chaseyarnall173/Self-Landing-Rocket/cad/out/mass_report.md

# SLR-1 mass report (from the CAD)

Generated by `python cad/build.py`. Masses are CAD volume x material density for made parts and
catalogue / estimated masses for bought parts (see `cad/slr1/catalog.py` and each part's
`mass_g`). **Weigh every part as you build and replace these numbers.**

| Configuration | Mass | CG station | Pitch inertia |
|---|---:|---:|---:|
| Liftoff (flight, legs stowed) | 1472 g | 970 mm | 0.247 kg m^2 |
| Same, landing configuration (legs and airbrakes out) | 1471 g | 997 mm | 0.283 kg m^2 |
| Dry (no motors) | 1294 g | 907 mm | 0.204 kg m^2 |

Model-rocket limit 1500 g: margin **28 g**.

## By mass-budget line

| Line | CAD (g) | CG station (mm) | Rev B paper budget (g) |
|---|---:|---:|---:|
| Nose cone + shoulder | 99.1 | 244 | 95 |
| Top airbrake petals, hinges, springs, latch servo | 21.3 | 471 | 35 |
| Backup chute + shock cord + spring/servo door | 96.9 | 630 | 85 |
| Avionics bay: boards, sensors, radio, battery | 111.7 | 768 | 105 |
| Couplers, bulkheads, motor-bay frame | 250.4 | 861 | 80 |
| Body tube | 402.0 | 923 | 374 |
| 4 landing legs + release | 100.5 | 1090 | 85 |
| Wiring, hardware, epoxy, paint | 37.8 | 1132 | 45 |
| Dual-motor TVC gimbal + 2 servos | 93.8 | 1427 | 130 |
| Ascent motor AeroTech F42T | 81.4 | 1429 | 76 |
| Landing motor AeroTech F25W | 97.2 | 1436 | 97 |
| 4 fins | 37.3 | 1472 | 45 |
| Exhaust-paddle throttle | 32.6 | 1493 | 50 |
| Lidar + bracket | 10.3 | 1504 | 12 |
| **Total** | **1472** | **970** | **1314** |

## Heaviest parts

| Part | Qty | Each (g) | Total (g) |
|---|---:|---:|---:|
| TUBE-04: Aft airframe, kraft tube (731 mm), fin and leg slots | 1 | 244.8 | 244.8 |
| NOSE-01: Nose cone, PETG tangent ogive 12.75 in + 2 in shoulder | 1 | 99.1 | 99.1 |
| MOTOR-F25W: AeroTech F25W landing motor (29 x 98 mm, 97 g) | 1 | 97.2 | 97.2 |
| MOTOR-F52C: AeroTech F52C ascent motor (29 x 111 mm, 81 g) | 1 | 81.4 | 81.4 |
| CPL-02: Avionics-bay coupler, LOC 3.9 in (160 mm) | 1 | 74.0 | 74.0 |
| TUBE-02: Recovery section, kraft tube (223 mm) with door cut-out | 1 | 67.6 | 67.6 |
| PETAL-01: Airbrake petal, 90 deg quadrant cut from the tube (149 mm) | 4 | 12.4 | 49.7 |
| CPL-01: Airbrake sleeve, LOC 3.9 in coupler (189 mm), latch slots + 4 lightening windows | 1 | 43.4 | 43.4 |
| CHUTE-30: Backup main parachute, 30 in nylon, Z-folded | 1 | 42.0 | 42.0 |
| LEG-STRUT: Leg strut, 8 x 7 mm pultruded carbon tube, 532 mm | 4 | 9.7 | 38.9 |
| FIN-01: Fin, 3/32 in aircraft birch ply, through-the-wall | 4 | 9.3 | 37.3 |
| LINER-AFT: Aft carbon liner, 2 wraps 200 gsm + epoxy (6 in), slotted | 1 | 35.0 | 35.0 |
| LIPO-2S: 2S 450 mAh LiPo | 1 | 30.0 | 30.0 |
| TUBE-01: Nose ring, LOC 3.9 in kraft tube (71 mm) | 1 | 24.0 | 24.0 |
| PERFBOARD: Perfboard 54 x 120 mm (flight computer carrier) | 1 | 19.2 | 19.2 |
| HARNESS-AFT: Servo / pyro harness to the motor bay (bundle) | 1 | 18.0 | 18.0 |
| AV-LID-F: Avionics bay forward lid, 1/8 in ply | 1 | 16.6 | 16.6 |
| RECOV-BH: Recovery bulkhead, 1/8 in ply, U-bolt + cable holes | 1 | 16.5 | 16.5 |
| AV-LID-A: Avionics bay aft lid, 1/8 in ply, grommet + cable holes | 1 | 16.4 | 16.4 |
| SLEEVE-29: 29 mm motor sleeve, kraft motor-mount tube, 113 mm (high-temp epoxy) | 2 | 8.1 | 16.2 |
| AV-SLED: Avionics sled, 1/8 in lite ply | 1 | 14.8 | 14.8 |
| LEG-CLEVIS: Leg hinge clevis with 55 deg stop, CF-nylon | 4 | 3.5 | 14.2 |
| CHUTE-NOMEX: Nomex chute protector (9 in), wrapped | 1 | 14.0 | 14.0 |
| SHOCK-CORD: Kevlar shock cord, 4.5 m, flaked and bundled | 1 | 14.0 | 14.0 |
| LEG-FOOT: Foot, TPU-95A lattice crush pad (30 mm) | 4 | 3.4 | 13.7 |

## Densities used

| Material | g/cm^3 |
|---|---:|
| aluminium | 2.7 |
| carbon | 1.55 |
| ceramic | 2.3 |
| cf_nylon | 1.17 |
| epoxy | 1.15 |
| kraft | 0.844 |
| kraft_cpl | 0.844 |
| liteply | 0.45 |
| perfboard | 1.85 |
| petg | 1.27 |
| ply | 0.68 |
| polycarb | 1.2 |
| steel | 7.9 |
| tpu | 1.21 |
