chaseyarnall173/Self-Landing-Rocket/docs/14-sections.md

# 14. Section by section

Every part of SLR-1, bay by bay: 133 parts in 8 sections. Each section has X-ray views
rendered from the CAD, with the outer skin see-through and every part numbered. The numbers match
the table under the views. A dashed leader points to a part hidden behind others.

Masses are from the CAD (catalogue masses for bought parts). *Qty* counts every copy on the rocket.
The same guide is on the project website, and the interactive viewer
([docs/13](13-cad.md)) has a *Sections* mode that draws these callouts live.

- [14.1 Nose cone](#141-nose-cone)
- [14.2 Top airbrakes](#142-top-airbrakes)
- [14.3 Backup chute bay](#143-backup-chute-bay)
- [14.4 Avionics bay](#144-avionics-bay)
- [14.5 Aft airframe and fins](#145-aft-airframe-and-fins)
- [14.6 Landing legs](#146-landing-legs)
- [14.7 Motor bay and TVC gimbal](#147-motor-bay-and-tvc-gimbal)
- [14.8 Exhaust-paddle throttle](#148-exhaust-paddle-throttle)

## 14.1 Nose cone

The printed nose is the top 323 mm of the rocket. It comes off (three screws) so you can reach the airbrake latch.

**2 parts, 4 pieces, 101 g.**

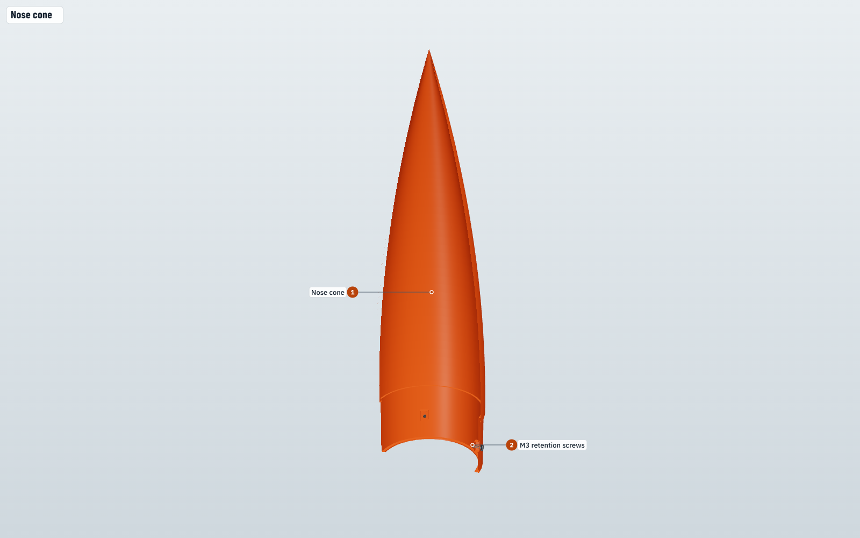
[picture p14: docs/img/sections/nose-1.png]
Nose cone


| | # | Part | What it does | Made from | Qty | Mass (g) |
|---|---:|---|---|---|---:|---:|
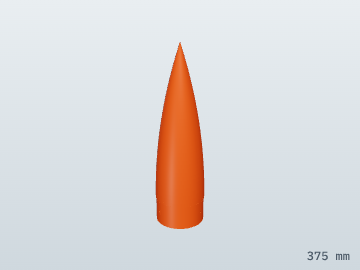
[picture p15: docs/img/parts/NOSE-01.png]
Nose cone
|  | 1 | **Nose cone**<br>`NOSE-01` | Printed PETG tangent ogive, 0.8 mm wall. Its 2 in shoulder slides into the nose ring. Three printed bosses inside take the retention screws. | Print · PETG | 1 | 99 |
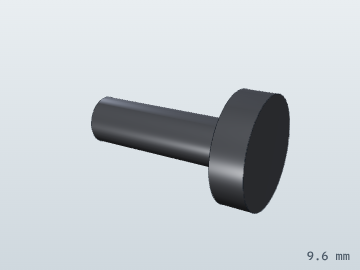
[picture p16: docs/img/parts/NOSE-SCREW.png]
M3 retention screws
|  | 2 | **M3 retention screws**<br>`NOSE-SCREW` | Hold the nose on through the nose ring. Take them out to lift the nose off and reach the airbrake latch. | Buy · steel | 3 | 0.5 |

## 14.2 Top airbrakes

Four petals cut from the body tube, just below the nose. At apogee one servo turns a latch ring and springs flip all four out to 90°. Drag at the top keeps the falling rocket tail-down, the way a shuttlecock's feathers keep it cork-first.

**13 parts, 31 pieces, 138 g.**

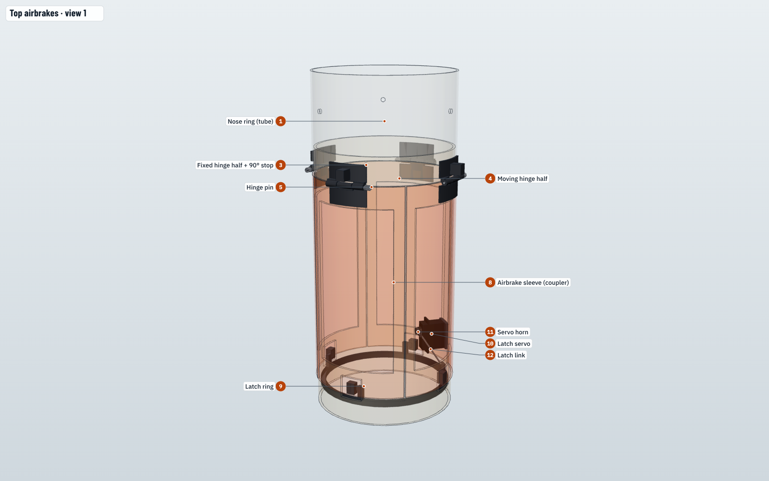
[picture p17: docs/img/sections/airbrakes-1.png]
Top airbrakes: view 1


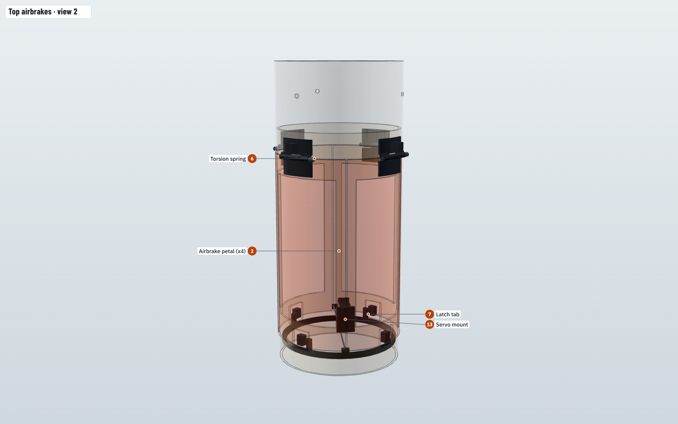
[picture p18: docs/img/sections/airbrakes-2.png]
Top airbrakes: view 2


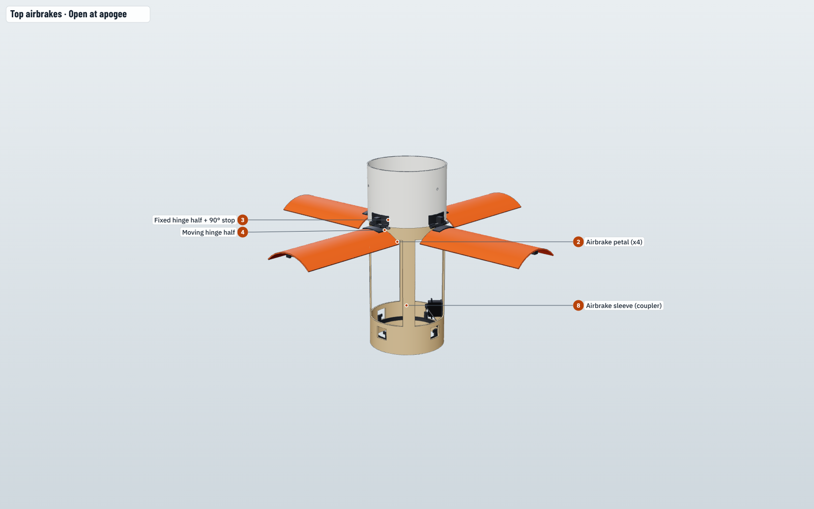
[picture p19: docs/img/sections/airbrakes-3.png]
Top airbrakes: Open at apogee


| | # | Part | What it does | Made from | Qty | Mass (g) |
|---|---:|---|---|---|---:|---:|
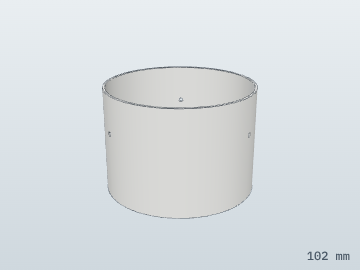
[picture p20: docs/img/parts/TUBE-01.png]
Nose ring (tube)
|  | 1 | **Nose ring (tube)**<br>`TUBE-01` | The 71 mm piece of body tube between the nose and the petals. The fixed hinge halves are bonded to it, and it is glued 19 mm onto the airbrake sleeve. | Cut from tube · kraft phenolic tube | 1 | 24 |
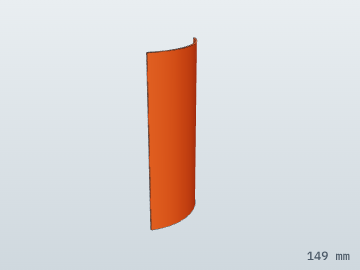
[picture p21: docs/img/parts/PETAL-01.png]
Airbrake petal (x4)
|  | 2 | **Airbrake petal (x4)**<br>`PETAL-01` | A 90° quadrant cut from the body tube, 150 mm long. Flush with the skin on the way up; springs out to 90° at apogee so the rocket falls tail-first and stable at ~18 m/s. | Cut from tube · kraft phenolic tube | 4 | 12 |
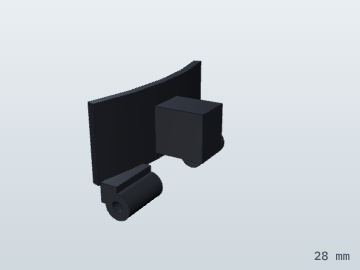
[picture p22: docs/img/parts/PETAL-HINGE-F.png]
Fixed hinge half + 90° stop
|  | 3 | **Fixed hinge half + 90° stop**<br>`PETAL-HINGE-F` | Printed CF-nylon leaf bonded to the nose ring with two knuckles. Its stop block catches the open petal at 90° against ~3 N of air load. | Print · CF-nylon | 4 | 1.1 |
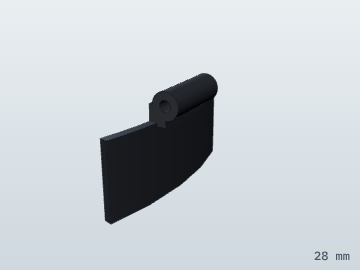
[picture p23: docs/img/parts/PETAL-HINGE-M.png]
Moving hinge half
|  | 4 | **Moving hinge half**<br>`PETAL-HINGE-M` | Printed CF-nylon leaf bonded to the petal's forward edge; its middle knuckle turns on the hinge pin. | Print · CF-nylon | 4 | 0.6 |
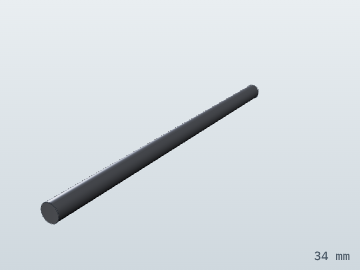
[picture p24: docs/img/parts/PETAL-PIN.png]
|  | 5 | **Hinge pin**<br>`PETAL-PIN` | 1.6 mm stainless pin through the three knuckles; it also carries the torsion spring. | Buy · steel | 4 | 0.5 |
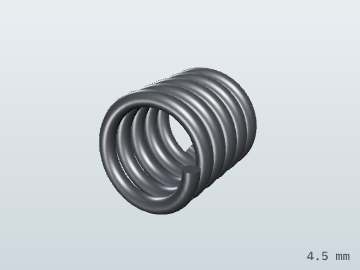
[picture p25: docs/img/parts/PETAL-SPRING.png]
Torsion spring
|  | 6 | **Torsion spring**<br>`PETAL-SPRING` | About 0.1 N·m of preload that flips the petal open in under 0.2 s when the latch lets go. | Buy · steel | 4 | 0.1 |
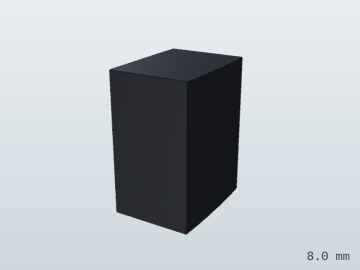
[picture p26: docs/img/parts/PETAL-TAB.png]
Latch tab
|  | 7 | **Latch tab**<br>`PETAL-TAB` | Printed tab bonded inside the petal's aft edge. It pokes through the sleeve slot, and its notch is where the latch-ring finger sits. | Print · CF-nylon | 4 | 0.2 |
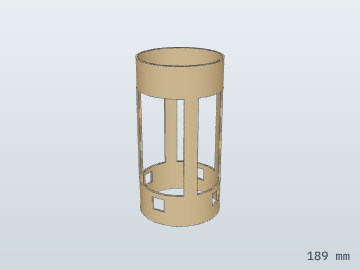
[picture p27: docs/img/parts/CPL-01.png]
Airbrake sleeve (coupler)
|  | 8 | **Airbrake sleeve (coupler)**<br>`CPL-01` | 189 mm LOC coupler that holds the nose ring and the recovery section together across the petal band. Windows under each petal save 33 g; slots let the petal tabs through. | Cut from tube · kraft coupler tube | 1 | 43 |
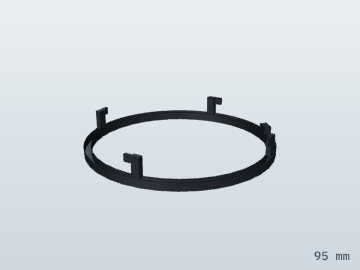
[picture p28: docs/img/parts/LATCH-RING.png]
Latch ring
|  | 9 | **Latch ring**<br>`LATCH-RING` | Printed ring inside the sleeve with one finger per petal. Turning it a few degrees slides all four fingers out of the tab notches at once. | Print · CF-nylon | 1 | 5.2 |
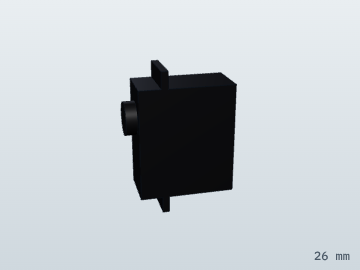
[picture p29: docs/img/parts/SERVO-LATCH.png]
Latch servo
|  | 10 | **Latch servo**<br>`SERVO-LATCH` | 4.3 g micro servo (pin 7) that turns the latch ring at apogee. | Buy · servo | 1 | 4.3 |
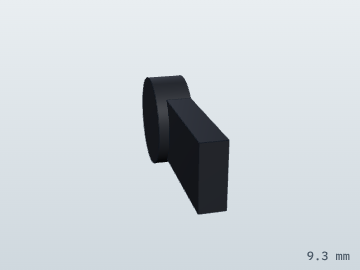
[picture p30: docs/img/parts/HORN-LATCH.png]
Servo horn
|  | 11 | **Servo horn**<br>`HORN-LATCH` | Arm on the latch servo's output shaft. | Buy · CF-nylon | 1 | 0.3 |
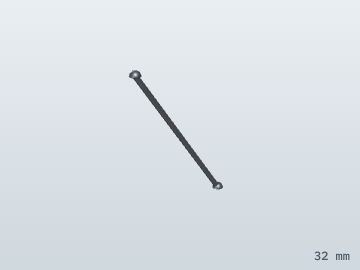
[picture p31: docs/img/parts/LATCH-LINK.png]
Latch link
|  | 12 | **Latch link**<br>`LATCH-LINK` | Wire link with ball ends from the horn to the latch ring's lug. | Buy · steel | 1 | 0.3 |
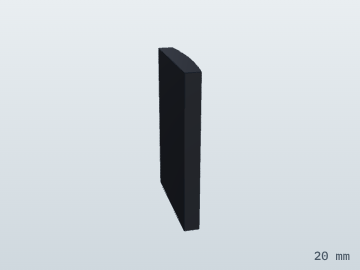
[picture p32: docs/img/parts/LATCH-SERVO-BRKT.png]
Servo mount
|  | 13 | **Servo mount**<br>`LATCH-SERVO-BRKT` | Printed block that bonds the latch servo to the solid strip of sleeve between two windows. | Print · CF-nylon | 1 | 0.7 |

## 14.3 Backup chute bay

Abort-only recovery. A servo pulls a pin, the door swings open and two springs push the 30 in chute out. In a normal flight this bay never opens.

**22 parts, 25 pieces, 193 g.**

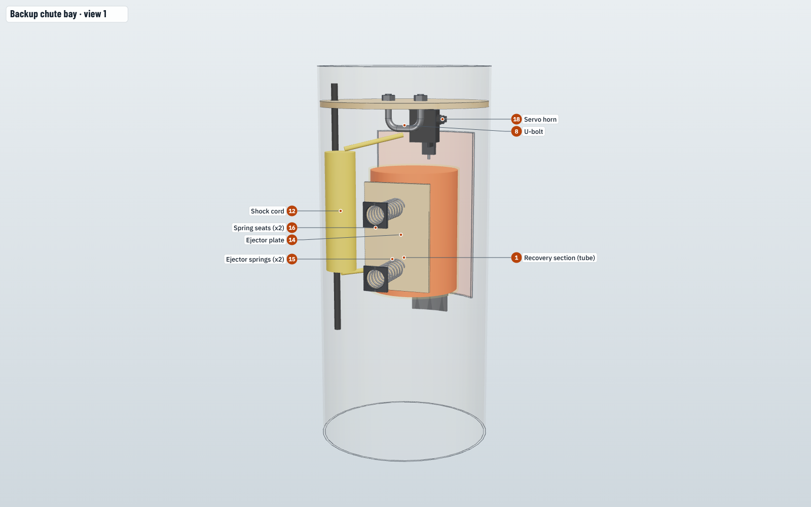
[picture p33: docs/img/sections/chute-1.png]
Backup chute bay: view 1


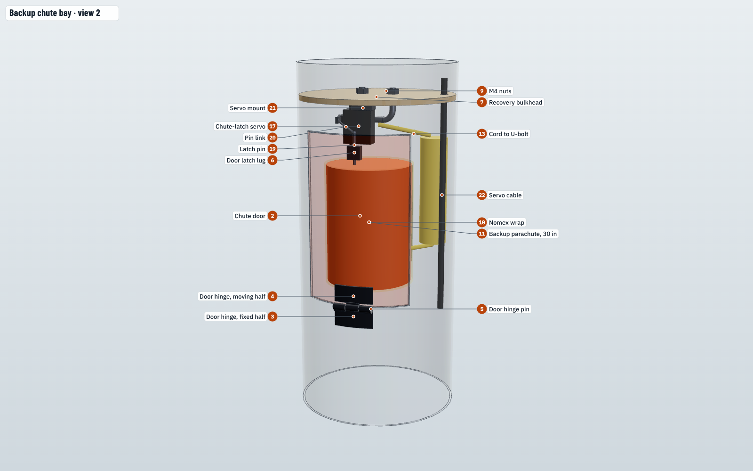
[picture p34: docs/img/sections/chute-2.png]
Backup chute bay: view 2


| | # | Part | What it does | Made from | Qty | Mass (g) |
|---|---:|---|---|---|---:|---:|
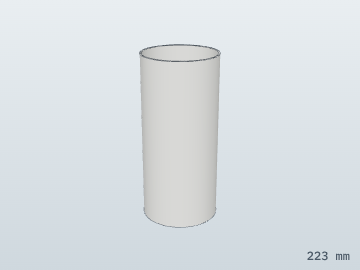
[picture p35: docs/img/parts/TUBE-02.png]
Recovery section (tube)
|  | 1 | **Recovery section (tube)**<br>`TUBE-02` | 223 mm of body tube between the petals and the avionics bay. It holds the chute bay and has the door cut out of it. | Cut from tube · kraft phenolic tube | 1 | 68 |
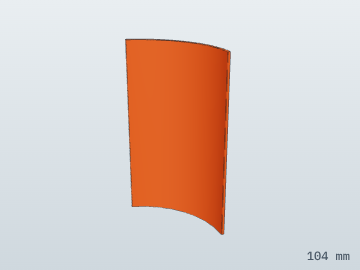
[picture p36: docs/img/parts/DOOR-01.png]
Chute door
|  | 2 | **Chute door**<br>`DOOR-01` | 105 x 70 mm panel cut from the tube. It is latched shut in a normal flight; in an abort it swings open and the chute is pushed out. | Cut from tube · kraft phenolic tube | 1 | 7.6 |
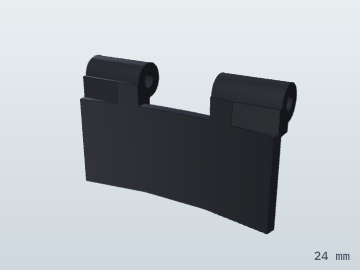
[picture p37: docs/img/parts/DOOR-HINGE-F.png]
Door hinge, fixed half
|  | 3 | **Door hinge, fixed half**<br>`DOOR-HINGE-F` | Printed hinge leaf on the tube at the door's aft edge. | Print · CF-nylon | 1 | 0.6 |
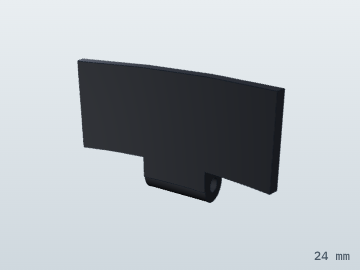
[picture p38: docs/img/parts/DOOR-HINGE-M.png]
Door hinge, moving half
|  | 4 | **Door hinge, moving half**<br>`DOOR-HINGE-M` | Printed hinge leaf on the door. | Print · CF-nylon | 1 | 0.5 |
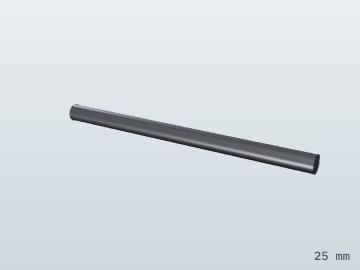
[picture p39: docs/img/parts/DOOR-PIN.png]
Door hinge pin
|  | 5 | **Door hinge pin**<br>`DOOR-PIN` | 1.6 mm stainless pin through the door hinge. | Buy · steel | 1 | 0.4 |
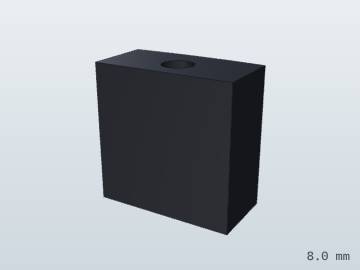
[picture p40: docs/img/parts/DOOR-LUG.png]
Door latch lug
|  | 6 | **Door latch lug**<br>`DOOR-LUG` | Printed lug inside the door's forward edge; the chute-latch pin passes through it to hold the door shut. | Print · CF-nylon | 1 | 0.3 |
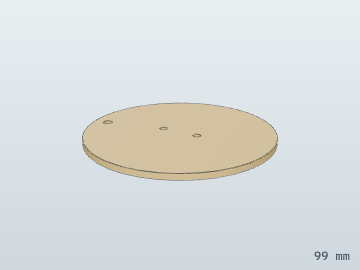
[picture p41: docs/img/parts/RECOV-BH.png]
Recovery bulkhead
|  | 7 | **Recovery bulkhead**<br>`RECOV-BH` | 1/8 in ply disc glued in the tube at the top of the chute bay. It carries the U-bolt and separates the bay from the airbrake sleeve. | Cut · birch ply | 1 | 17 |
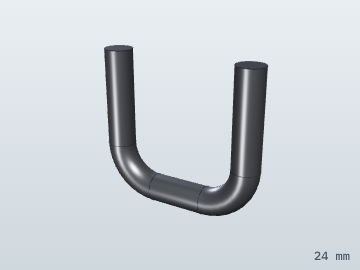
[picture p42: docs/img/parts/UBOLT.png]
U-bolt
|  | 8 | **U-bolt**<br>`UBOLT` | M4 U-bolt: the strong point the shock cord and chute hang from. | Buy · steel | 1 | 8.0 |
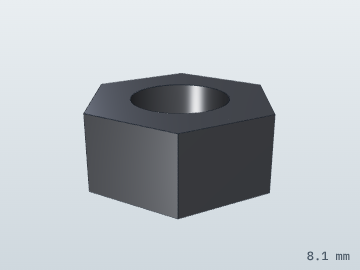
[picture p43: docs/img/parts/NUT-M4.png]
M4 nuts
|  | 9 | **M4 nuts**<br>`NUT-M4` | Clamp the U-bolt to the bulkhead. | Buy · steel | 2 | 1.2 |
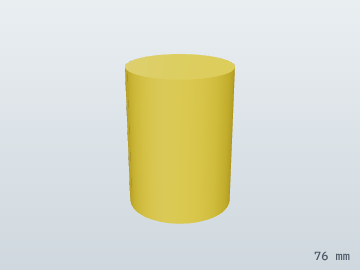
[picture p44: docs/img/parts/CHUTE-NOMEX.png]
Nomex wrap
|  | 10 | **Nomex wrap**<br>`CHUTE-NOMEX` | Fire-resistant blanket wrapped around the folded chute, in case the motors' heat reaches it. | Buy · Nomex | 1 | 14 |
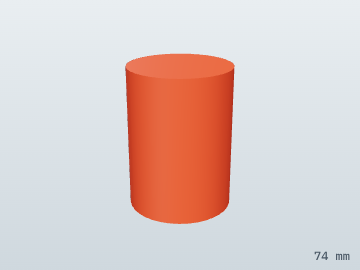
[picture p45: docs/img/parts/CHUTE-30.png]
Backup parachute, 30 in
|  | 11 | **Backup parachute, 30 in**<br>`CHUTE-30` | Nylon chute, Z-folded to about 54 x 74 mm. Used only in an abort; it brings 1.4 kg down at about 5-6 m/s. | Buy · ripstop nylon | 1 | 42 |
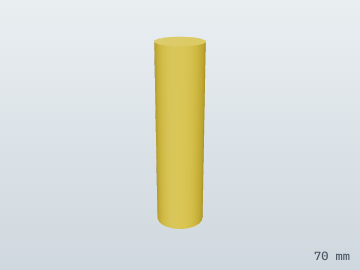
[picture p46: docs/img/parts/SHOCK-CORD.png]
Shock cord
|  | 12 | **Shock cord**<br>`SHOCK-CORD` | 4.5 m of Kevlar, flaked and bundled. It absorbs the snatch when the chute opens. | Buy · Kevlar | 1 | 14 |
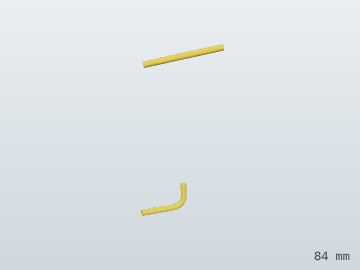
[picture p47: docs/img/parts/SHOCK-CORD-RUN.png]
Cord to U-bolt
|  | 13 | **Cord to U-bolt**<br>`SHOCK-CORD-RUN` | The ends of the shock cord: one tied to the U-bolt, one to the chute's riser. | Buy · Kevlar | 1 | 2.0 |
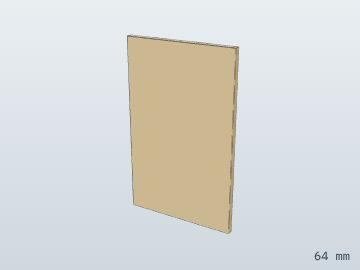
[picture p48: docs/img/parts/EJECT-PLATE.png]
Ejector plate
|  | 14 | **Ejector plate**<br>`EJECT-PLATE` | Thin ply plate on two springs that pushes the chute pack toward the door. | Cut · birch ply | 1 | 3.5 |
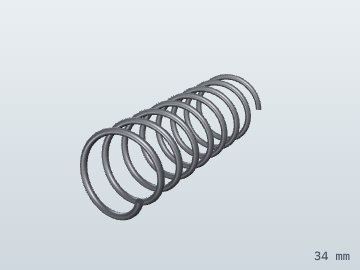
[picture p49: docs/img/parts/EJECT-SPRING.png]
Ejector springs (x2)
|  | 15 | **Ejector springs (x2)**<br>`EJECT-SPRING` | Compression springs, ~20 N each, that throw the chute out when the door opens. | Buy · steel | 2 | 1.5 |
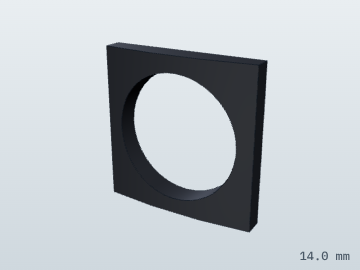
[picture p50: docs/img/parts/EJECT-CUP.png]
Spring seats (x2)
|  | 16 | **Spring seats (x2)**<br>`EJECT-CUP` | Printed cups bonded to the far wall that locate the ejector springs. | Print · CF-nylon | 2 | 0.2 |
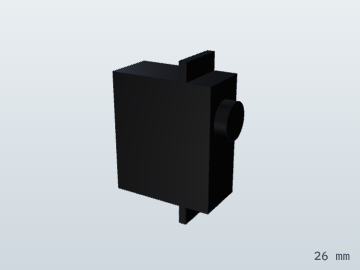
[picture p51: docs/img/parts/SERVO-CHUTE.png]
Chute-latch servo
|  | 17 | **Chute-latch servo**<br>`SERVO-CHUTE` | 4.3 g micro servo (pin 29) under the bulkhead. It pulls the latch pin to open the door. | Buy · servo | 1 | 4.3 |
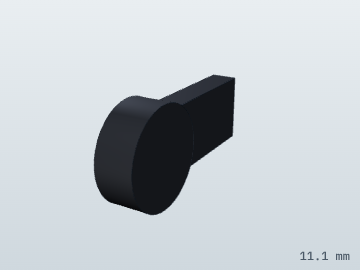
[picture p52: docs/img/parts/HORN-CHUTE.png]
Servo horn
|  | 18 | **Servo horn**<br>`HORN-CHUTE` | Arm on the chute-latch servo. | Buy · CF-nylon | 1 | 0.3 |
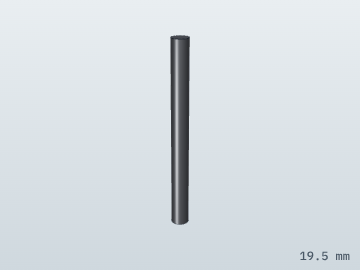
[picture p53: docs/img/parts/CHUTE-PIN.png]
Latch pin
|  | 19 | **Latch pin**<br>`CHUTE-PIN` | 1.8 mm steel pin through the door lug. Pulling it releases the door. | Buy · steel | 1 | 0.4 |
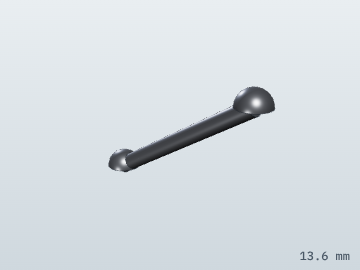
[picture p54: docs/img/parts/CHUTE-LINK.png]
Pin link
|  | 20 | **Pin link**<br>`CHUTE-LINK` | Wire link from the servo horn to the latch pin. | Buy · steel | 1 | 0.4 |
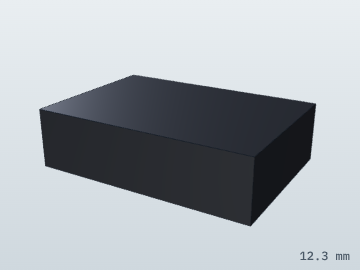
[picture p55: docs/img/parts/CHUTE-SERVO-BRKT.png]
Servo mount
|  | 21 | **Servo mount**<br>`CHUTE-SERVO-BRKT` | Printed block that bonds the servo to the bulkhead. | Print · CF-nylon | 1 | 0.4 |
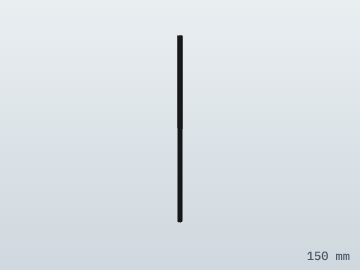
[picture p56: docs/img/parts/CABLE-FWD.png]
Servo cable
|  | 22 | **Servo cable**<br>`CABLE-FWD` | Runs the airbrake-latch and chute-latch servo leads up from the avionics bay through the bulkhead. | Buy · electronics | 1 | 4.0 |

## 14.4 Avionics bay

The flight computer, sensors, radio and battery on a sled that slides out. The switch band around the middle carries the arm key, the power switch, the static ports and the leg-release pin.

**37 parts, 59 pieces, 261 g.**

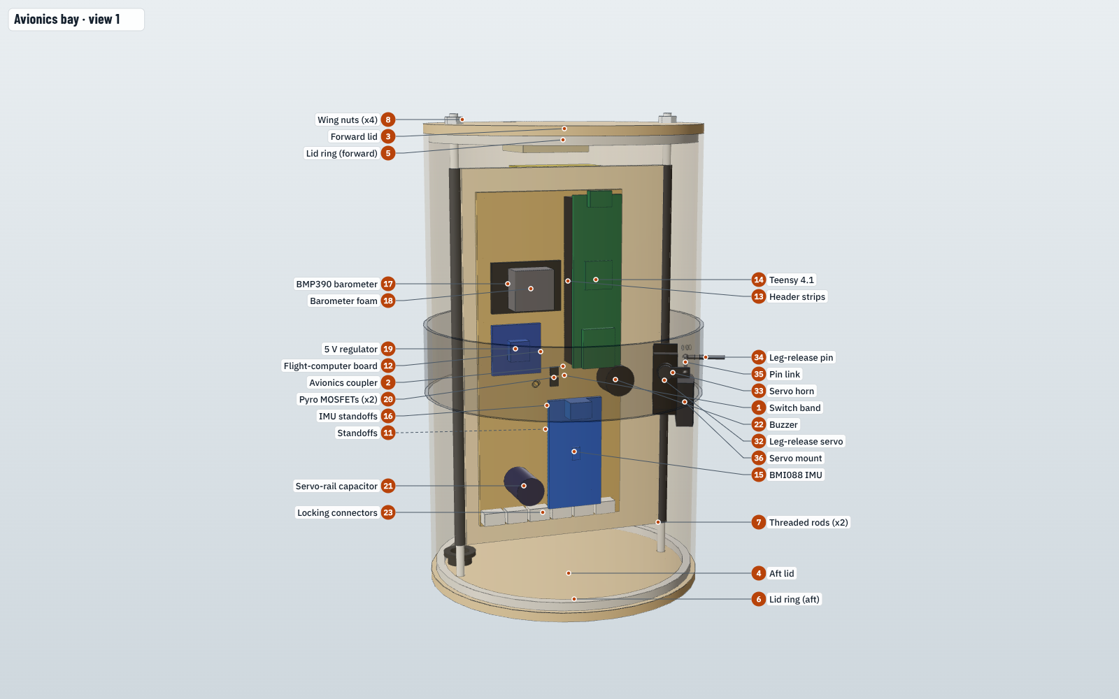
[picture p57: docs/img/sections/avionics-1.png]
Avionics bay: view 1


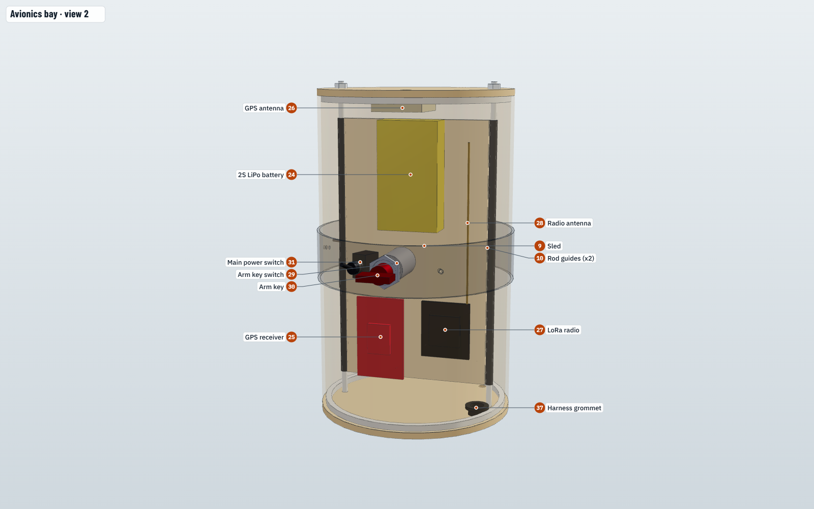
[picture p58: docs/img/sections/avionics-2.png]
Avionics bay: view 2


| | # | Part | What it does | Made from | Qty | Mass (g) |
|---|---:|---|---|---|---:|---:|
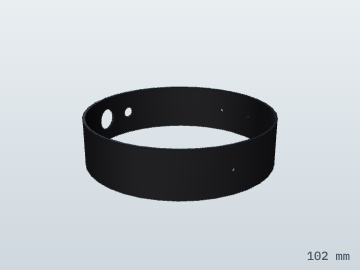
[picture p59: docs/img/parts/TUBE-03.png]
Switch band
|  | 1 | **Switch band**<br>`TUBE-03` | 25 mm ring of body tube glued around the middle of the avionics coupler. It carries the arm key, main switch, leg-release pin and three static ports. | Cut from tube · kraft phenolic tube | 1 | 8.3 |
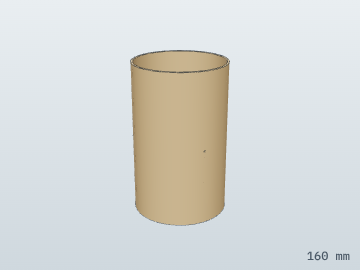
[picture p60: docs/img/parts/CPL-02.png]
Avionics coupler
|  | 2 | **Avionics coupler**<br>`CPL-02` | 160 mm LOC coupler that is the avionics bay. It joins the recovery section to the aft tube. | Cut from tube · kraft coupler tube | 1 | 74 |
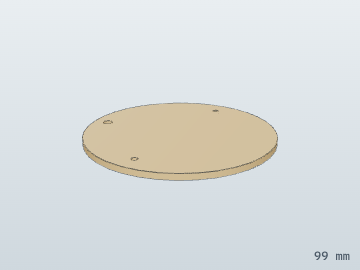
[picture p61: docs/img/parts/AV-LID-F.png]
Forward lid
|  | 3 | **Forward lid**<br>`AV-LID-F` | 1/8 in ply disc that closes the top of the bay; the GPS patch hangs under it. | Cut · birch ply | 1 | 17 |
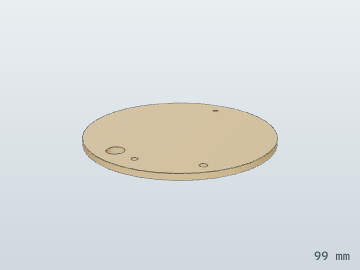
[picture p62: docs/img/parts/AV-LID-A.png]
Aft lid
|  | 4 | **Aft lid**<br>`AV-LID-A` | 1/8 in ply disc that closes the bottom of the bay, with the harness grommet and lidar-cable hole. | Cut · birch ply | 1 | 16 |
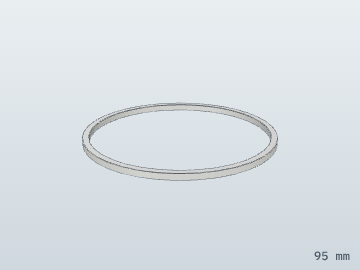
[picture p63: docs/img/parts/AV-LID-RING-F.png]
Lid ring (forward)
|  | 5 | **Lid ring (forward)**<br>`AV-LID-RING-F` | Printed ring that keys the forward lid into the coupler. | Print · PETG | 1 | 3.2 |
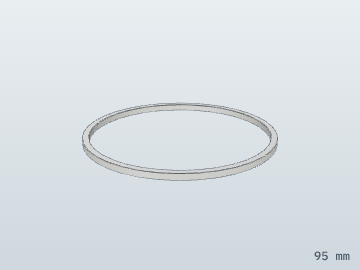
[picture p64: docs/img/parts/AV-LID-RING-A.png]
Lid ring (aft)
|  | 6 | **Lid ring (aft)**<br>`AV-LID-RING-A` | Printed ring that keys the aft lid into the coupler. | Print · PETG | 1 | 3.2 |
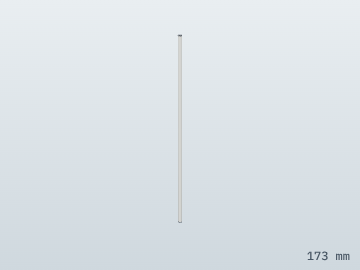
[picture p65: docs/img/parts/AV-ROD.png]
Threaded rods (x2)
|  | 7 | **Threaded rods (x2)**<br>`AV-ROD` | M3 nylon rods that clamp the two lids to the coupler and guide the sled. | Buy · CF-nylon | 2 | 1.4 |
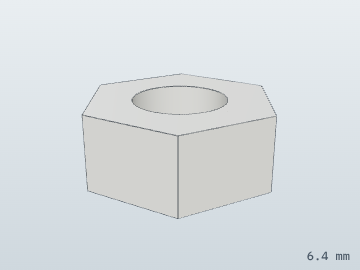
[picture p66: docs/img/parts/NUT-M3.png]
Wing nuts (x4)
|  | 8 | **Wing nuts (x4)**<br>`NUT-M3` | Nylon wing nuts on the rod ends; finger-tight so the bay opens on the field. | Buy · CF-nylon | 4 | 0.2 |
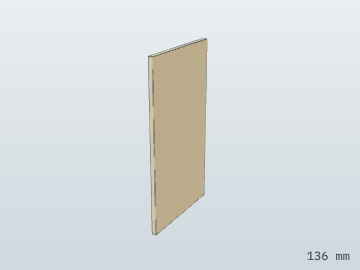
[picture p67: docs/img/parts/AV-SLED.png]
Sled
|  | 9 | **Sled**<br>`AV-SLED` | 1/8 in lite-ply board everything electronic mounts to. It slides out on the rods. | Cut · lite ply | 1 | 15 |
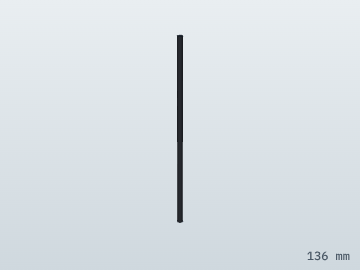
[picture p68: docs/img/parts/AV-SLED-TUBE.png]
Rod guides (x2)
|  | 10 | **Rod guides (x2)**<br>`AV-SLED-TUBE` | Printed tubes along the sled edges that ride on the threaded rods. | Print · CF-nylon | 2 | 0.7 |
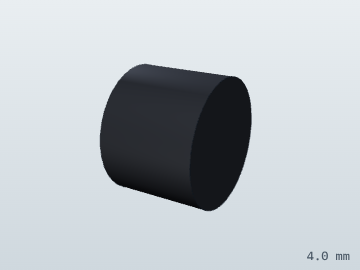
[picture p69: docs/img/parts/STANDOFF-3.png]
Standoffs
|  | 11 | **Standoffs**<br>`STANDOFF-3` | 3 mm nylon spacers under the boards. | Buy · CF-nylon | 12 | 0.1 |
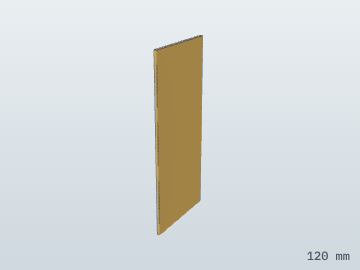
[picture p70: docs/img/parts/PERFBOARD.png]
Flight-computer board
|  | 12 | **Flight-computer board**<br>`PERFBOARD` | 54 x 120 mm perfboard carrying the Teensy, sensors, regulator and pyro channels. Becomes a PCB once the design is frozen. | Buy · perfboard | 1 | 19 |
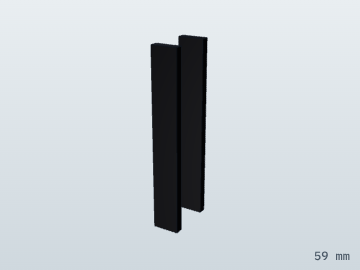
[picture p71: docs/img/parts/HEADERS.png]
Header strips
|  | 13 | **Header strips**<br>`HEADERS` | Sockets the Teensy plugs into, so it can be swapped. | Buy · electronics | 1 | 2.0 |
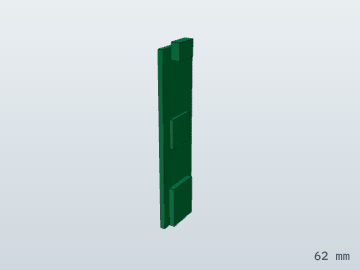
[picture p72: docs/img/parts/TEENSY-41.png]
Teensy 4.1
|  | 14 | **Teensy 4.1**<br>`TEENSY-41` | The flight computer: a 600 MHz microcontroller that runs the 1 kHz state estimator and re-plans the landing burn 50 times a second, logging everything to its microSD card. | Buy · circuit board | 1 | 6.0 |
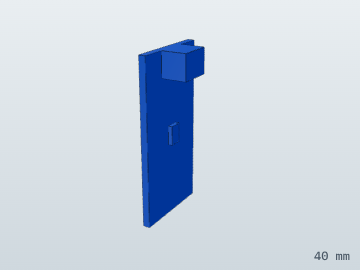
[picture p73: docs/img/parts/IMU-BMI088.png]
BMI088 IMU
|  | 15 | **BMI088 IMU**<br>`IMU-BMI088` | Accelerometer (±24 g) and gyro. Mounted near the rocket's axis so it reads attitude and acceleration cleanly. | Buy · circuit board | 1 | 3.0 |
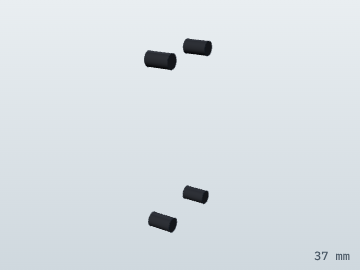
[picture p74: docs/img/parts/STANDOFF-5.png]
IMU standoffs
|  | 16 | **IMU standoffs**<br>`STANDOFF-5` | Four 5 mm standoffs that mount the IMU rigidly. | Buy · CF-nylon | 1 | 0.3 |
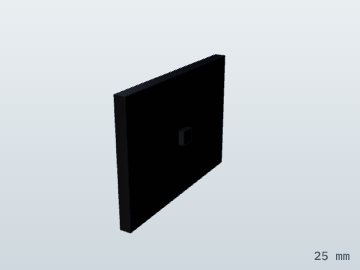
[picture p75: docs/img/parts/BARO-BMP390.png]
BMP390 barometer
|  | 17 | **BMP390 barometer**<br>`BARO-BMP390` | Measures air pressure for altitude through the whole flight, through the static ports. | Buy · circuit board | 1 | 1.5 |
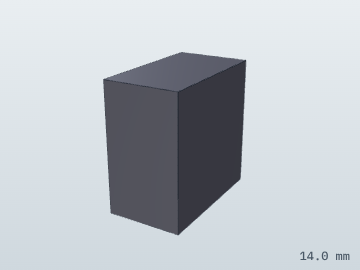
[picture p76: docs/img/parts/BARO-FOAM.png]
Barometer foam
|  | 18 | **Barometer foam**<br>`BARO-FOAM` | Open-cell foam that shields the barometer from gusts and light. | Buy · foam | 1 | 0.1 |
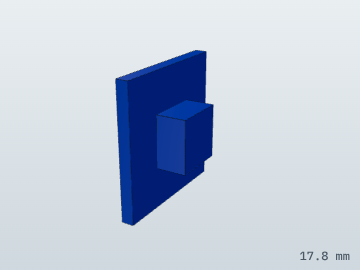
[picture p77: docs/img/parts/BUCK-5V.png]
5 V regulator
|  | 19 | **5 V regulator**<br>`BUCK-5V` | Steps the 2S battery down to 5 V for the Teensy, lidar and micro servos. | Buy · circuit board | 1 | 3.0 |
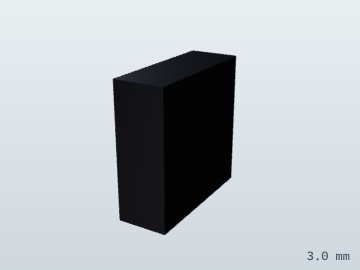
[picture p78: docs/img/parts/FET-AO3400.png]
Pyro MOSFETs (x2)
|  | 20 | **Pyro MOSFETs (x2)**<br>`FET-AO3400` | Switch the two landing-motor igniters, fired together. | Buy · electronics | 2 | 0.1 |
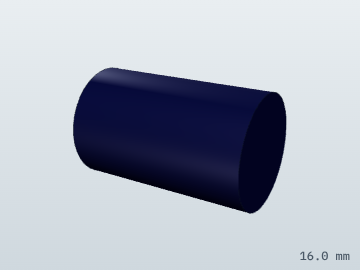
[picture p79: docs/img/parts/CAP-1000U.png]
Servo-rail capacitor
|  | 21 | **Servo-rail capacitor**<br>`CAP-1000U` | 1000 µF reservoir that keeps servo current spikes from browning out the computer. | Buy · electronics | 1 | 3.0 |
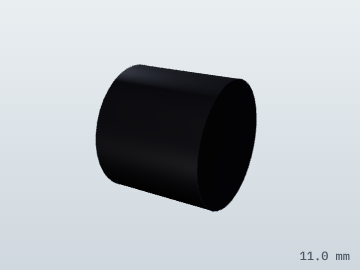
[picture p80: docs/img/parts/BUZZER.png]
Buzzer
|  | 22 | **Buzzer**<br>`BUZZER` | Beeps the arm state and status on the pad and helps you find the rocket. | Buy · electronics | 1 | 2.0 |
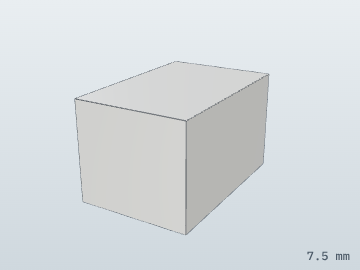
[picture p81: docs/img/parts/JST-GH.png]
Locking connectors
|  | 23 | **Locking connectors**<br>`JST-GH` | JST-GH headers for servos, sensors and the pyro leads; they can't shake loose. | Buy · electronics | 6 | 0.3 |
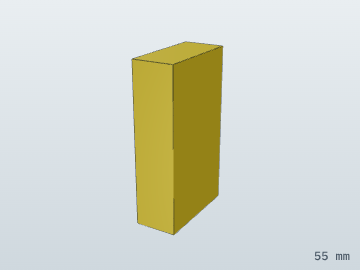
[picture p82: docs/img/parts/LIPO-2S.png]
2S LiPo battery
|  | 24 | **2S LiPo battery**<br>`LIPO-2S` | 450 mAh, 7.4 V pack that powers everything for about 15 minutes of pad time. | Buy · LiPo | 1 | 30 |
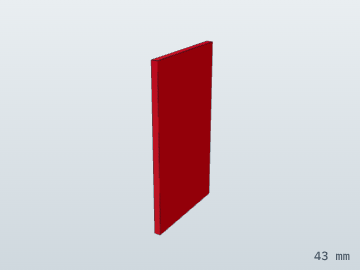
[picture p83: docs/img/parts/GPS-M9N.png]
GPS receiver
|  | 25 | **GPS receiver**<br>`GPS-M9N` | u-blox NEO-M9N; gives the sideways velocity the landing burn cancels. | Buy · circuit board | 1 | 6.0 |
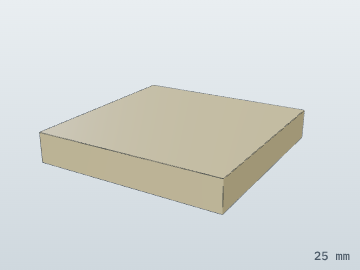
[picture p84: docs/img/parts/GPS-PATCH.png]
GPS antenna
|  | 26 | **GPS antenna**<br>`GPS-PATCH` | 25 mm ceramic patch under the forward lid, facing the sky. | Buy · ceramic | 1 | 9.0 |
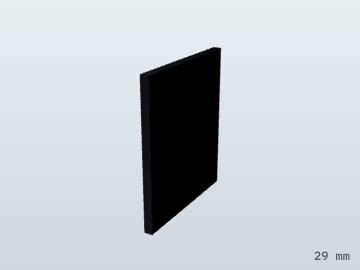
[picture p85: docs/img/parts/LORA-RFM95W.png]
LoRa radio
|  | 27 | **LoRa radio**<br>`LORA-RFM95W` | 915 MHz telemetry link to the ground station. | Buy · circuit board | 1 | 3.0 |
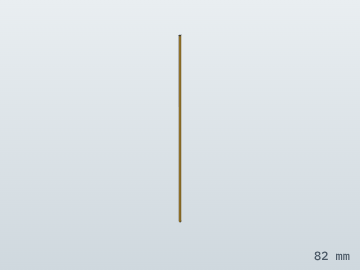
[picture p86: docs/img/parts/LORA-ANT.png]
Radio antenna
|  | 28 | **Radio antenna**<br>`LORA-ANT` | 82 mm quarter-wave wire antenna. | Buy · brass | 1 | 0.5 |
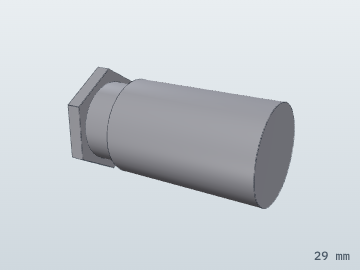
[picture p87: docs/img/parts/ARM-KEY-SW.png]
Arm key switch
|  | 29 | **Arm key switch**<br>`ARM-KEY-SW` | Physical switch in the igniter power line. Key out means the landing motor cannot fire, whatever the software does. | Buy · electronics | 1 | 12 |
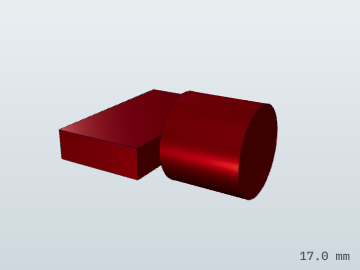
[picture p88: docs/img/parts/ARM-KEY.png]
Arm key
|  | 30 | **Arm key**<br>`ARM-KEY` | Removable key; it goes in only at the pad. | Buy · steel | 1 | 4.0 |
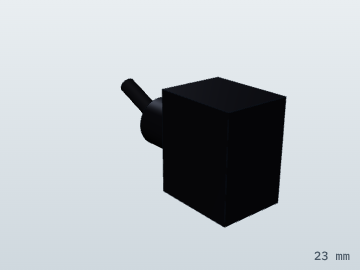
[picture p89: docs/img/parts/MAIN-SW.png]
Main power switch
|  | 31 | **Main power switch**<br>`MAIN-SW` | Turns the flight computer on. | Buy · electronics | 1 | 4.0 |
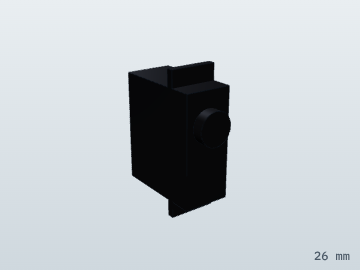
[picture p90: docs/img/parts/SERVO-LEGPIN.png]
Leg-release servo
|  | 32 | **Leg-release servo**<br>`SERVO-LEGPIN` | 4.3 g micro servo (pin 28) that pulls the leg-release pin at 12 m. | Buy · servo | 1 | 4.3 |
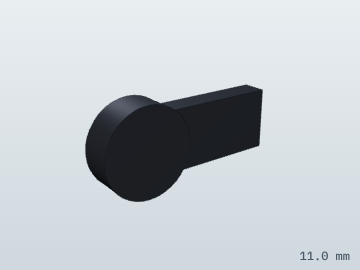
[picture p91: docs/img/parts/HORN-LEGPIN.png]
Servo horn
|  | 33 | **Servo horn**<br>`HORN-LEGPIN` | Arm on the leg-release servo. | Buy · CF-nylon | 1 | 0.3 |
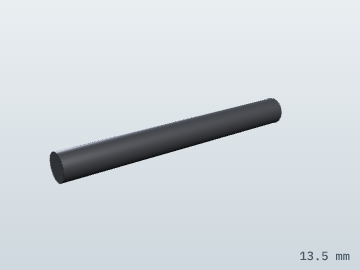
[picture p92: docs/img/parts/LEG-RELEASE-PIN.png]
Leg-release pin
|  | 34 | **Leg-release pin**<br>`LEG-RELEASE-PIN` | 1.5 mm steel pin poking out of the switch band. The Kevlar loop that holds the folded legs hooks over it. | Buy · steel | 1 | 0.2 |
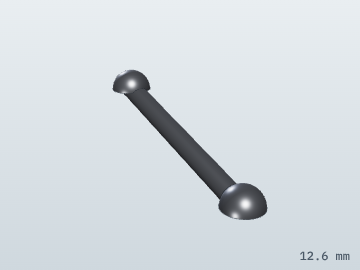
[picture p93: docs/img/parts/LEGPIN-LINK.png]
Pin link
|  | 35 | **Pin link**<br>`LEGPIN-LINK` | Wire link from the servo horn to the release pin. | Buy · steel | 1 | 0.3 |
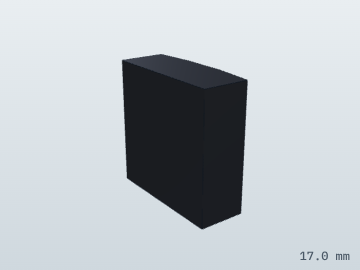
[picture p94: docs/img/parts/LEGPIN-BRKT.png]
|  | 36 | **Servo mount**<br>`LEGPIN-BRKT` | Printed block that bonds the leg-release servo to the coupler wall. | Print · CF-nylon | 1 | 1.9 |
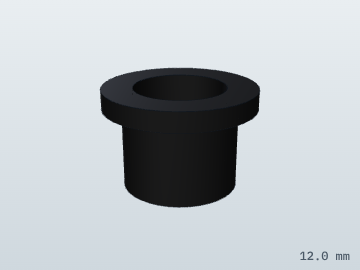
[picture p95: docs/img/parts/GROMMET.png]
Harness grommet
|  | 37 | **Harness grommet**<br>`GROMMET` | Printed TPU grommet where the servo and pyro wiring leaves the bay. | Print · TPU-95A | 1 | 0.3 |

## 14.5 Aft airframe and fins

The long aft tube carries the fins and the legs, and the wiring from the avionics bay runs down its wall to the motor bay. A carbon liner stiffens the last 6 in.

**6 parts, 16 pieces, 349 g.**

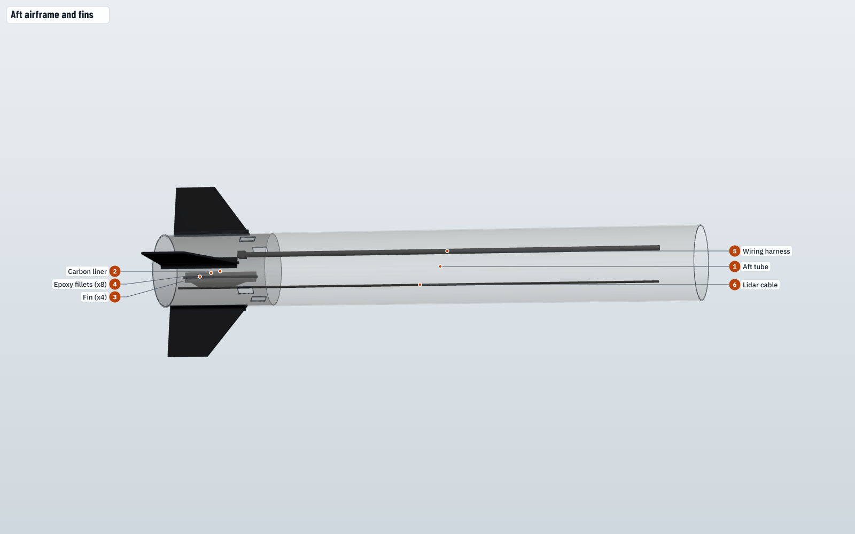
[picture p96: docs/img/sections/aft-1.png]
Aft airframe and fins


| | # | Part | What it does | Made from | Qty | Mass (g) |
|---|---:|---|---|---|---:|---:|
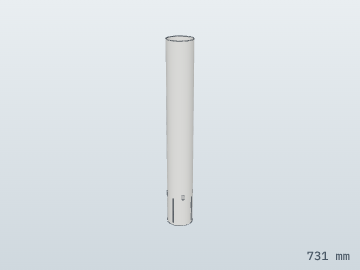
[picture p97: docs/img/parts/TUBE-04.png]
Aft tube
|  | 1 | **Aft tube**<br>`TUBE-04` | 731 mm of body tube from the avionics bay to the tail. Slotted for the fins and leg clevises. | Cut from tube · kraft phenolic tube | 1 | 245 |
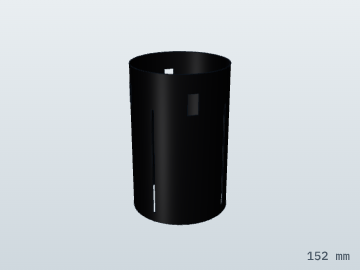
[picture p98: docs/img/parts/LINER-AFT.png]
Carbon liner
|  | 2 | **Carbon liner**<br>`LINER-AFT` | Two wraps of carbon cloth inside the last 6 in. They stiffen the tube where the fins, legs and thrust plate load it. | Lay up · carbon fibre | 1 | 35 |
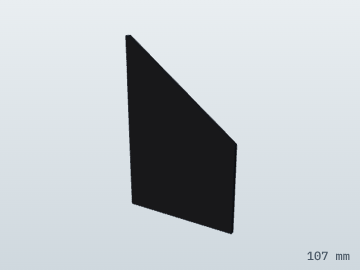
[picture p99: docs/img/parts/FIN-01.png]
Fin (x4)
|  | 3 | **Fin (x4)**<br>`FIN-01` | 3/32 in birch ply, through the wall. Keeps the rocket pointed while it coasts up with the motor out. | Cut · birch ply | 4 | 9.3 |
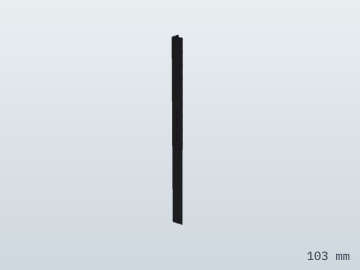
[picture p100: docs/img/parts/FIN-FILLET.png]
Epoxy fillets (x8)
|  | 4 | **Epoxy fillets (x8)**<br>`FIN-FILLET` | 6 mm epoxy fillets on both sides of each fin root; they make the joint strong. | Lay up · epoxy | 8 | 1.1 |
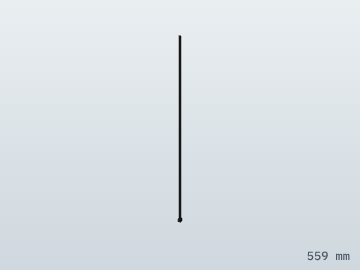
[picture p101: docs/img/parts/HARNESS-AFT.png]
Wiring harness
|  | 5 | **Wiring harness**<br>`HARNESS-AFT` | Servo and pyro wiring from the avionics bay down the tube wall to the motor bay. | Buy · electronics | 1 | 18 |
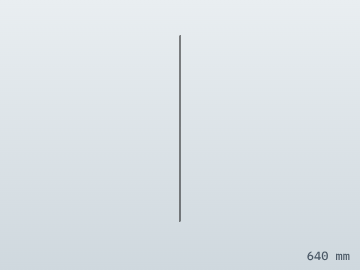
[picture p102: docs/img/parts/CABLE-LIDAR.png]
Lidar cable
|  | 6 | **Lidar cable**<br>`CABLE-LIDAR` | Runs from the avionics bay to the lidar along the 315° leg line. | Buy · electronics | 1 | 5.0 |

## 14.6 Landing legs

Four carbon legs fold flat along the body for flight. At 12 m a servo pulls one pin, the Kevlar loop lets go, and springs swing all four out to 55°, where a stop and a detent lock them.

**10 parts, 37 pieces, 102 g.**

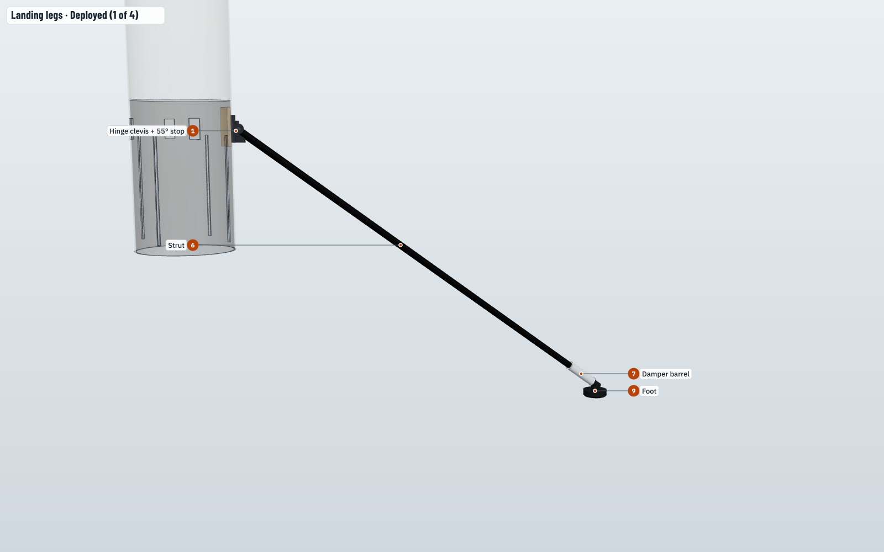
[picture p103: docs/img/sections/legs-1.png]
Landing legs: Deployed (1 of 4)


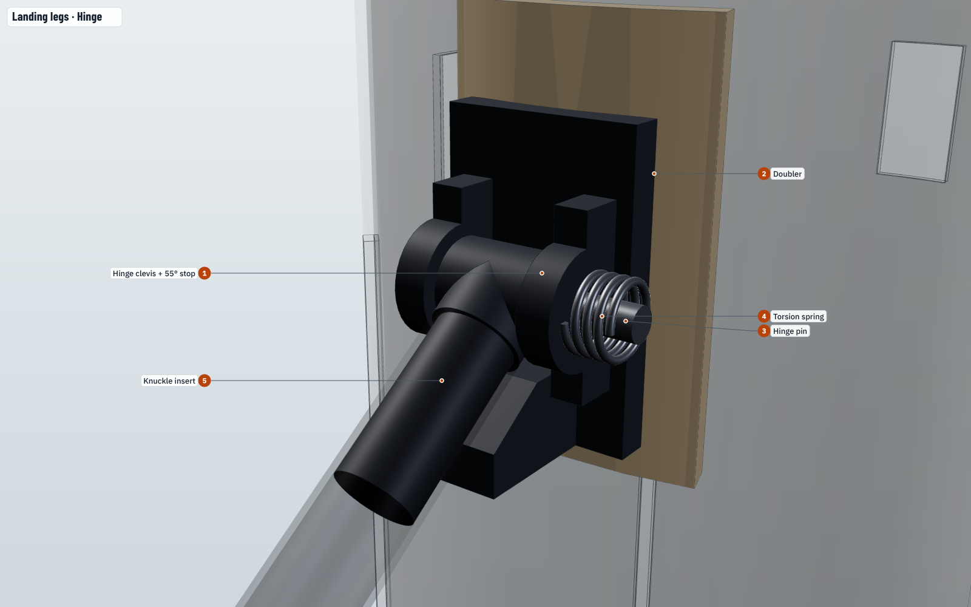
[picture p104: docs/img/sections/legs-2.png]
Landing legs: Hinge


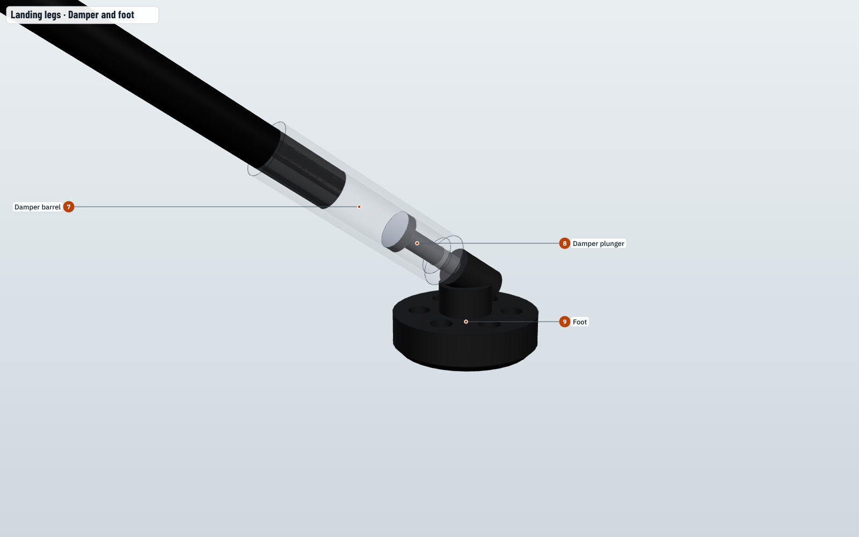
[picture p105: docs/img/sections/legs-3.png]
Landing legs: Damper and foot


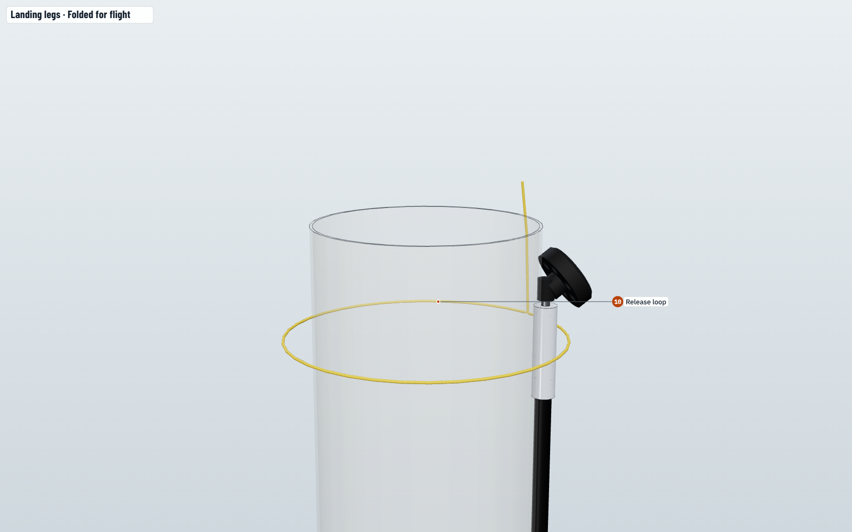
[picture p106: docs/img/sections/legs-4.png]
Landing legs: Folded for flight


| | # | Part | What it does | Made from | Qty | Mass (g) |
|---|---:|---|---|---|---:|---:|
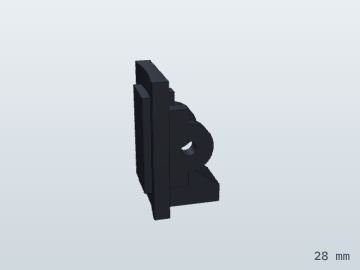
[picture p107: docs/img/parts/LEG-CLEVIS.png]
Hinge clevis + 55° stop
|  | 1 | **Hinge clevis + 55° stop**<br>`LEG-CLEVIS` | Printed CF-nylon bracket bonded through a slot in the tube. Its cheeks hold the hinge pin, and its stop block catches the leg at 55°. | Print · CF-nylon | 4 | 3.5 |
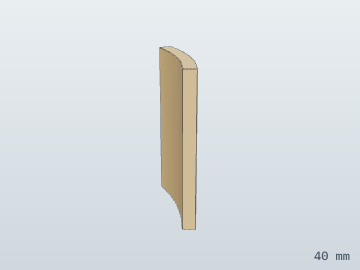
[picture p108: docs/img/parts/LEG-DOUBLER.png]
Doubler
|  | 2 | **Doubler**<br>`LEG-DOUBLER` | 1/8 in ply pad inside the tube that the clevis tongue bonds to, spreading the landing load. | Cut · birch ply | 4 | 2.2 |
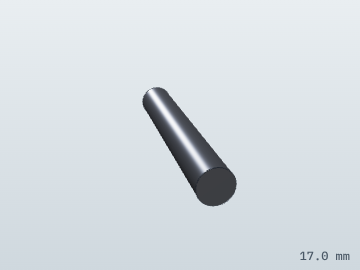
[picture p109: docs/img/parts/LEG-PIN.png]
|  | 3 | **Hinge pin**<br>`LEG-PIN` | 3 mm steel pin the leg pivots on. | Buy · steel | 4 | 1.2 |
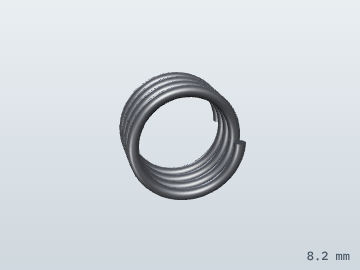
[picture p110: docs/img/parts/LEG-SPRING.png]
Torsion spring
|  | 4 | **Torsion spring**<br>`LEG-SPRING` | About 0.15 N·m that swings the leg out in under 0.3 s once released. | Buy · steel | 4 | 0.5 |
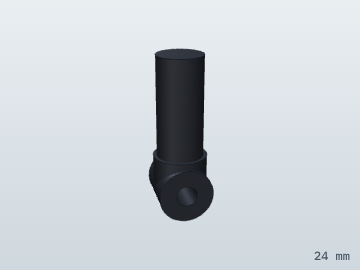
[picture p111: docs/img/parts/LEG-INSERT.png]
Knuckle insert
|  | 5 | **Knuckle insert**<br>`LEG-INSERT` | Printed knuckle around the pin, with a plug bonded into the strut. | Print · CF-nylon | 4 | 1.2 |
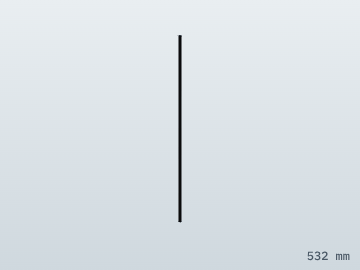
[picture p112: docs/img/parts/LEG-STRUT.png]
Strut
|  | 6 | **Strut**<br>`LEG-STRUT` | 532 mm of 8 x 7 mm pultruded carbon tube. | Cut · carbon fibre | 4 | 9.7 |
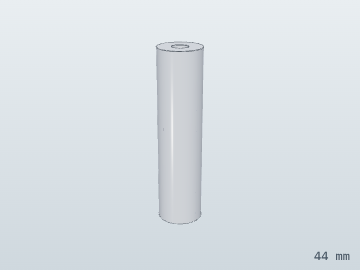
[picture p113: docs/img/parts/LEG-DAMPER.png]
Damper barrel
|  | 7 | **Damper barrel**<br>`LEG-DAMPER` | Syringe-style air damper bonded to the strut tip. It soaks up the touchdown so the rocket doesn't bounce. | Buy · polycarbonate | 4 | 2.5 |
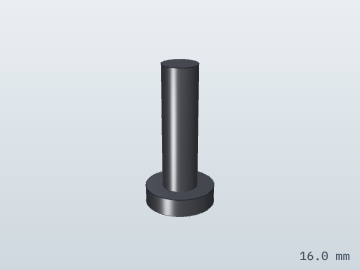
[picture p114: docs/img/parts/LEG-PLUNGER.png]
Damper plunger
|  | 8 | **Damper plunger**<br>`LEG-PLUNGER` | Piston and rod that slide in the damper and carry the foot. | Buy · steel | 4 | 1.2 |
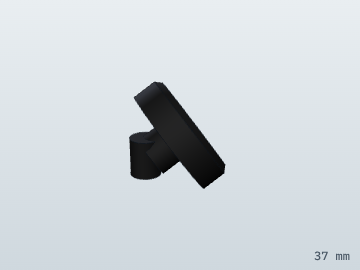
[picture p115: docs/img/parts/LEG-FOOT.png]
Foot
|  | 9 | **Foot**<br>`LEG-FOOT` | 30 mm TPU lattice pad, angled to sit flat at 55°; it also crushes to absorb energy. | Print · TPU-95A | 4 | 3.4 |
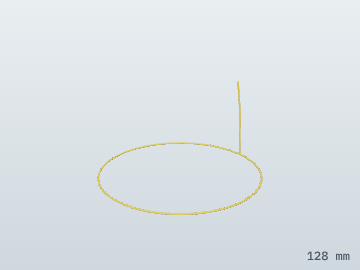
[picture p116: docs/img/parts/LEG-LOOP.png]
Release loop
|  | 10 | **Release loop**<br>`LEG-LOOP` | Kevlar loop around all four folded legs, hooked over the release pin. Pulling the pin lets all four legs swing out together. | Buy · Kevlar | 1 | 0.8 |

## 14.7 Motor bay and TVC gimbal

Both motors sit side by side in one 2-axis gimbal centred on its pivot. Two servos tilt it up to 7° each way to steer the thrust. All thrust flows from the sleeve caps through the rings and pins into the thrust plate.

**27 parts, 31 pieces, 297 g.**

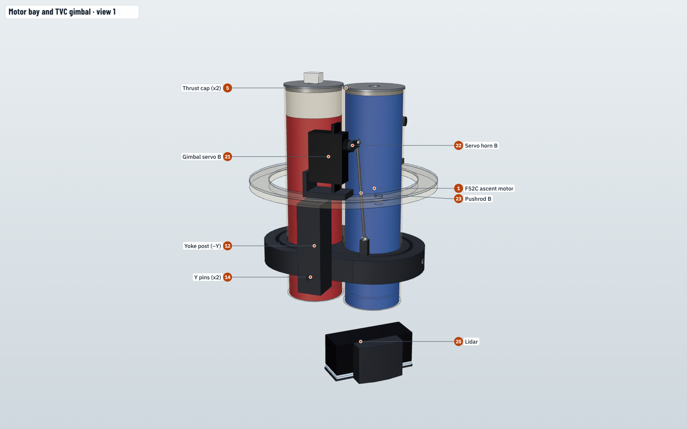
[picture p117: docs/img/sections/motorbay-1.png]
Motor bay and TVC gimbal: view 1


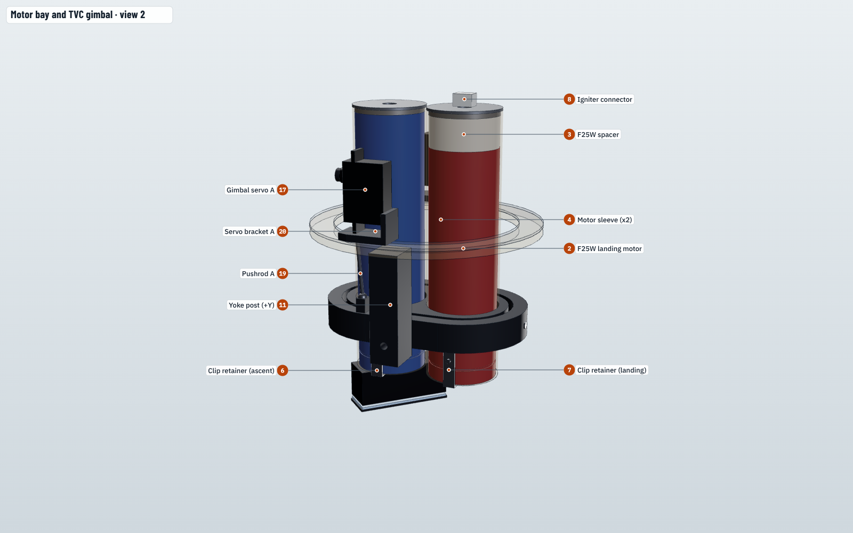
[picture p118: docs/img/sections/motorbay-2.png]
Motor bay and TVC gimbal: view 2


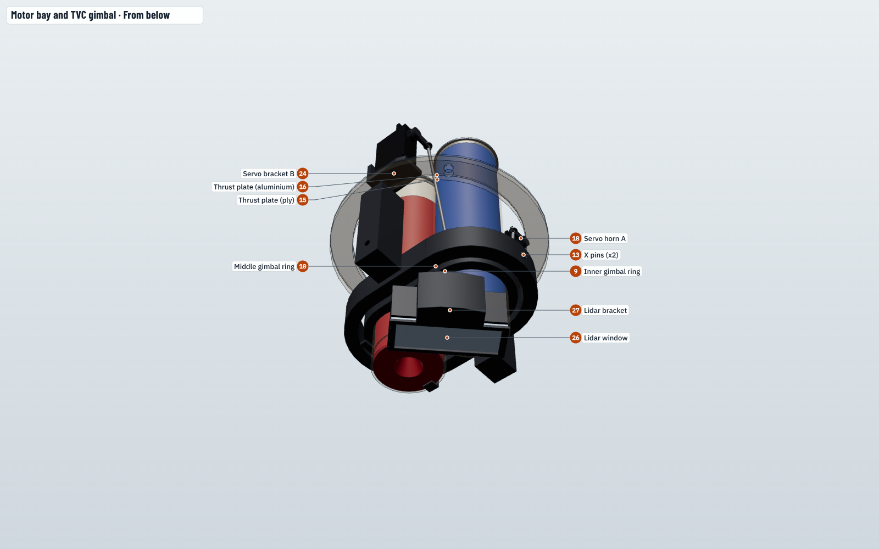
[picture p119: docs/img/sections/motorbay-3.png]
Motor bay and TVC gimbal: From below


| | # | Part | What it does | Made from | Qty | Mass (g) |
|---|---:|---|---|---|---:|---:|
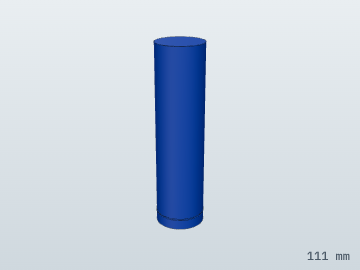
[picture p120: docs/img/parts/MOTOR-F52C.png]
F52C ascent motor
|  | 1 | **F52C ascent motor**<br>`MOTOR-F52C` | AeroTech F52C, 66 N·s. Lit by the launch controller; flies the rocket to ~226 ft. | Buy · AeroTech motor | 1 | 81 |
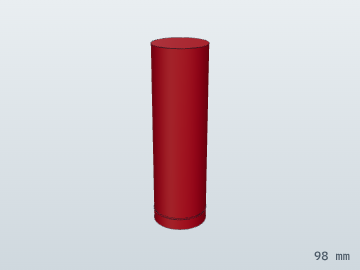
[picture p121: docs/img/parts/MOTOR-F25W.png]
F25W landing motor
|  | 2 | **F25W landing motor**<br>`MOTOR-F25W` | AeroTech F25W, 71 N·s. Lit by the flight computer at ~15 m on the way down; its thrust fades naturally ('strong, then simmer'). | Buy · AeroTech motor | 1 | 97 |
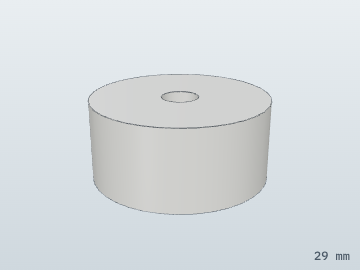
[picture p122: docs/img/parts/F25W-SPACER.png]
F25W spacer
|  | 3 | **F25W spacer**<br>`F25W-SPACER` | 13 mm printed spacer so both nozzles end at the same height (the F25W is shorter). | Print · PETG | 1 | 4.1 |
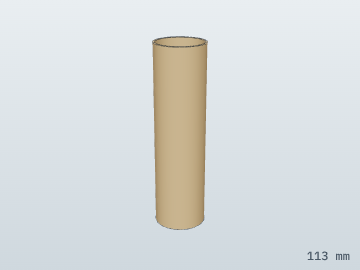
[picture p123: docs/img/parts/SLEEVE-29.png]
Motor sleeve (x2)
|  | 4 | **Motor sleeve (x2)**<br>`SLEEVE-29` | 113 mm kraft motor tube bonded into the inner gimbal ring; the motors slide in from the bottom. | Cut from tube · kraft coupler tube | 2 | 8.1 |
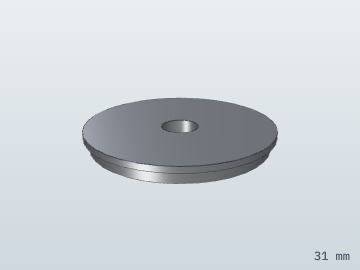
[picture p124: docs/img/parts/SLEEVE-CAP.png]
Thrust cap (x2)
|  | 5 | **Thrust cap (x2)**<br>`SLEEVE-CAP` | Aluminium cap on the top of each sleeve. The motor pushes on it, and the igniter leads pass through its hole. | Machine · aluminium | 2 | 5.4 |
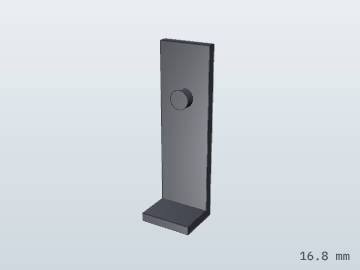
[picture p125: docs/img/parts/CLIP-RET.png]
Clip retainer (ascent)
|  | 6 | **Clip retainer (ascent)**<br>`CLIP-RET` | Spring-steel clip that hooks under the motor's aft end so it can't slide out. | Bend · steel | 1 | 1.5 |
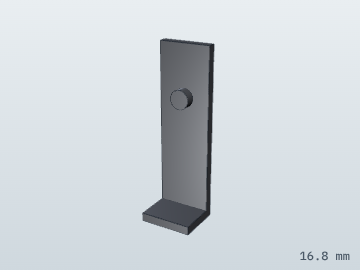
[picture p126: docs/img/parts/CLIP-RET-L.png]
Clip retainer (landing)
|  | 7 | **Clip retainer (landing)**<br>`CLIP-RET-L` | Same clip on the landing-motor sleeve. | Bend · steel | 1 | 1.5 |
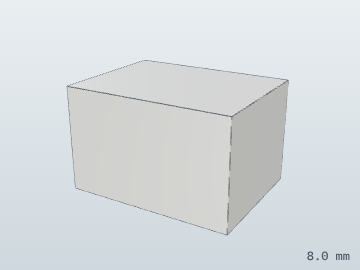
[picture p127: docs/img/parts/IGN-CONN.png]
Igniter connector
|  | 8 | **Igniter connector**<br>`IGN-CONN` | Locking 2-pin connector for the landing igniters; it stays unplugged until the pad. | Buy · electronics | 1 | 0.5 |
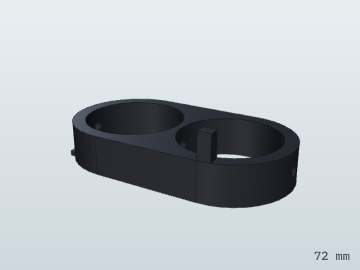
[picture p128: docs/img/parts/GIMBAL-INNER.png]
Inner gimbal ring
|  | 9 | **Inner gimbal ring**<br>`GIMBAL-INNER` | Holds both sleeves. Tilts about the X axis on the X pins; servo B drives it. | Print · CF-nylon | 1 | 9.7 |
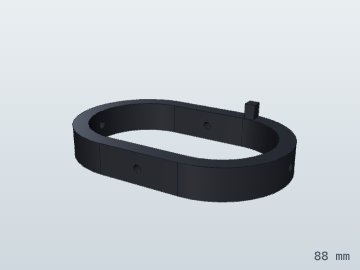
[picture p129: docs/img/parts/GIMBAL-MIDDLE.png]
Middle gimbal ring
|  | 10 | **Middle gimbal ring**<br>`GIMBAL-MIDDLE` | Carries the inner ring. Tilts about the Y axis on the Y pins; servo A drives it. | Print · CF-nylon | 1 | 13 |
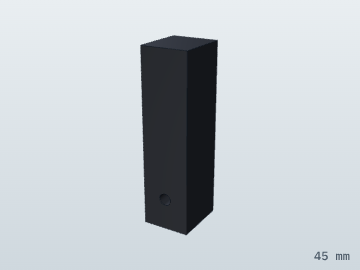
[picture p130: docs/img/parts/GIMBAL-POST.png]
Yoke post (+Y)
|  | 11 | **Yoke post (+Y)**<br>`GIMBAL-POST` | Fixed post from the thrust plate that holds one Y pin. | Print · CF-nylon | 1 | 6.1 |
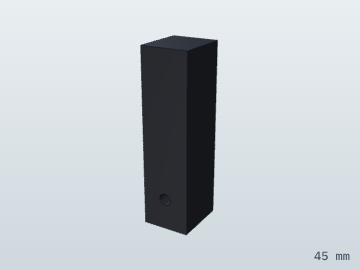
[picture p131: docs/img/parts/GIMBAL-POST-B.png]
Yoke post (−Y)
|  | 12 | **Yoke post (−Y)**<br>`GIMBAL-POST-B` | The matching post on the other side. | Print · CF-nylon | 1 | 6.1 |
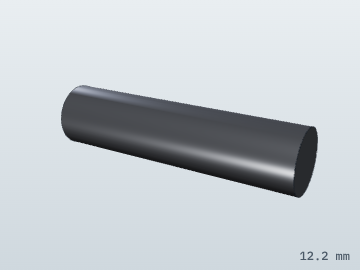
[picture p132: docs/img/parts/PIN-X.png]
X pins (x2)
|  | 13 | **X pins (x2)**<br>`PIN-X` | 3 mm steel pivots between the inner and middle rings. | Buy · steel | 2 | 0.7 |
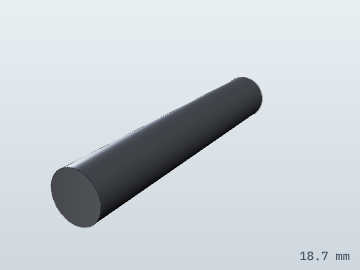
[picture p133: docs/img/parts/PIN-Y.png]
Y pins (x2)
|  | 14 | **Y pins (x2)**<br>`PIN-Y` | 3 mm steel pivots between the middle ring and the yoke posts. | Buy · steel | 2 | 1.0 |
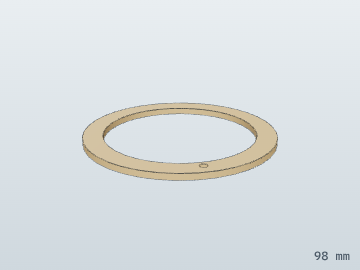
[picture p134: docs/img/parts/THRUST-PLATE.png]
Thrust plate (ply)
|  | 15 | **Thrust plate (ply)**<br>`THRUST-PLATE` | 1/8 in ply ring bonded in the tube. All motor thrust ends up here and goes into the airframe. | Cut · birch ply | 1 | 6.0 |
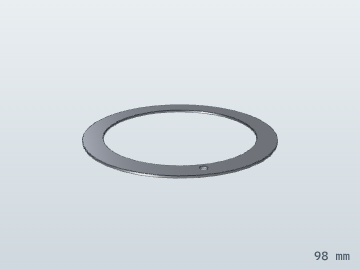
[picture p135: docs/img/parts/THRUST-PLATE-AL.png]
Thrust plate (aluminium)
|  | 16 | **Thrust plate (aluminium)**<br>`THRUST-PLATE-AL` | 1 mm aluminium ring on the ply that spreads the post and servo loads. | Cut · aluminium | 1 | 7.5 |
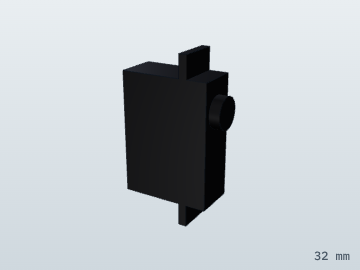
[picture p136: docs/img/parts/SERVO-GIMBAL-A.png]
Gimbal servo A
|  | 17 | **Gimbal servo A**<br>`SERVO-GIMBAL-A` | KST X08H (pin 2) that tilts the middle ring: pitch. | Buy · servo | 1 | 8.0 |
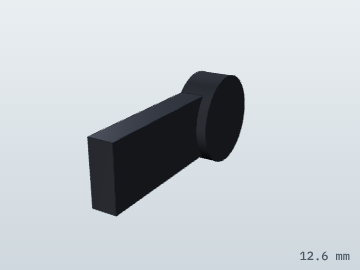
[picture p137: docs/img/parts/HORN-GIMBAL-A.png]
Servo horn A
|  | 18 | **Servo horn A**<br>`HORN-GIMBAL-A` | 10 mm horn, about a 2:1 servo-to-gimbal ratio. | Buy · CF-nylon | 1 | 0.4 |
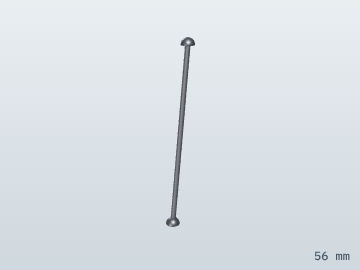
[picture p138: docs/img/parts/PUSHROD-A.png]
Pushrod A
|  | 19 | **Pushrod A**<br>`PUSHROD-A` | 1.5 mm steel rod with ball links from servo A to the middle-ring lug. | Buy · steel | 1 | 1.2 |
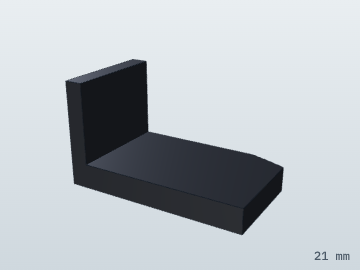
[picture p139: docs/img/parts/SERVO-BRKT-A.png]
Servo bracket A
|  | 20 | **Servo bracket A**<br>`SERVO-BRKT-A` | Printed bracket on the thrust plate. | Print · CF-nylon | 1 | 1.1 |
| Gimbal servo B | 21 | **Gimbal servo B**<br>`SERVO-GIMBAL-B` | KST X08H (pin 3) that tilts the inner ring: yaw. | Buy · servo | 1 | 8.0 |
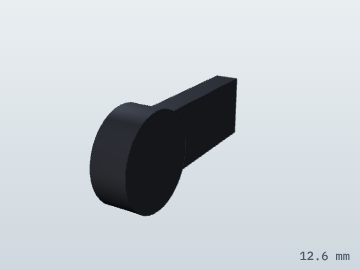
[picture p140: docs/img/parts/HORN-GIMBAL-B.png]
Servo horn B
|  | 22 | **Servo horn B**<br>`HORN-GIMBAL-B` | 10 mm horn. | Buy · CF-nylon | 1 | 0.4 |
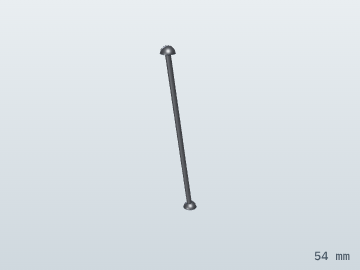
[picture p141: docs/img/parts/PUSHROD-B.png]
Pushrod B
|  | 23 | **Pushrod B**<br>`PUSHROD-B` | Ball-link rod from servo B to the inner-ring lug. | Buy · steel | 1 | 1.2 |
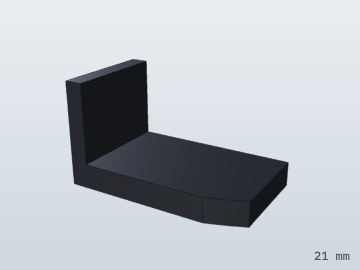
[picture p142: docs/img/parts/SERVO-BRKT-B.png]
Servo bracket B
|  | 24 | **Servo bracket B**<br>`SERVO-BRKT-B` | Printed bracket on the thrust plate. | Print · CF-nylon | 1 | 1.1 |
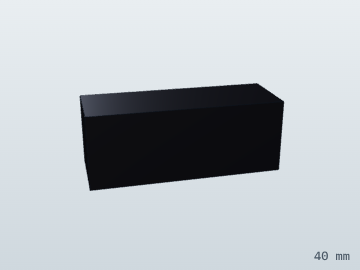
[picture p143: docs/img/parts/LIDAR-TFMINI.png]
Lidar
|  | 25 | **Lidar**<br>`LIDAR-TFMINI` | Benewake TFmini-S looking straight down; measures the last ~7 m to the ground and detects touchdown. | Buy · electronics | 1 | 5.0 |
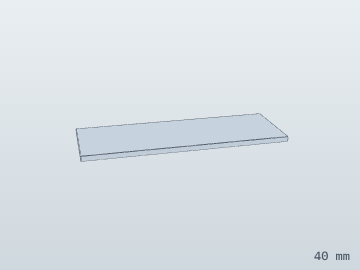
[picture p144: docs/img/parts/LIDAR-WINDOW.png]
Lidar window
|  | 26 | **Lidar window**<br>`LIDAR-WINDOW` | Replaceable 1 mm polycarbonate shield that keeps exhaust soot off the lidar's lenses. Wipe it after every flight. | Cut · polycarbonate | 1 | 0.8 |
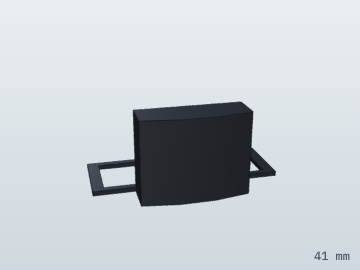
[picture p145: docs/img/parts/LIDAR-BRKT.png]
Lidar bracket
|  | 27 | **Lidar bracket**<br>`LIDAR-BRKT` | Printed bracket on the liner at 315°, clear of both plumes and the paddles; its lip holds the window. | Print · CF-nylon | 1 | 4.5 |

## 14.8 Exhaust-paddle throttle

A solid motor can't be throttled, so two ceramic paddles under the landing motor swing into its exhaust and deflect part of the thrust sideways. One servo drives both through a scissor linkage, so the side forces cancel.

**16 parts, 16 pieces, 33 g.**

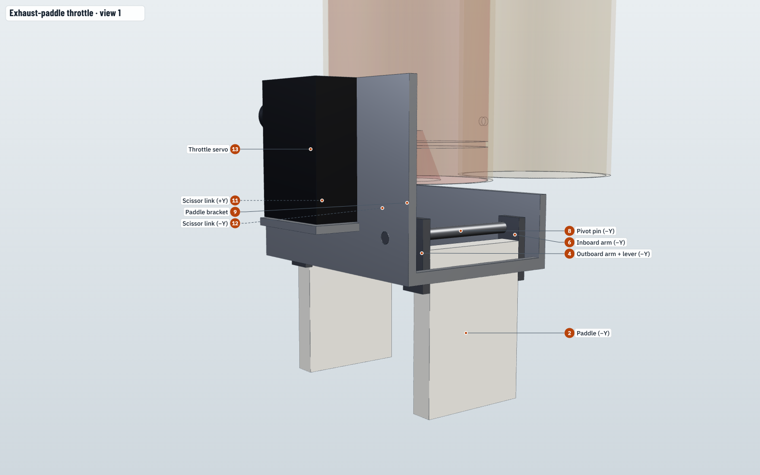
[picture p146: docs/img/sections/throttle-1.png]
Exhaust-paddle throttle: view 1


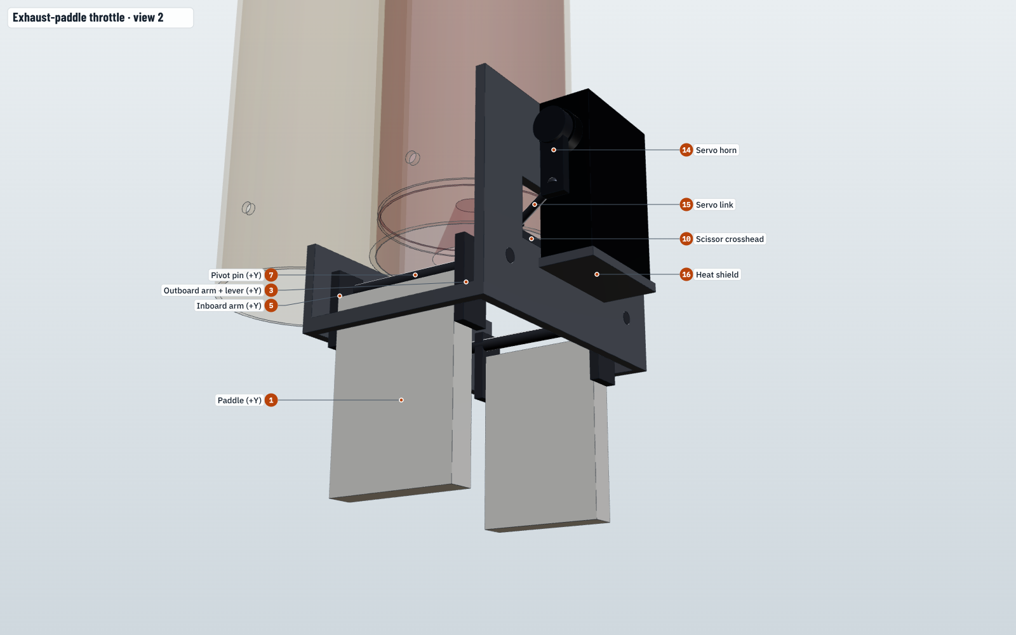
[picture p147: docs/img/sections/throttle-2.png]
Exhaust-paddle throttle: view 2


| | # | Part | What it does | Made from | Qty | Mass (g) |
|---|---:|---|---|---|---:|---:|
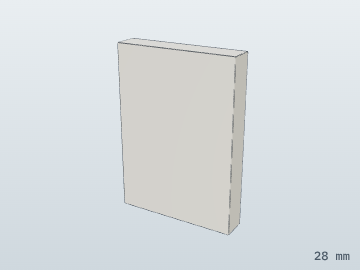
[picture p148: docs/img/parts/PADDLE-R.png]
Paddle (+Y)
|  | 1 | **Paddle (+Y)**<br>`PADDLE-R` | Machinable ceramic, 20 x 28 x 4 mm. Swings into the landing motor's exhaust to deflect up to 75 % of its thrust sideways: the throttle. | Machine · ceramic | 1 | 5.2 |
| Paddle (−Y) | 2 | **Paddle (−Y)**<br>`PADDLE-L` | Its twin on the other side, so the two side forces cancel. | Machine · ceramic | 1 | 5.2 |
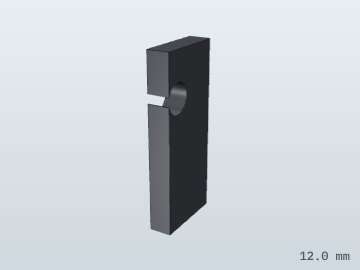
[picture p149: docs/img/parts/PADDLE-ARM-OR.png]
Outboard arm + lever (+Y)
|  | 3 | **Outboard arm + lever (+Y)**<br>`PADDLE-ARM-OR` | 1.5 mm stainless arm that holds the paddle; its lever is what the scissor link pushes. | Machine · steel | 1 | 0.7 |
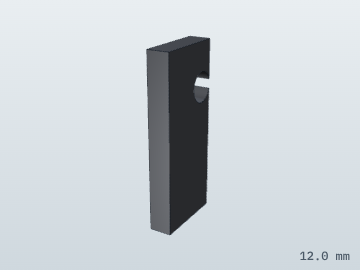
[picture p150: docs/img/parts/PADDLE-ARM-OL.png]
Outboard arm + lever (−Y)
|  | 4 | **Outboard arm + lever (−Y)**<br>`PADDLE-ARM-OL` | Same, other paddle. | Machine · steel | 1 | 0.7 |
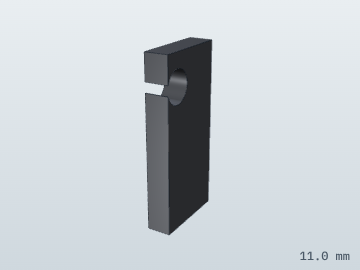
[picture p151: docs/img/parts/PADDLE-ARM-IR.png]
Inboard arm (+Y)
|  | 5 | **Inboard arm (+Y)**<br>`PADDLE-ARM-IR` | Second stainless arm on the paddle's other end. | Machine · steel | 1 | 0.6 |
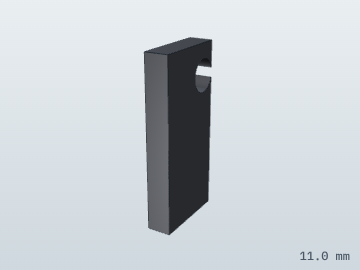
[picture p152: docs/img/parts/PADDLE-ARM-IL.png]
Inboard arm (−Y)
|  | 6 | **Inboard arm (−Y)**<br>`PADDLE-ARM-IL` | Same, other paddle. | Machine · steel | 1 | 0.6 |
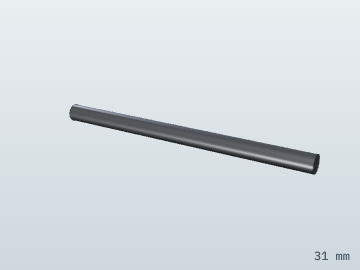
[picture p153: docs/img/parts/PADDLE-PIN-R.png]
Pivot pin (+Y)
|  | 7 | **Pivot pin (+Y)**<br>`PADDLE-PIN-R` | 2 mm steel pin the paddle swings on, 8 mm below the nozzle. | Buy · steel | 1 | 0.8 |
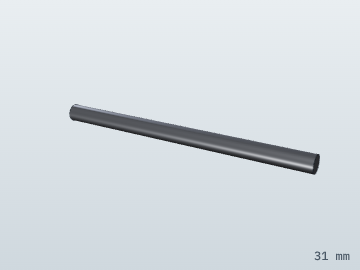
[picture p154: docs/img/parts/PADDLE-PIN-L.png]
Pivot pin (−Y)
|  | 8 | **Pivot pin (−Y)**<br>`PADDLE-PIN-L` | Same, other paddle. | Buy · steel | 1 | 0.8 |
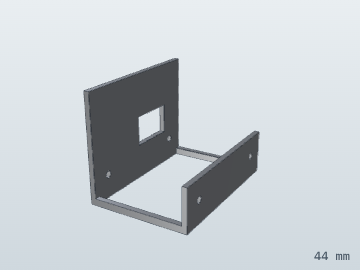
[picture p155: docs/img/parts/PADDLE-BRKT.png]
Paddle bracket
|  | 9 | **Paddle bracket**<br>`PADDLE-BRKT` | 1.5 mm aluminium U-bracket under the inner gimbal ring, so the paddles move with the motor. | Machine · aluminium | 1 | 8.0 |
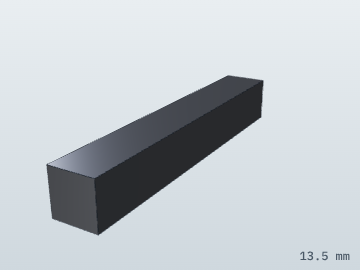
[picture p156: docs/img/parts/PADDLE-XHEAD.png]
Scissor crosshead
|  | 10 | **Scissor crosshead**<br>`PADDLE-XHEAD` | Slides up and down. Through the two links it opens or closes both paddles together. | Machine · steel | 1 | 0.4 |
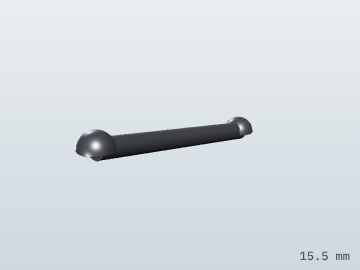
[picture p157: docs/img/parts/PADDLE-LINK-R.png]
Scissor link (+Y)
|  | 11 | **Scissor link (+Y)**<br>`PADDLE-LINK-R` | Link from the crosshead to the +Y paddle lever. | Buy · steel | 1 | 0.3 |
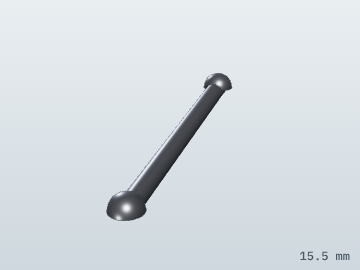
[picture p158: docs/img/parts/PADDLE-LINK-L.png]
Scissor link (−Y)
|  | 12 | **Scissor link (−Y)**<br>`PADDLE-LINK-L` | Link to the −Y paddle lever. | Buy · steel | 1 | 0.3 |
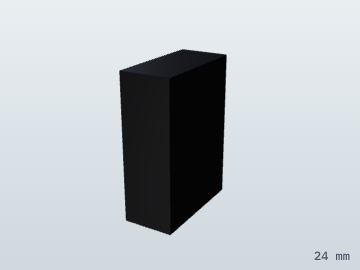
[picture p159: docs/img/parts/SERVO-PADDLE.png]
Throttle servo
|  | 13 | **Throttle servo**<br>`SERVO-PADDLE` | KST X08H (pin 4) strapped to the bracket. It moves the crosshead 50 times a second to follow the burn plan. | Buy · servo | 1 | 8.0 |
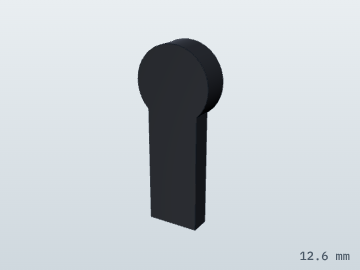
[picture p160: docs/img/parts/HORN-PADDLE.png]
Servo horn
|  | 14 | **Servo horn**<br>`HORN-PADDLE` | 10 mm horn on the throttle servo. | Buy · CF-nylon | 1 | 0.4 |
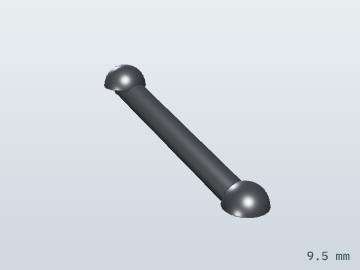
[picture p161: docs/img/parts/PADDLE-SERVO-LINK.png]
Servo link
|  | 15 | **Servo link**<br>`PADDLE-SERVO-LINK` | Link from the horn to the crosshead, through a slot in the bracket. | Buy · steel | 1 | 0.3 |
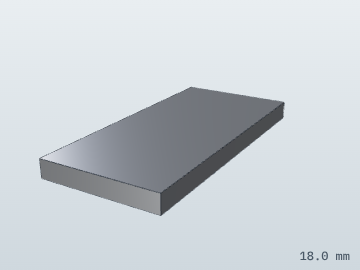
[picture p162: docs/img/parts/HEAT-SHIELD.png]
Heat shield
|  | 16 | **Heat shield**<br>`HEAT-SHIELD` | Aluminium plus ceramic paper under the servo, between it and the plume. | Cut · aluminium | 1 | 0.5 |

---

Generated by `python cad/tools/section_guide.py` from `cad/slr1/sections.py` and the CAD build.
Images: `node cad/tools/render_sections.mjs <three-package-dir> docs/img` ([docs/13](13-cad.md#137-rebuilding-and-changing-the-design)).
