chaseyarnall173/Self-Landing-Rocket/cad/out/interference.md

# Interference check

Every pair of solids whose bounding boxes touch is intersected; overlaps above 0.5 mm^3 are listed.

## flight configuration

802 close pairs checked: **0 clashes**, 15 designed joints (ball links, pushrods and cords drawn seated in the horn, lug or pin they attach to).

### Designed joints

| Overlap (mm^3) | Part A | Part B |
|---:|---|---|
| 10.8 | HORN-GIMBAL-B-1 | PUSHROD-B-1 |
| 10.7 | HORN-GIMBAL-A-1 | PUSHROD-A-1 |
| 6.8 | PADDLE-LINK-R-1 | PADDLE-XHEAD-1 |
| 5.1 | LATCH-RING-1 | LATCH-LINK-1 |
| 4.1 | HORN-LATCH-1 | LATCH-LINK-1 |
| 3.6 | HORN-PADDLE-1 | PADDLE-SERVO-LINK-1 |
| 3.6 | HORN-CHUTE-1 | CHUTE-LINK-1 |
| 3.1 | HORN-LEGPIN-1 | LEGPIN-LINK-1 |
| 3.1 | SERVO-LATCH-1 | LATCH-LINK-1 |
| 2.7 | CHUTE-PIN-1 | CHUTE-LINK-1 |
| 2.1 | PADDLE-LINK-L-1 | PADDLE-XHEAD-1 |
| 1.8 | PADDLE-ARM-OL-1 | PADDLE-LINK-L-1 |
| 1.8 | PADDLE-ARM-OR-1 | PADDLE-LINK-R-1 |
| 1.2 | LEG-RELEASE-PIN-1 | LEG-LOOP-1 |
| 1.2 | LEG-RELEASE-PIN-1 | LEGPIN-LINK-1 |

## landing configuration

690 close pairs checked: **0 clashes**, 14 designed joints (ball links, pushrods and cords drawn seated in the horn, lug or pin they attach to).

### Designed joints

| Overlap (mm^3) | Part A | Part B |
|---:|---|---|
| 10.8 | HORN-GIMBAL-B-1 | PUSHROD-B-1 |
| 10.7 | HORN-GIMBAL-A-1 | PUSHROD-A-1 |
| 6.8 | PADDLE-LINK-R-1 | PADDLE-XHEAD-1 |
| 5.1 | LATCH-RING-1 | LATCH-LINK-1 |
| 4.1 | HORN-LATCH-1 | LATCH-LINK-1 |
| 3.6 | HORN-PADDLE-1 | PADDLE-SERVO-LINK-1 |
| 3.6 | HORN-CHUTE-1 | CHUTE-LINK-1 |
| 3.1 | HORN-LEGPIN-1 | LEGPIN-LINK-1 |
| 3.1 | SERVO-LATCH-1 | LATCH-LINK-1 |
| 2.7 | CHUTE-PIN-1 | CHUTE-LINK-1 |
| 2.1 | PADDLE-LINK-L-1 | PADDLE-XHEAD-1 |
| 1.8 | PADDLE-ARM-OL-1 | PADDLE-LINK-L-1 |
| 1.8 | PADDLE-ARM-OR-1 | PADDLE-LINK-R-1 |
| 1.2 | LEG-RELEASE-PIN-1 | LEGPIN-LINK-1 |

## Gimbal sweep (+-7 deg on each axis and both together)

**0 clashes** between the parts the gimbal carries and the fixed structure.
