chaseyarnall173/Self-Landing-Rocket/docs/img/cad_flight.png

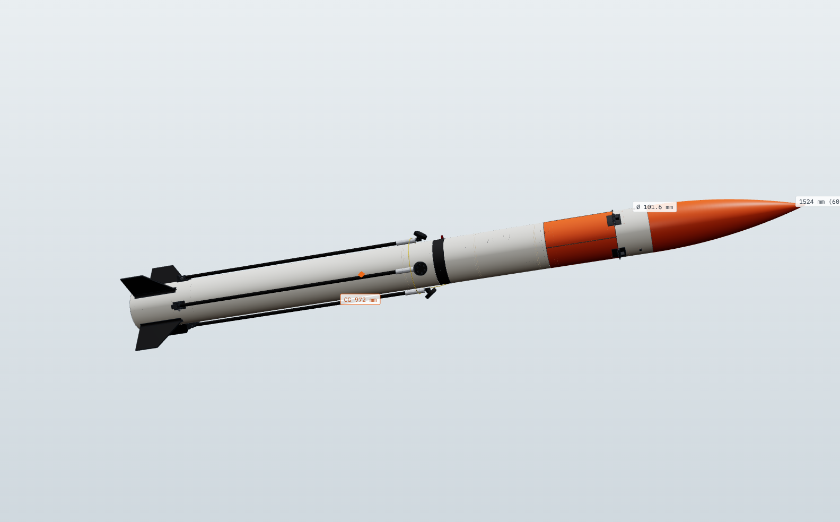
docs/img/cad_flight.png
