chaseyarnall173/Self-Landing-Rocket/cad/out/bom.csv

part | description | subassembly | qty | material | make | mass_each_g | mass_total_g | stl | dxf | note
NOSE-01 | Nose cone, PETG tangent ogive 12.75 in + 2 in shoulder | Nose | 1 | petg | 3D print | 99.08 | 99.1 | stl/NOSE-01.stl |  | 0.8 mm walls; shoulder 1.6 mm. Held by 3 x M3 so the airbrake latch stays reachable.
NOSE-SCREW | M3 x 8 button-head screw (nose retention) | Nose | 3 | steel | buy | 0.5 | 1.5
TUBE-01 | Nose ring, LOC 3.9 in kraft tube (71 mm) | Forward airframe | 1 | kraft | cut from tube stock | 24.01 | 24.0
TUBE-02 | Recovery section, kraft tube (223 mm) with door cut-out | Forward airframe | 1 | kraft | cut from tube stock | 67.56 | 67.6
CPL-01 | Airbrake sleeve, LOC 3.9 in coupler (189 mm), latch slots + 4 lightening windows | Top airbrakes | 1 | kraft_cpl | cut from tube stock | 43.43 | 43.4
HORN-LATCH | Servo horn | Top airbrakes | 1 | cf_nylon | buy | 0.3 | 0.3
LATCH-LINK | Servo-to-latch-ring link | Top airbrakes | 1 | steel | buy | 0.3 | 0.3
LATCH-RING | Airbrake latch ring with 4 fingers | Top airbrakes | 1 | cf_nylon | 3D print | 5.17 | 5.2 | stl/LATCH-RING.stl
LATCH-SERVO-BRKT | Latch servo mount, bonded to the sleeve | Top airbrakes | 1 | cf_nylon | 3D print | 0.74 | 0.7 | stl/LATCH-SERVO-BRKT.stl
PETAL-01 | Airbrake petal, 90 deg quadrant cut from the tube (149 mm) | Top airbrakes | 4 | kraft | cut from tube stock | 12.43 | 49.7 |  |  | Seal edges with thin CA; 2 oz fibreglass inside.
PETAL-HINGE-F | Petal hinge, fixed half with 90 deg stop | Top airbrakes | 4 | cf_nylon | 3D print | 1.14 | 4.5 | stl/PETAL-HINGE-F.stl
PETAL-HINGE-M | Petal hinge, moving half | Top airbrakes | 4 | cf_nylon | 3D print | 0.63 | 2.5 | stl/PETAL-HINGE-M.stl
PETAL-PIN | Petal hinge pin, 1.6 mm stainless, 34 mm | Top airbrakes | 4 | steel | buy | 0.54 | 2.2
PETAL-SPRING | Petal torsion spring, ~0.1 N m | Top airbrakes | 4 | steel | buy | 0.08 | 0.3
PETAL-TAB | Petal latch tab | Top airbrakes | 4 | cf_nylon | 3D print | 0.23 | 0.9 | stl/PETAL-TAB.stl
SERVO-LATCH | Airbrake-latch micro servo (4.3 g) | Top airbrakes | 1 | servo | buy | 4.3 | 4.3
CABLE-FWD | Airbrake / chute servo cable | Backup chute bay | 1 | electronics | buy | 4.0 | 4.0
CHUTE-30 | Backup main parachute, 30 in nylon, Z-folded | Backup chute bay | 1 | nylon_chute | buy | 42.0 | 42.0 |  |  | Packed size about 54 x 74 mm.
CHUTE-LINK | Servo-to-pin link | Backup chute bay | 1 | steel | buy | 0.4 | 0.4
CHUTE-NOMEX | Nomex chute protector (9 in), wrapped | Backup chute bay | 1 | nomex | buy | 14.0 | 14.0
CHUTE-PIN | Chute-latch pin, 1.8 mm steel | Backup chute bay | 1 | steel | buy | 0.39 | 0.4
CHUTE-SERVO-BRKT | Chute servo mount | Backup chute bay | 1 | cf_nylon | 3D print | 0.4 | 0.4 | stl/CHUTE-SERVO-BRKT.stl
DOOR-01 | Chute door, cut from the tube | Backup chute bay | 1 | kraft | cut from tube stock | 7.6 | 7.6
DOOR-HINGE-F | Door hinge, fixed half | Backup chute bay | 1 | cf_nylon | 3D print | 0.6 | 0.6 | stl/DOOR-HINGE-F.stl
DOOR-HINGE-M | Door hinge, moving half | Backup chute bay | 1 | cf_nylon | 3D print | 0.48 | 0.5 | stl/DOOR-HINGE-M.stl
DOOR-LUG | Door latch lug | Backup chute bay | 1 | cf_nylon | 3D print | 0.27 | 0.3 | stl/DOOR-LUG.stl
DOOR-PIN | Door hinge pin, 1.6 mm stainless | Backup chute bay | 1 | steel | buy | 0.4 | 0.4
EJECT-CUP | Ejector spring seat | Backup chute bay | 2 | cf_nylon | 3D print | 0.21 | 0.4 | stl/EJECT-CUP.stl
EJECT-PLATE | Ejector plate, 2 mm ply | Backup chute bay | 1 | ply | cut / laser-cut | 3.48 | 3.5
EJECT-SPRING | Ejector compression spring, ~20 N each | Backup chute bay | 2 | steel | buy | 1.5 | 3.0
HORN-CHUTE | Servo horn | Backup chute bay | 1 | cf_nylon | buy | 0.3 | 0.3
NUT-M4 | M4 nut | Backup chute bay | 2 | steel | buy | 1.2 | 2.4
RECOV-BH | Recovery bulkhead, 1/8 in ply, U-bolt + cable holes | Backup chute bay | 1 | ply | cut / laser-cut | 16.53 | 16.5 |  | dxf/RECOV-BH.dxf
SERVO-CHUTE | Chute-latch micro servo (4.3 g) | Backup chute bay | 1 | servo | buy | 4.3 | 4.3
SHOCK-CORD | Kevlar shock cord, 4.5 m, flaked and bundled | Backup chute bay | 1 | kevlar | buy | 14.0 | 14.0
SHOCK-CORD-RUN | Shock cord to U-bolt and riser | Backup chute bay | 1 | kevlar | buy | 2.0 | 2.0
UBOLT | M4 U-bolt, shock-cord anchor | Backup chute bay | 1 | steel | buy | 8.0 | 8.0
ARM-KEY | Arm key (remove before flight on the bench) | Avionics bay | 1 | steel | buy | 4.0 | 4.0
ARM-KEY-SW | Arm key switch (pyro rail), panel-mount through the band | Avionics bay | 1 | electronics | buy | 12.0 | 12.0
AV-LID-A | Avionics bay aft lid, 1/8 in ply, grommet + cable holes | Avionics bay | 1 | ply | cut / laser-cut | 16.43 | 16.4 |  | dxf/AV-LID-A.dxf
AV-LID-F | Avionics bay forward lid, 1/8 in ply | Avionics bay | 1 | ply | cut / laser-cut | 16.55 | 16.6 |  | dxf/AV-LID-F.dxf
AV-LID-RING-A | Lid locating ring, PETG | Avionics bay | 1 | petg | 3D print | 3.21 | 3.2 | stl/AV-LID-RING-A.stl
AV-LID-RING-F | Lid locating ring, PETG | Avionics bay | 1 | petg | 3D print | 3.21 | 3.2 | stl/AV-LID-RING-F.stl
AV-ROD | M3 nylon threaded rod, 175 mm | Avionics bay | 2 | cf_nylon | buy | 1.43 | 2.9
AV-SLED | Avionics sled, 1/8 in lite ply | Avionics bay | 1 | liteply | cut / laser-cut | 14.77 | 14.8 |  | dxf/AV-SLED.dxf
AV-SLED-TUBE | Sled rod guide, printed | Avionics bay | 2 | cf_nylon | 3D print | 0.72 | 1.4 | stl/AV-SLED-TUBE.stl
BARO-BMP390 | Bosch BMP390 barometer breakout (Adafruit) | Avionics bay | 1 | pcb | buy | 1.5 | 1.5
BARO-FOAM | Open-cell foam over the barometer | Avionics bay | 1 | foam | buy | 0.1 | 0.1
BUCK-5V | Pololu D24V30F5 5 V 3 A buck | Avionics bay | 1 | pcb | buy | 3.0 | 3.0
BUZZER | 11 mm piezo buzzer | Avionics bay | 1 | electronics | buy | 2.0 | 2.0
CAP-1000U | 1000 uF servo-rail capacitor | Avionics bay | 1 | electronics | buy | 3.0 | 3.0
CPL-02 | Avionics-bay coupler, LOC 3.9 in (160 mm) | Avionics bay | 1 | kraft_cpl | cut from tube stock | 74.03 | 74.0
FET-AO3400 | AO3400A pyro MOSFET (SOT-23) | Avionics bay | 2 | electronics | buy | 0.05 | 0.1
GPS-M9N | u-blox NEO-M9N GPS breakout (SparkFun) | Avionics bay | 1 | pcb | buy | 6.0 | 6.0
GPS-PATCH | 25 mm ceramic GPS patch antenna, under the forward lid | Avionics bay | 1 | ceramic | buy | 9.0 | 9.0
GROMMET | Harness grommet, aft lid | Avionics bay | 1 | tpu | 3D print | 0.31 | 0.3 | stl/GROMMET.stl
HEADERS | Female header strips 2 x 24 | Avionics bay | 1 | electronics | buy | 2.0 | 2.0
HORN-LEGPIN | Servo horn | Avionics bay | 1 | cf_nylon | buy | 0.3 | 0.3
IMU-BMI088 | Bosch BMI088 IMU breakout (Seeed Grove), on the axis | Avionics bay | 1 | pcb | buy | 3.0 | 3.0
JST-GH | JST-GH locking header | Avionics bay | 6 | electronics | buy | 0.3 | 1.8
LEG-RELEASE-PIN | Leg-release pin, 1.5 mm steel | Avionics bay | 1 | steel | buy | 0.2 | 0.2
LEGPIN-BRKT | Leg-release servo mount | Avionics bay | 1 | cf_nylon | 3D print | 1.87 | 1.9 | stl/LEGPIN-BRKT.stl
LEGPIN-LINK | Servo-to-pin link | Avionics bay | 1 | steel | buy | 0.3 | 0.3
LIPO-2S | 2S 450 mAh LiPo | Avionics bay | 1 | lipo | buy | 30.0 | 30.0
LORA-ANT | 915 MHz quarter-wave wire antenna (82 mm) | Avionics bay | 1 | brass | buy | 0.5 | 0.5
LORA-RFM95W | HopeRF RFM95W 915 MHz LoRa breakout | Avionics bay | 1 | pcb | buy | 3.0 | 3.0
MAIN-SW | Main power toggle switch | Avionics bay | 1 | electronics | buy | 4.0 | 4.0
NUT-M3 | M3 nylon wing nut | Avionics bay | 4 | cf_nylon | buy | 0.2 | 0.8
PERFBOARD | Perfboard 54 x 120 mm (flight computer carrier) | Avionics bay | 1 | perfboard | buy | 19.18 | 19.2
SERVO-LEGPIN | Leg-release micro servo (4.3 g) | Avionics bay | 1 | servo | buy | 4.3 | 4.3
STANDOFF-3 | Nylon standoff 3 mm | Avionics bay | 12 | cf_nylon | buy | 0.1 | 1.2
STANDOFF-5 | IMU standoffs (4) | Avionics bay | 1 | cf_nylon | buy | 0.3 | 0.3
TEENSY-41 | PJRC Teensy 4.1 (600 MHz, microSD log) | Avionics bay | 1 | pcb | buy | 6.0 | 6.0
TUBE-03 | Switch band, kraft tube (25 mm): key, switch, static ports, leg pin | Avionics bay | 1 | kraft | cut from tube stock | 8.27 | 8.3
CABLE-LIDAR | Lidar cable, along the 315 deg leg line | Aft airframe | 1 | electronics | buy | 5.0 | 5.0
FIN-01 | Fin, 3/32 in aircraft birch ply, through-the-wall | Aft airframe | 4 | ply | cut / laser-cut | 9.32 | 37.3 |  | dxf/FIN-01.dxf | Round the leading edge; 6 mm epoxy fillets.
FIN-FILLET | Epoxy root fillet, 6 mm | Aft airframe | 8 | epoxy | hand lay-up / pack | 1.06 | 8.5
HARNESS-AFT | Servo / pyro harness to the motor bay (bundle) | Aft airframe | 1 | electronics | buy | 18.0 | 18.0
LINER-AFT | Aft carbon liner, 2 wraps 200 gsm + epoxy (6 in), slotted | Aft airframe | 1 | carbon | hand lay-up / pack | 35.02 | 35.0
TUBE-04 | Aft airframe, kraft tube (731 mm), fin and leg slots | Aft airframe | 1 | kraft | cut from tube stock | 244.82 | 244.8
LEG-CLEVIS | Leg hinge clevis with 55 deg stop, CF-nylon | Landing legs | 4 | cf_nylon | 3D print | 3.54 | 14.2 | stl/LEG-CLEVIS.stl
LEG-DAMPER | Syringe air damper barrel | Landing legs | 4 | polycarb | buy | 2.45 | 9.8
LEG-DOUBLER | Leg hinge doubler, 1/8 in ply (on the aft liner) | Landing legs | 4 | ply | cut / laser-cut | 2.17 | 8.7
LEG-FOOT | Foot, TPU-95A lattice crush pad (30 mm) | Landing legs | 4 | tpu | 3D print | 3.43 | 13.7 | stl/LEG-FOOT.stl
LEG-INSERT | Leg hinge knuckle / strut plug, CF-nylon | Landing legs | 4 | cf_nylon | 3D print | 1.17 | 4.7 | stl/LEG-INSERT.stl
LEG-LOOP | Kevlar release loop around the 4 legs, to the release pin | Landing legs | 1 | kevlar | buy | 0.8 | 0.8
LEG-PIN | Leg hinge pin, 3 mm steel | Landing legs | 4 | steel | buy | 1.17 | 4.7
LEG-PLUNGER | Damper plunger | Landing legs | 4 | steel | buy | 1.2 | 4.8
LEG-SPRING | Leg torsion spring, ~0.15 N m | Landing legs | 4 | steel | buy | 0.5 | 2.0
LEG-STRUT | Leg strut, 8 x 7 mm pultruded carbon tube, 532 mm | Landing legs | 4 | carbon | cut / laser-cut | 9.72 | 38.9
CLIP-RET | Spring-steel clip retainer + M2 screw | Motor bay | 1 | steel | bend / form | 1.5 | 1.5
CLIP-RET-L | Spring-steel clip retainer + M2 screw | Motor bay | 1 | steel | bend / form | 1.5 | 1.5
F25W-SPACER | F25W 13 mm spacer (both nozzles exit together) | Motor bay | 1 | petg | 3D print | 4.12 | 4.1 | stl/F25W-SPACER.stl
GIMBAL-INNER | Gimbal inner ring (holds both sleeves), CF-nylon | Motor bay | 1 | cf_nylon | 3D print | 9.65 | 9.6 | stl/GIMBAL-INNER.stl
GIMBAL-MIDDLE | Gimbal middle ring, CF-nylon | Motor bay | 1 | cf_nylon | 3D print | 12.98 | 13.0 | stl/GIMBAL-MIDDLE.stl
GIMBAL-POST | Gimbal yoke post (outer frame), CF-nylon | Motor bay | 1 | cf_nylon | 3D print | 6.11 | 6.1 | stl/GIMBAL-POST.stl
GIMBAL-POST-B | Gimbal yoke post (outer frame), CF-nylon | Motor bay | 1 | cf_nylon | 3D print | 6.11 | 6.1 | stl/GIMBAL-POST-B.stl
HORN-GIMBAL-A | Servo horn (10 mm) | Motor bay | 1 | cf_nylon | buy | 0.4 | 0.4
HORN-GIMBAL-B | Servo horn (10 mm) | Motor bay | 1 | cf_nylon | buy | 0.4 | 0.4
IGN-CONN | Landing-igniter 2-pin locking connector | Motor bay | 1 | electronics | buy | 0.5 | 0.5
LIDAR-BRKT | Lidar bracket, CF-nylon | Motor bay | 1 | cf_nylon | 3D print | 4.51 | 4.5 | stl/LIDAR-BRKT.stl
LIDAR-TFMINI | Benewake TFmini-S lidar, looking down | Motor bay | 1 | electronics | buy | 5.0 | 5.0
LIDAR-WINDOW | Replaceable 1 mm polycarbonate lidar window | Motor bay | 1 | polycarb | cut / laser-cut | 0.76 | 0.8
PIN-X | Gimbal pin, 3 mm steel (X axis) | Motor bay | 2 | steel | buy | 0.68 | 1.4
PIN-Y | Gimbal pin, 3 mm steel (Y axis) | Motor bay | 2 | steel | buy | 1.04 | 2.1
PUSHROD-A | 1.5 mm steel pushrod with ball links | Motor bay | 1 | steel | buy | 1.2 | 1.2
PUSHROD-B | 1.5 mm steel pushrod with ball links | Motor bay | 1 | steel | buy | 1.2 | 1.2
SERVO-BRKT-A | Gimbal servo bracket, CF-nylon | Motor bay | 1 | cf_nylon | 3D print | 1.07 | 1.1 | stl/SERVO-BRKT-A.stl
SERVO-BRKT-B | Gimbal servo bracket, CF-nylon | Motor bay | 1 | cf_nylon | 3D print | 1.07 | 1.1 | stl/SERVO-BRKT-B.stl
SERVO-GIMBAL-A | KST X08H gimbal servo A (pitch, drives middle ring) | Motor bay | 1 | servo | buy | 8.0 | 8.0
SERVO-GIMBAL-B | KST X08H gimbal servo B (yaw, drives inner ring) | Motor bay | 1 | servo | buy | 8.0 | 8.0
SLEEVE-29 | 29 mm motor sleeve, kraft motor-mount tube, 113 mm (high-temp epoxy) | Motor bay | 2 | kraft_cpl | cut from tube stock | 8.11 | 16.2
SLEEVE-CAP | Sleeve thrust cap, aluminium (igniter-lead hole) | Motor bay | 2 | aluminium | machine | 5.4 | 10.8
THRUST-PLATE | Thrust plate, 1/8 in ply ring | Motor bay | 1 | ply | cut / laser-cut | 5.96 | 6.0 |  | dxf/THRUST-PLATE.dxf
THRUST-PLATE-AL | Thrust plate, 1 mm aluminium ring | Motor bay | 1 | aluminium | cut / laser-cut | 7.46 | 7.5 |  | dxf/THRUST-PLATE-AL.dxf
HEAT-SHIELD | Servo heat shield, aluminium + ceramic paper | Throttle | 1 | aluminium | cut / laser-cut | 0.54 | 0.5
HORN-PADDLE | Servo horn (10 mm) | Throttle | 1 | cf_nylon | buy | 0.4 | 0.4
PADDLE-ARM-IL | Paddle arm, 1.5 mm 304 stainless | Throttle | 1 | steel | machine | 0.61 | 0.6
PADDLE-ARM-IR | Paddle arm, 1.5 mm 304 stainless | Throttle | 1 | steel | machine | 0.61 | 0.6
PADDLE-ARM-OL | Paddle arm with lever, 1.5 mm 304 stainless | Throttle | 1 | steel | machine | 0.67 | 0.7
PADDLE-ARM-OR | Paddle arm with lever, 1.5 mm 304 stainless | Throttle | 1 | steel | machine | 0.67 | 0.7
PADDLE-BRKT | Paddle bracket on the inner gimbal ring, 1.5 mm 6061 aluminium | Throttle | 1 | aluminium | machine | 7.99 | 8.0 |  |  | Wrap the plume-facing rails in stainless tape / ceramic paper.
PADDLE-L | Throttle paddle, alumina-silicate ceramic 20 x 28 x 4 | Throttle | 1 | ceramic | machine | 5.15 | 5.2
PADDLE-LINK-L | Scissor link | Throttle | 1 | steel | buy | 0.3 | 0.3
PADDLE-LINK-R | Scissor link | Throttle | 1 | steel | buy | 0.3 | 0.3
PADDLE-PIN-L | Paddle pivot pin, 2 mm steel | Throttle | 1 | steel | buy | 0.76 | 0.8
PADDLE-PIN-R | Paddle pivot pin, 2 mm steel | Throttle | 1 | steel | buy | 0.76 | 0.8
PADDLE-R | Throttle paddle, alumina-silicate ceramic 20 x 28 x 4 | Throttle | 1 | ceramic | machine | 5.15 | 5.2
PADDLE-SERVO-LINK | Servo-to-crosshead link | Throttle | 1 | steel | buy | 0.3 | 0.3
PADDLE-XHEAD | Scissor crosshead | Throttle | 1 | steel | machine | 0.43 | 0.4
SERVO-PADDLE | KST X08H paddle (throttle) servo, strapped to the bracket | Throttle | 1 | servo | buy | 8.0 | 8.0
MOTOR-F25W | AeroTech F25W landing motor (29 x 98 mm, 97 g) | Motors | 1 | motor_f25w | buy | 97.2 | 97.2 |  |  | Two igniters, fired by the flight computer.
MOTOR-F52C | AeroTech F52C ascent motor (29 x 111 mm, 81 g) | Motors | 1 | motor_f42t | buy | 81.4 | 81.4 |  |  | Plugged / no-ejection configuration only.
