chaseyarnall173/Self-Landing-Rocket/cad/out/parts/MAIN-SW.step

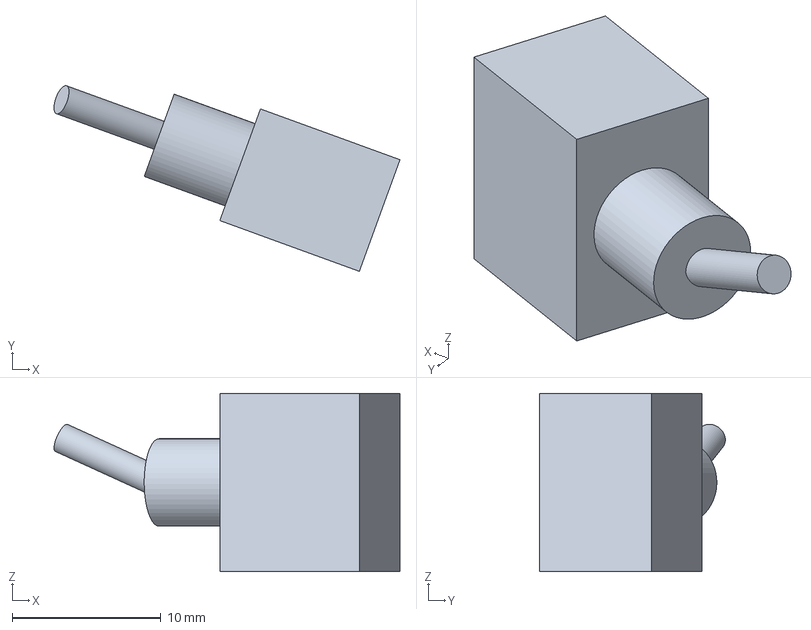
[picture p165: CAD file, 2026-10-11]
cad/out/parts/MAIN-SW.step
23.3 x 12.5 x 12.0 mm
