chaseyarnall173/Self-Landing-Rocket/cad/out/parts/TUBE-03.step

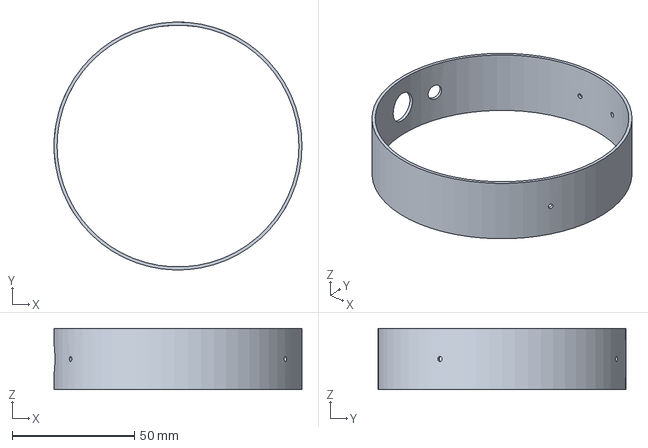
[picture p166: CAD file, 2026-10-11]
cad/out/parts/TUBE-03.step
101.6 x 101.6 x 25.0 mm
