chaseyarnall173/Self-Landing-Rocket/cad/out/SLR1_landing.step

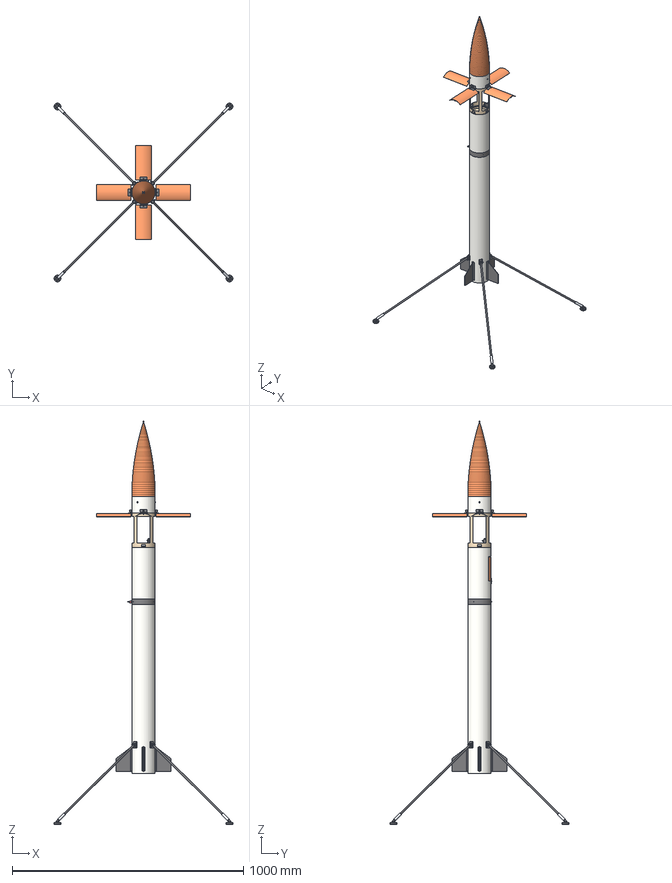
[picture p167: CAD file, 2026-10-11]
cad/out/SLR1_landing.step
774.3 x 774.3 x 1744.1 mm
NOSE-01-1
NOSE-SCREW-1 x 3
TUBE-01-1
TUBE-02-1
PETAL-HINGE-F-1 x 4
PETAL-01-1 x 4
PETAL-HINGE-M-1 x 4
PETAL-PIN-1 x 4
PETAL-SPRING-1 x 4
PETAL-TAB-1 x 4
CPL-01-1
LATCH-RING-1
SERVO-LATCH-1
HORN-LATCH-1
LATCH-LINK-1
LATCH-SERVO-BRKT-1
DOOR-01-1
DOOR-HINGE-F-1
DOOR-HINGE-M-1
DOOR-PIN-1
DOOR-LUG-1
RECOV-BH-1
UBOLT-1
NUT-M4-1 x 2
CHUTE-NOMEX-1
CHUTE-30-1
SHOCK-CORD-1
SHOCK-CORD-RUN-1
EJECT-PLATE-1
EJECT-SPRING-1 x 2
EJECT-CUP-1 x 2
SERVO-CHUTE-1
HORN-CHUTE-1
CHUTE-PIN-1
CHUTE-LINK-1
CHUTE-SERVO-BRKT-1
CABLE-FWD-1
TUBE-03-1
CPL-02-1
AV-LID-F-1
AV-LID-A-1
AV-LID-RING-F-1
AV-LID-RING-A-1
AV-ROD-1 x 2
NUT-M3-1 x 4
AV-SLED-1
AV-SLED-TUBE-1 x 2
STANDOFF-3-1 x 4
PERFBOARD-1
HEADERS-1
TEENSY-41-1
IMU-BMI088-1
STANDOFF-5-1
BARO-BMP390-1
BARO-FOAM-1
BUCK-5V-1
FET-AO3400-1 x 2
CAP-1000U-1
BUZZER-1
JST-GH-1 x 6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
