chaseyarnall173/Self-Landing-Rocket/cad/out/parts/AV-LID-RING-A.step

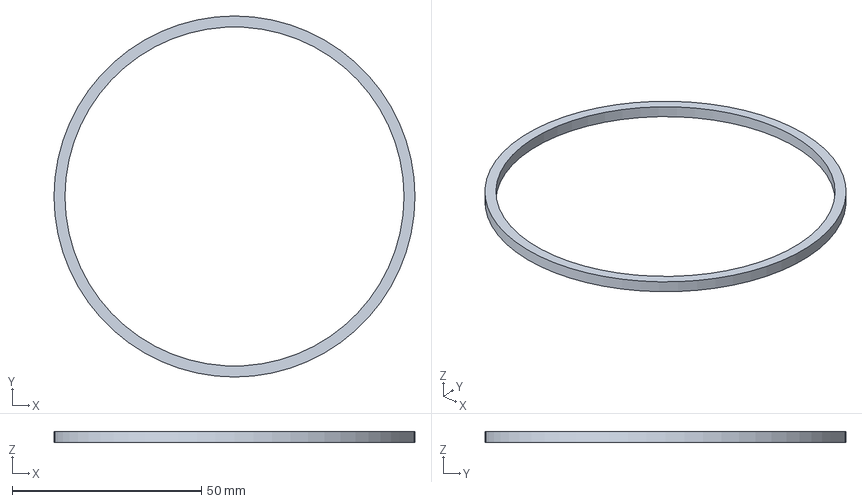
[picture p168: CAD file, 2026-10-11]
cad/out/parts/AV-LID-RING-A.step
95.3 x 95.3 x 3.00 mm
