chaseyarnall173/Self-Landing-Rocket/cad/out/parts/LEG-FOOT.step

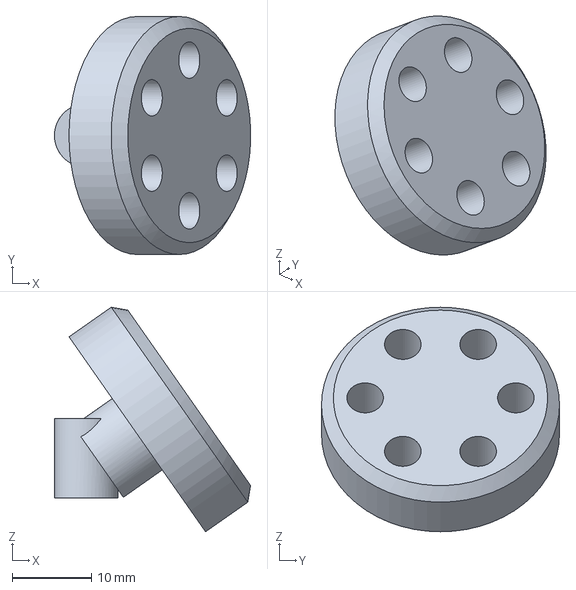
[picture p170: CAD file, 2026-10-11]
cad/out/parts/LEG-FOOT.step
24.7 x 30.0 x 28.3 mm
