chaseyarnall173/Self-Landing-Rocket/cad/out/parts/JST-GH.step

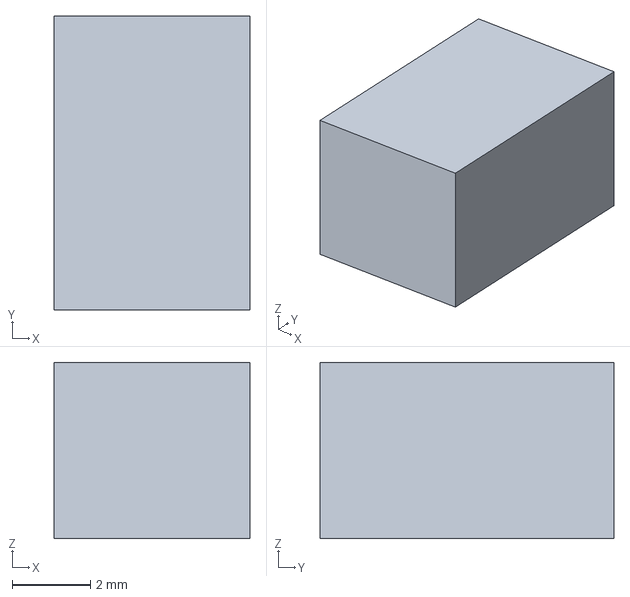
[picture p171: CAD file, 2026-10-11]
cad/out/parts/JST-GH.step
5.00 x 7.50 x 4.50 mm
