chaseyarnall173/Self-Landing-Rocket/cad/out/parts/CABLE-FWD.step

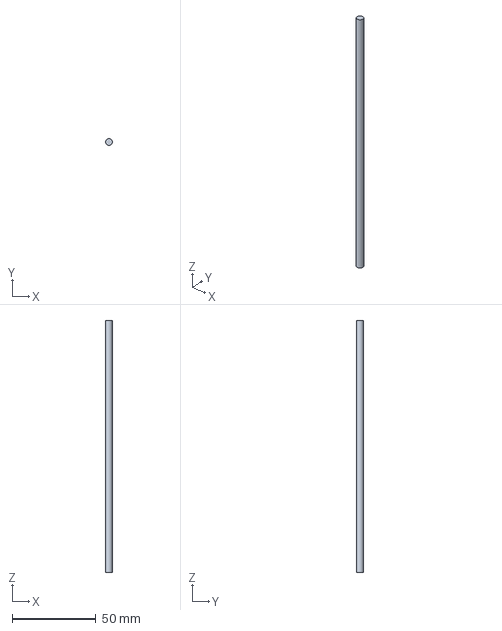
[picture p172: CAD file, 2026-10-11]
cad/out/parts/CABLE-FWD.step
4.00 x 4.00 x 150.2 mm
