chaseyarnall173/Self-Landing-Rocket/cad/out/parts/EJECT-SPRING.step

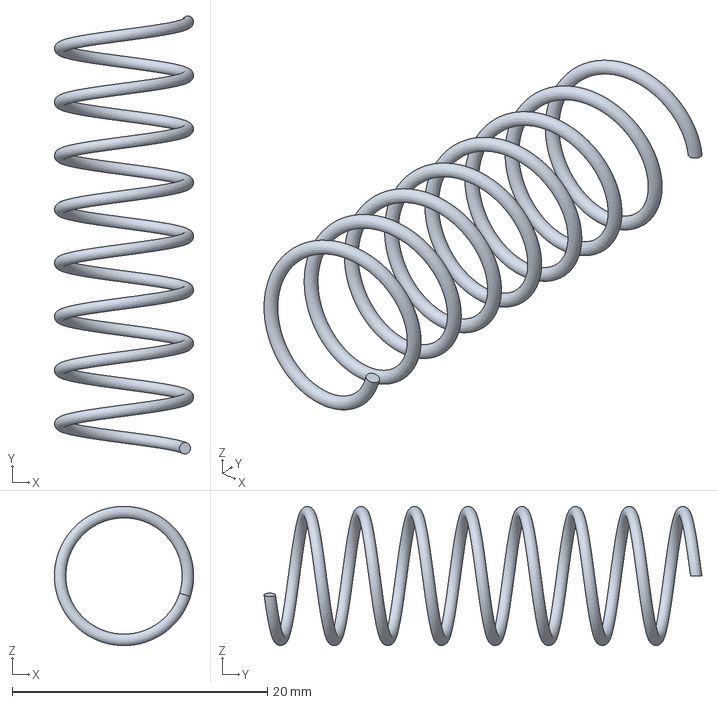
[picture p173: CAD file, 2026-10-11]
cad/out/parts/EJECT-SPRING.step
10.9 x 34.3 x 10.9 mm
