chaseyarnall173/Self-Landing-Rocket/cad/out/parts/LATCH-SERVO-BRKT.step

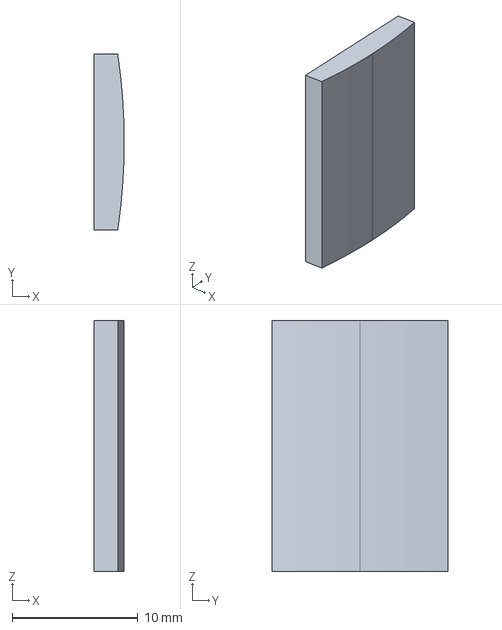
[picture p174: CAD file, 2026-10-11]
cad/out/parts/LATCH-SERVO-BRKT.step
2.43 x 14.0 x 20.0 mm
