chaseyarnall173/Self-Landing-Rocket/cad/out/parts/TUBE-01.step

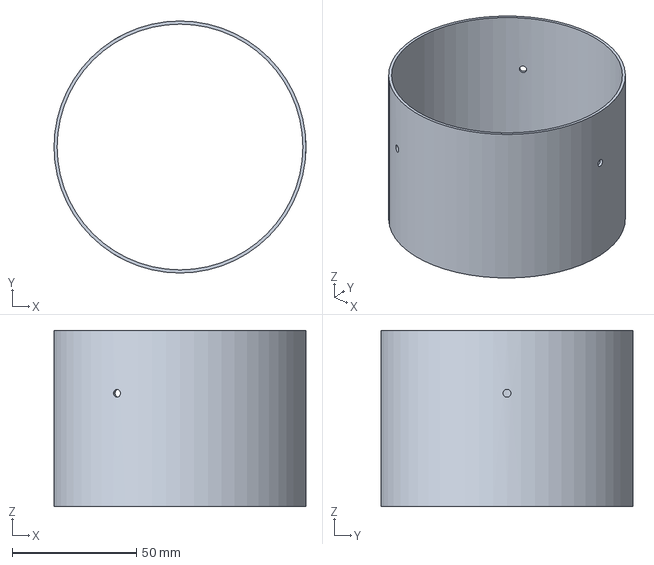
[picture p175: CAD file, 2026-10-11]
cad/out/parts/TUBE-01.step
101.6 x 101.6 x 71.2 mm
