chaseyarnall173/Self-Landing-Rocket/cad/out/parts/HARNESS-AFT.step

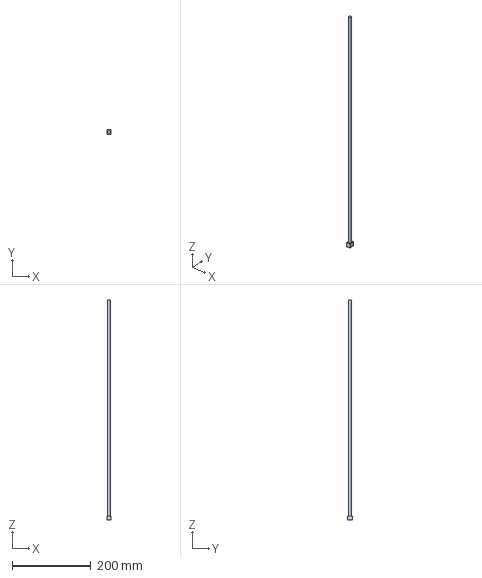
[picture p176: CAD file, 2026-10-11]
cad/out/parts/HARNESS-AFT.step
9.00 x 12.0 x 559.0 mm
