chaseyarnall173/Self-Landing-Rocket/cad/out/parts/GIMBAL-POST.step

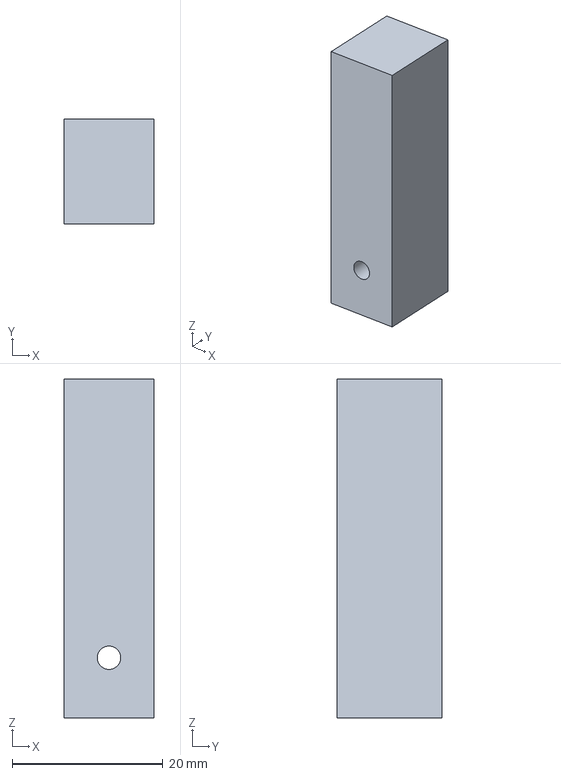
[picture p177: CAD file, 2026-10-11]
cad/out/parts/GIMBAL-POST.step
12.0 x 14.0 x 45.0 mm
