chaseyarnall173/Self-Landing-Rocket/cad/out/parts/GPS-M9N.step

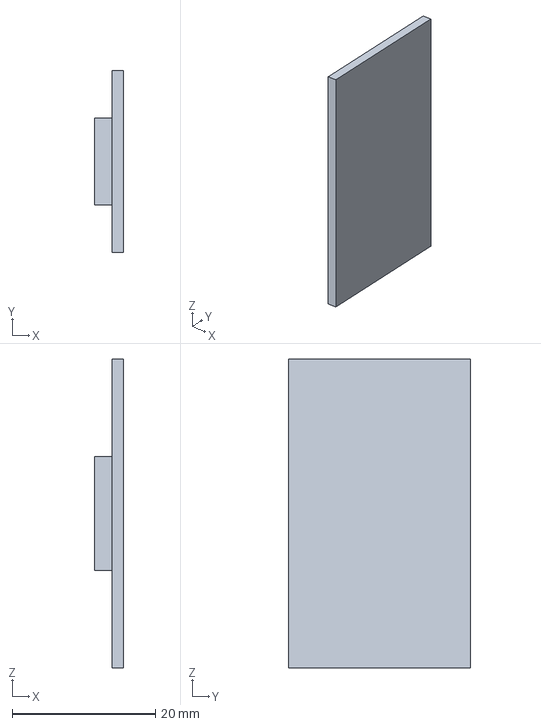
[picture p178: CAD file, 2026-10-11]
cad/out/parts/GPS-M9N.step
4.00 x 25.4 x 43.2 mm
