chaseyarnall173/Self-Landing-Rocket/cad/out/parts/LEGPIN-LINK.step

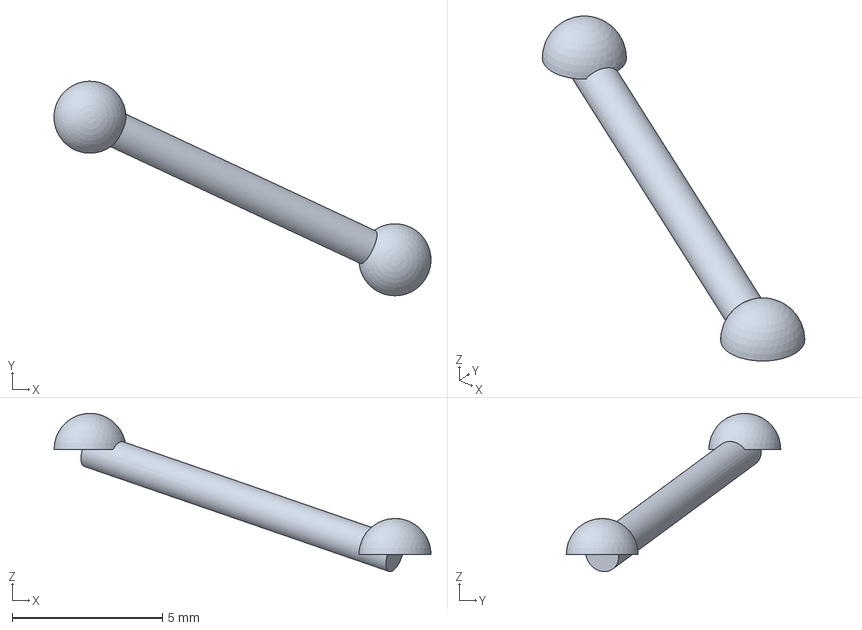
[picture p179: CAD file, 2026-10-11]
cad/out/parts/LEGPIN-LINK.step
12.6 x 7.15 x 5.27 mm
