chaseyarnall173/Self-Landing-Rocket/cad/out/parts/DOOR-PIN.step

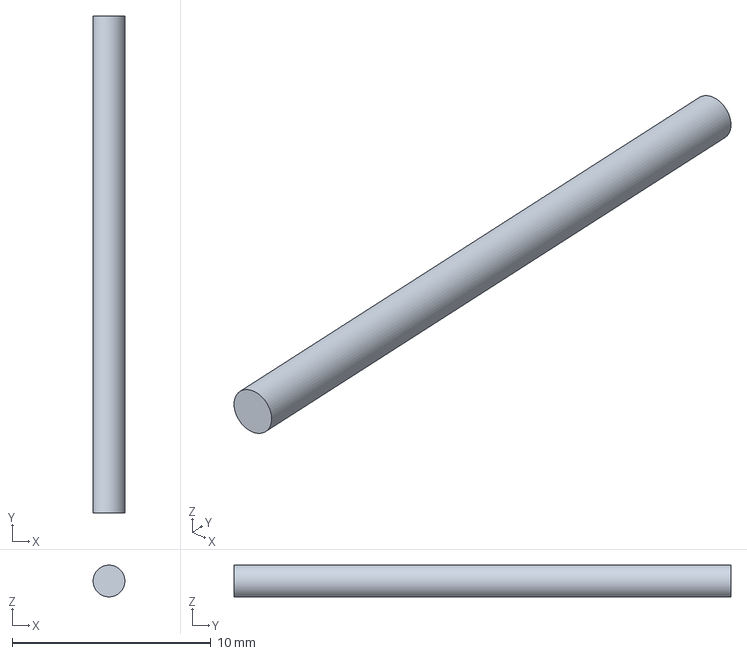
[picture p180: CAD file, 2026-10-11]
cad/out/parts/DOOR-PIN.step
1.60 x 25.0 x 1.60 mm
