chaseyarnall173/Self-Landing-Rocket/cad/out/parts/CHUTE-NOMEX.step

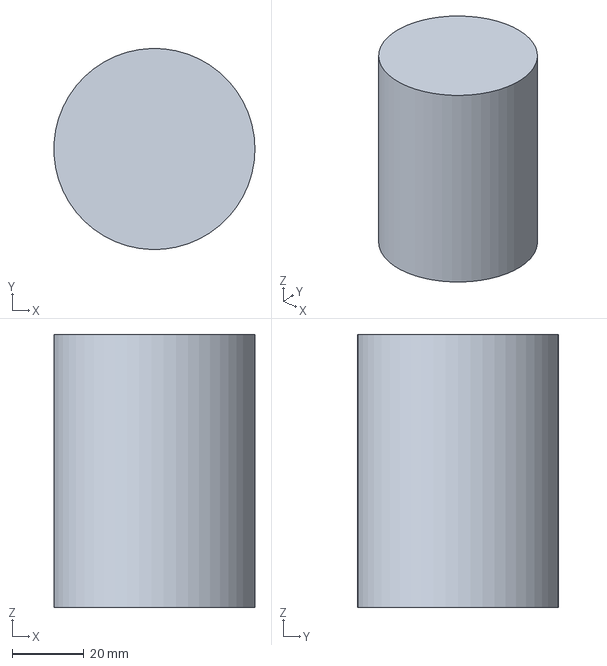
[picture p181: CAD file, 2026-10-11]
cad/out/parts/CHUTE-NOMEX.step
55.9 x 56.0 x 76.0 mm
