chaseyarnall173/Self-Landing-Rocket/cad/out/parts/HORN-LEGPIN.step

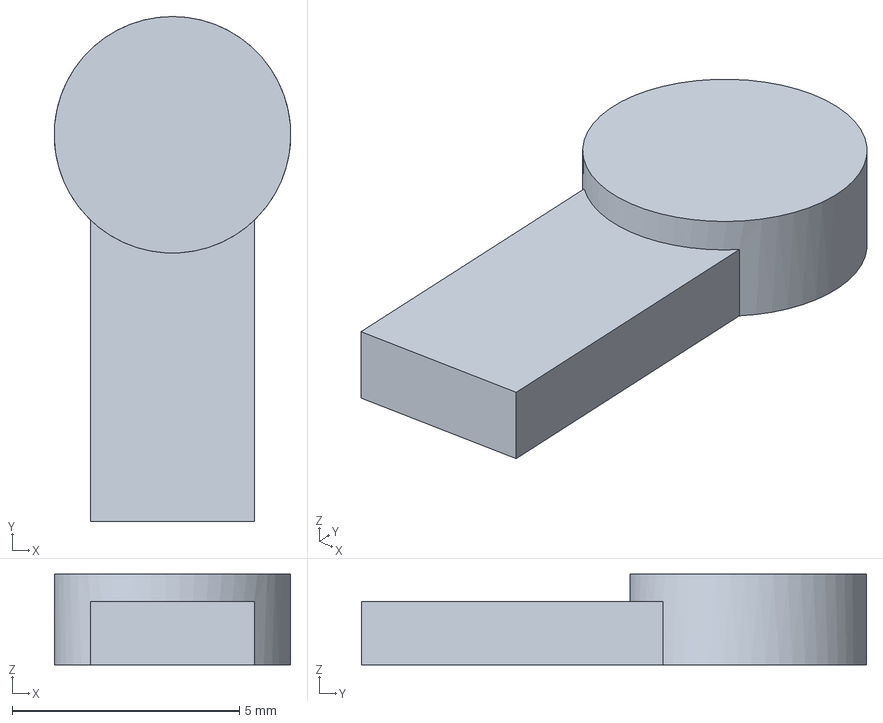
[picture p182: CAD file, 2026-10-11]
cad/out/parts/HORN-LEGPIN.step
5.20 x 11.1 x 2.00 mm
