chaseyarnall173/Self-Landing-Rocket/cad/out/parts/STANDOFF-5.step

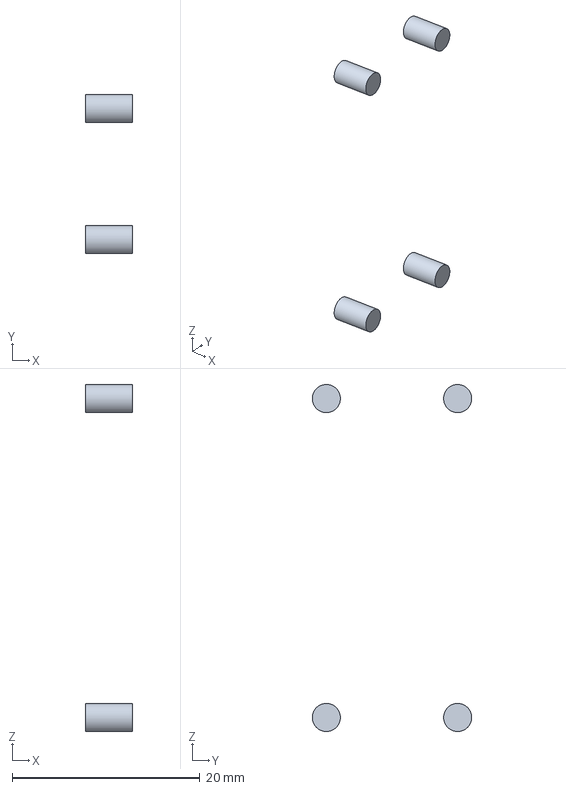
[picture p183: CAD file, 2026-10-11]
cad/out/parts/STANDOFF-5.step
5.00 x 17.0 x 37.0 mm
