chaseyarnall173/Self-Landing-Rocket/cad/out/parts/DOOR-LUG.step

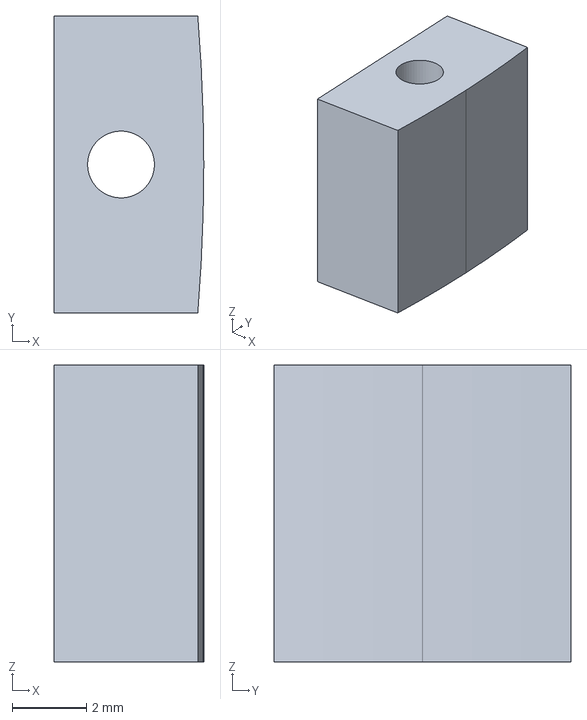
[picture p184: CAD file, 2026-10-11]
cad/out/parts/DOOR-LUG.step
4.03 x 8.00 x 8.00 mm
