chaseyarnall173/Self-Landing-Rocket/cad/out/parts/STANDOFF-3.step

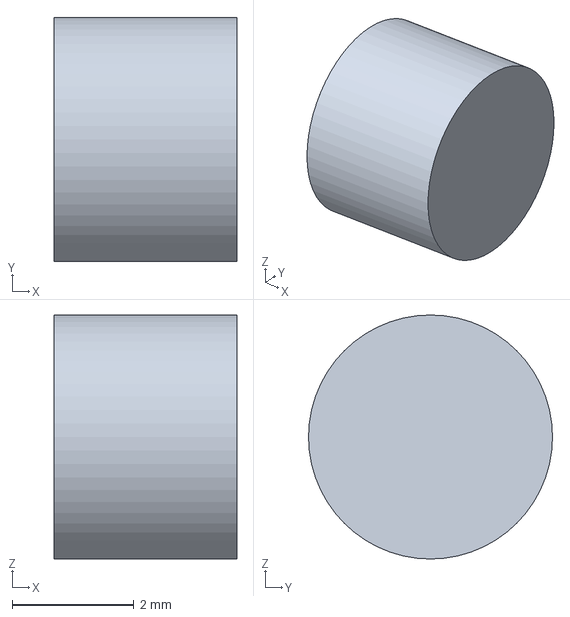
[picture p185: CAD file, 2026-10-11]
cad/out/parts/STANDOFF-3.step
3.00 x 4.00 x 4.00 mm
