chaseyarnall173/Self-Landing-Rocket/cad/out/parts/BARO-FOAM.step

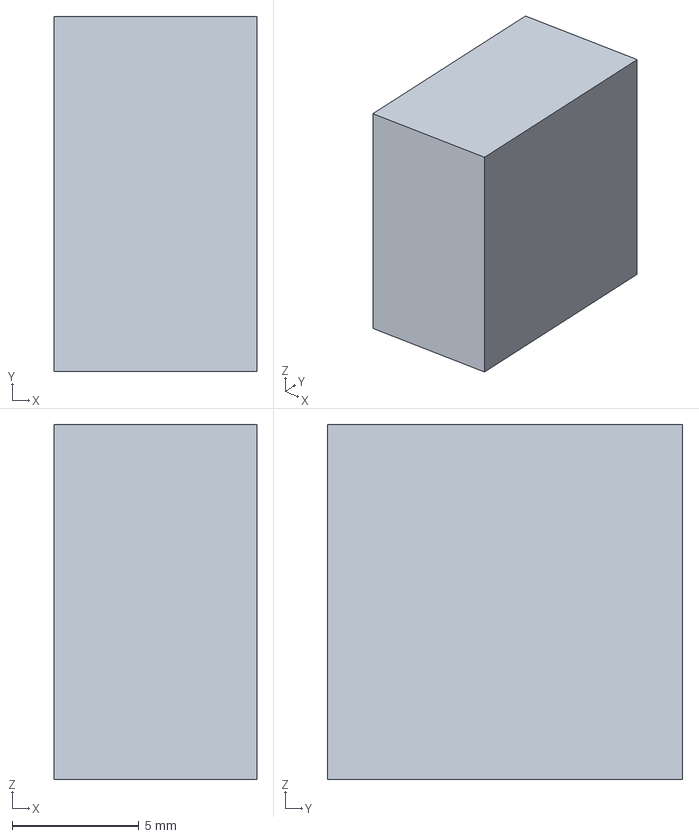
[picture p186: CAD file, 2026-10-11]
cad/out/parts/BARO-FOAM.step
8.00 x 14.0 x 14.0 mm
