chaseyarnall173/Self-Landing-Rocket/cad/out/parts/PUSHROD-B.step

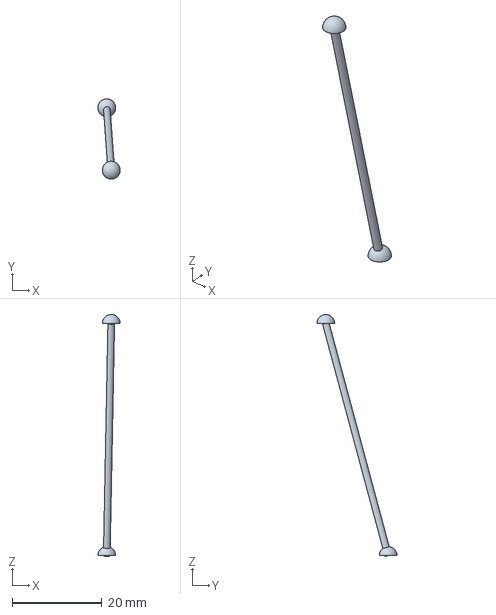
[picture p187: CAD file, 2026-10-11]
cad/out/parts/PUSHROD-B.step
5.00 x 17.9 x 53.9 mm
