chaseyarnall173/Self-Landing-Rocket/cad/out/parts/PADDLE-ARM-IR.step

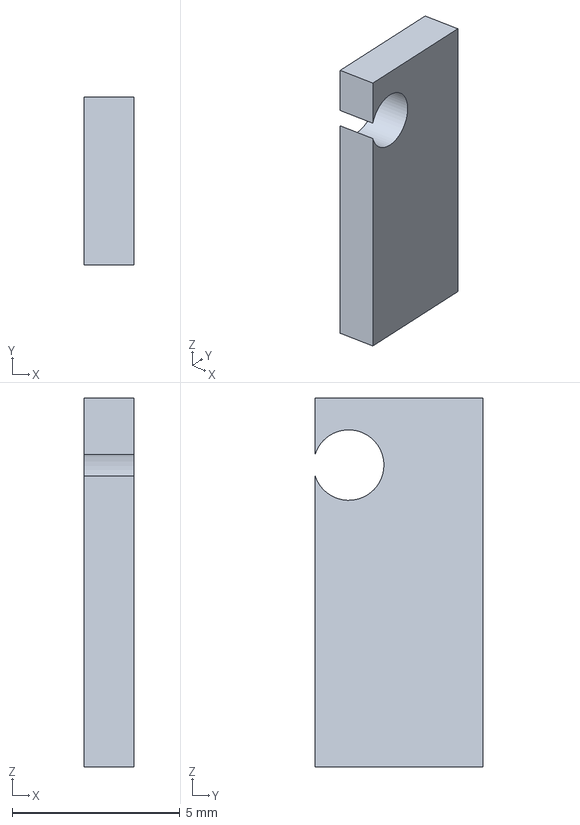
[picture p188: CAD file, 2026-10-11]
cad/out/parts/PADDLE-ARM-IR.step
1.50 x 5.00 x 11.0 mm
