chaseyarnall173/Self-Landing-Rocket/cad/out/parts/SERVO-BRKT-A.step

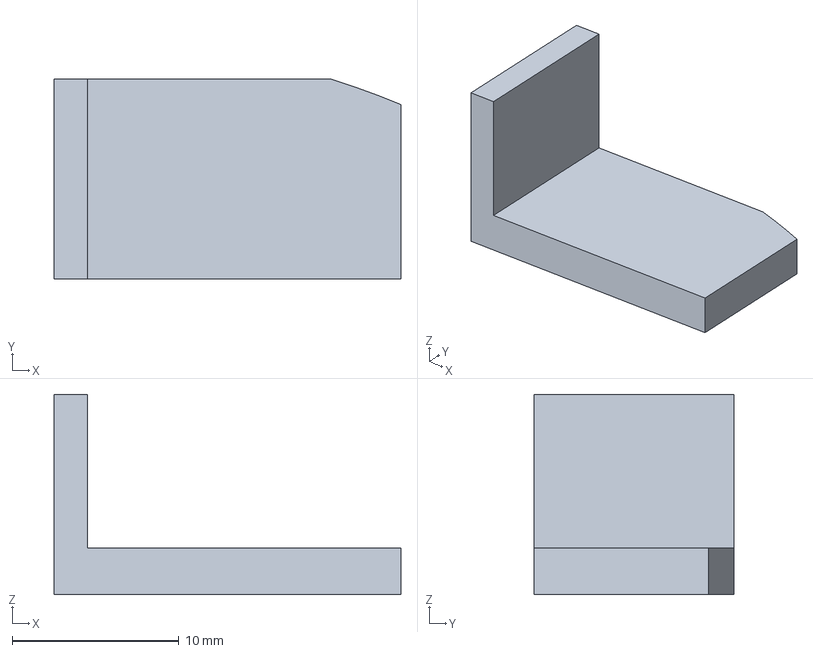
[picture p189: CAD file, 2026-10-11]
cad/out/parts/SERVO-BRKT-A.step
20.8 x 12.0 x 12.0 mm
