chaseyarnall173/Self-Landing-Rocket/cad/out/parts/PETAL-HINGE-M.step

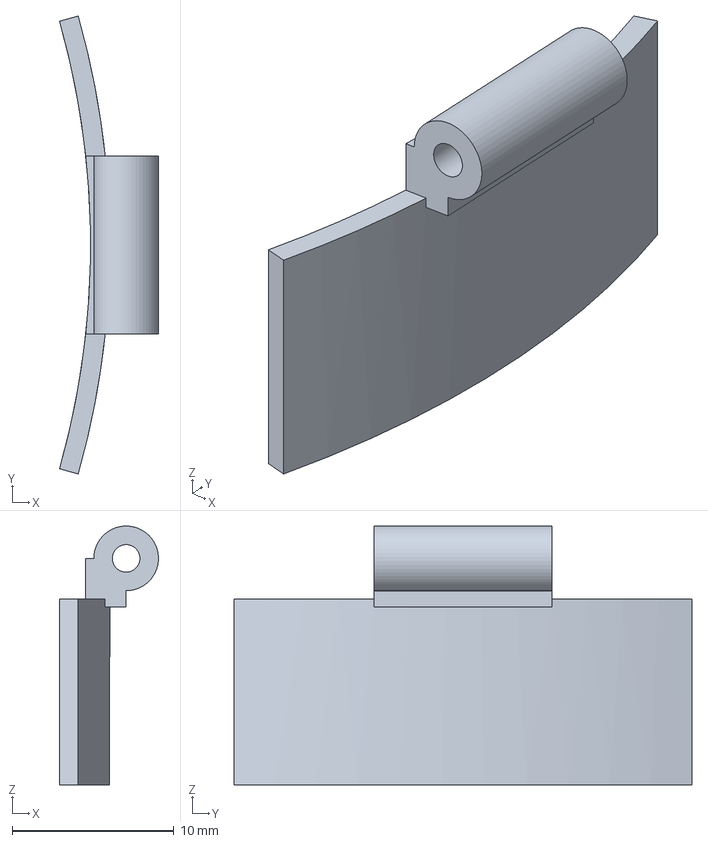
[picture p190: CAD file, 2026-10-11]
cad/out/parts/PETAL-HINGE-M.step
6.12 x 28.3 x 16.0 mm
