chaseyarnall173/Self-Landing-Rocket/cad/out/parts/PADDLE-ARM-OR.step

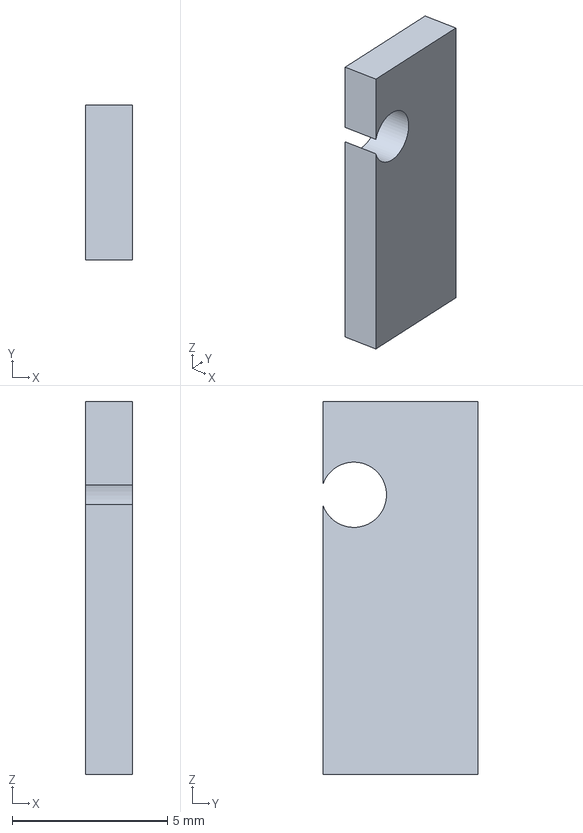
[picture p191: CAD file, 2026-10-11]
cad/out/parts/PADDLE-ARM-OR.step
1.50 x 5.00 x 12.0 mm
