chaseyarnall173/Self-Landing-Rocket/cad/out/parts/PADDLE-PIN-R.step

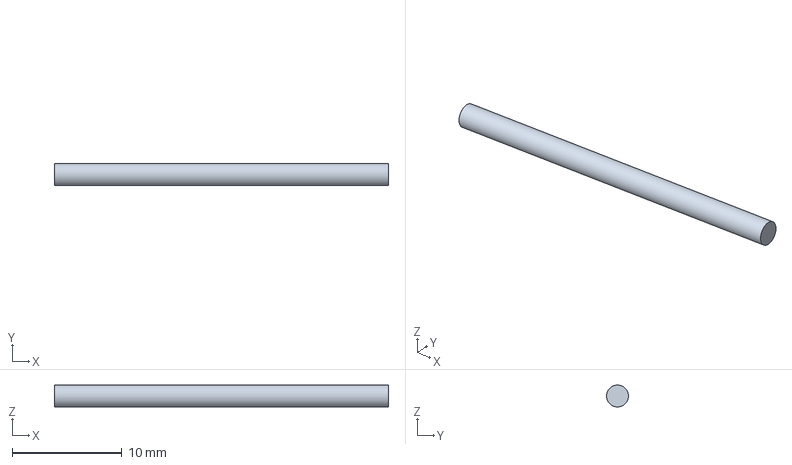
[picture p192: CAD file, 2026-10-11]
cad/out/parts/PADDLE-PIN-R.step
30.5 x 2.00 x 2.00 mm
