chaseyarnall173/Self-Landing-Rocket/cad/out/parts/SERVO-PADDLE.step

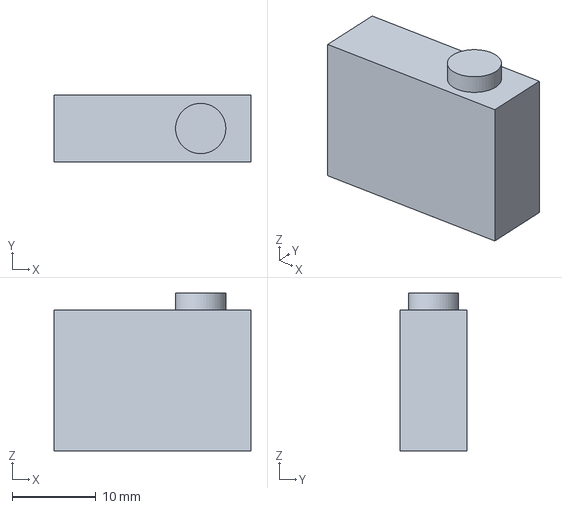
[picture p193: CAD file, 2026-10-11]
cad/out/parts/SERVO-PADDLE.step
23.5 x 8.00 x 18.8 mm
