chaseyarnall173/Self-Landing-Rocket/cad/out/parts/LEG-INSERT.step

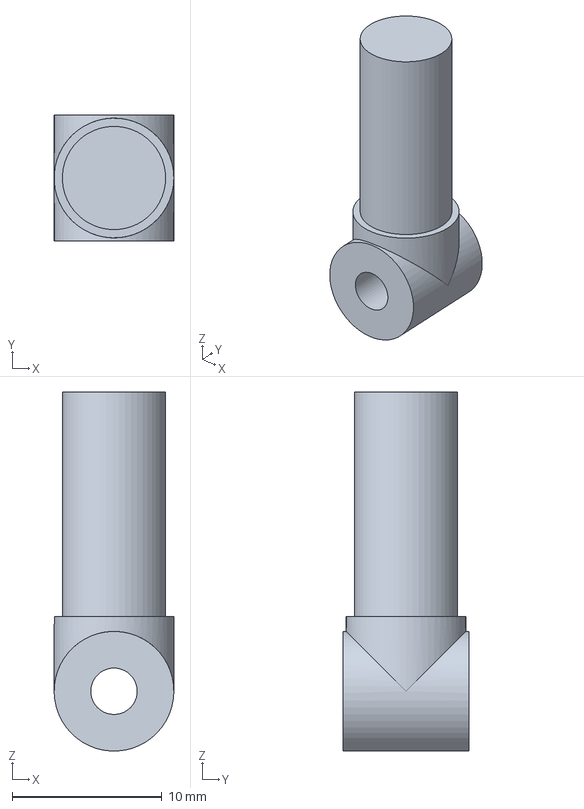
[picture p194: CAD file, 2026-10-11]
cad/out/parts/LEG-INSERT.step
8.00 x 8.40 x 24.0 mm
