chaseyarnall173/Self-Landing-Rocket/cad/out/parts/BUZZER.step

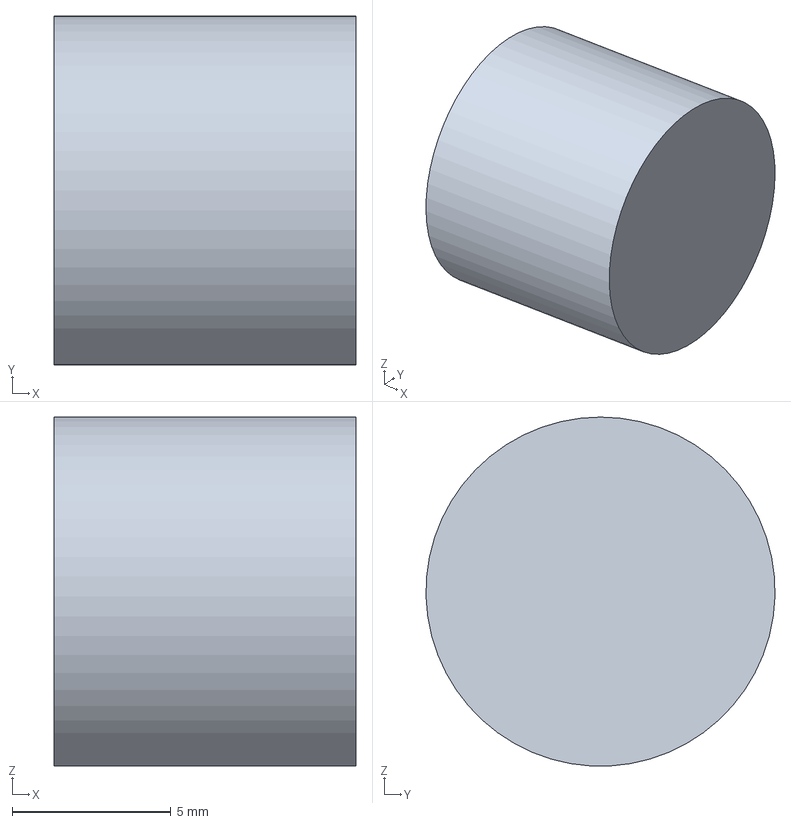
[picture p196: CAD file, 2026-10-11]
cad/out/parts/BUZZER.step
9.50 x 11.0 x 11.0 mm
