chaseyarnall173/Self-Landing-Rocket/cad/out/parts/AV-LID-F.step

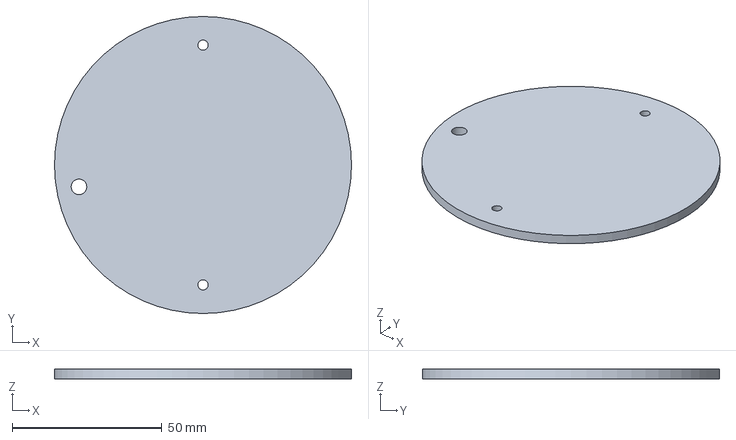
[picture p197: CAD file, 2026-10-11]
cad/out/parts/AV-LID-F.step
99.1 x 99.1 x 3.17 mm
