chaseyarnall173/Self-Landing-Rocket/cad/out/parts/LEG-SPRING.step

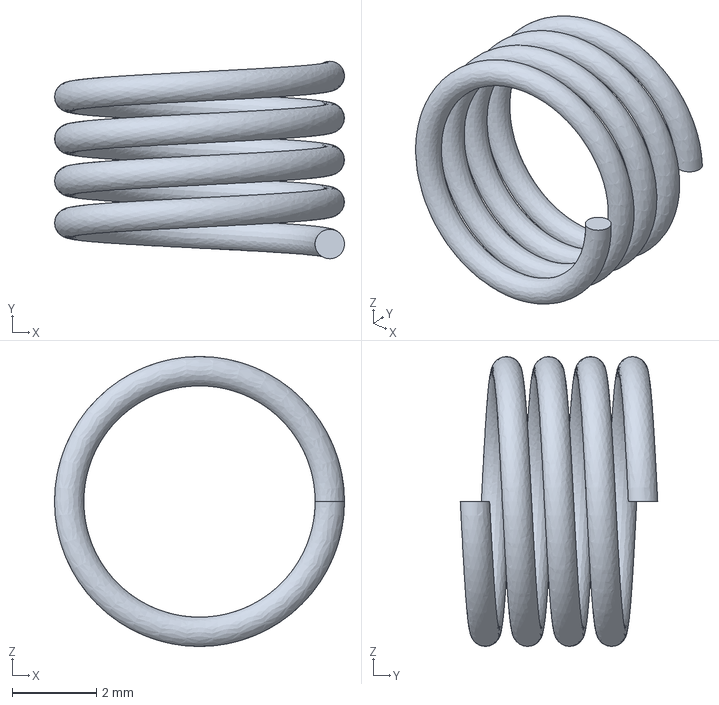
[picture p198: CAD file, 2026-10-11]
cad/out/parts/LEG-SPRING.step
6.90 x 4.70 x 6.90 mm
