chaseyarnall173/Self-Landing-Rocket/cad/out/parts/ARM-KEY.step

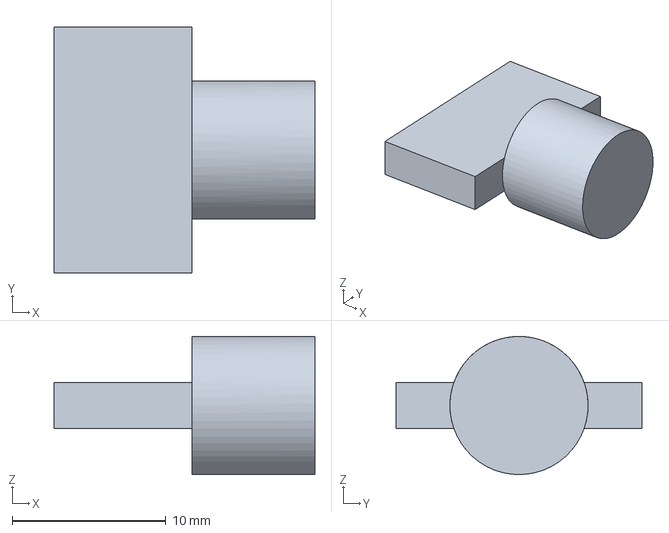
[picture p199: CAD file, 2026-10-11]
cad/out/parts/ARM-KEY.step
17.0 x 16.0 x 9.00 mm
