chaseyarnall173/Self-Landing-Rocket/cad/out/parts/SLEEVE-CAP.step

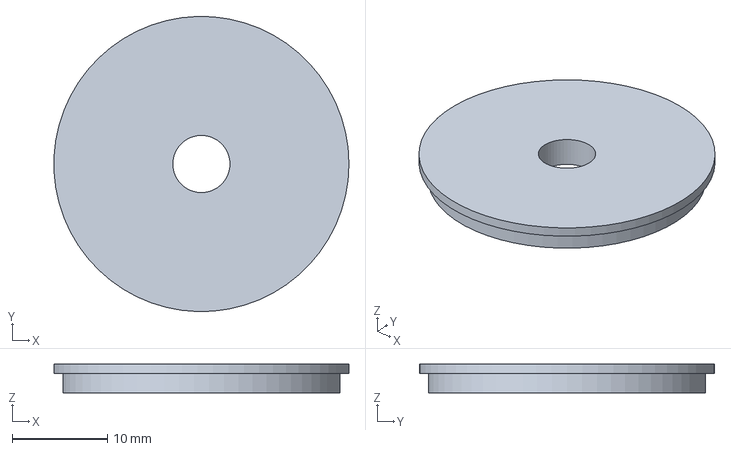
[picture p200: CAD file, 2026-10-11]
cad/out/parts/SLEEVE-CAP.step
31.0 x 31.0 x 3.00 mm
