chaseyarnall173/Self-Landing-Rocket/cad/out/parts/SHOCK-CORD.step

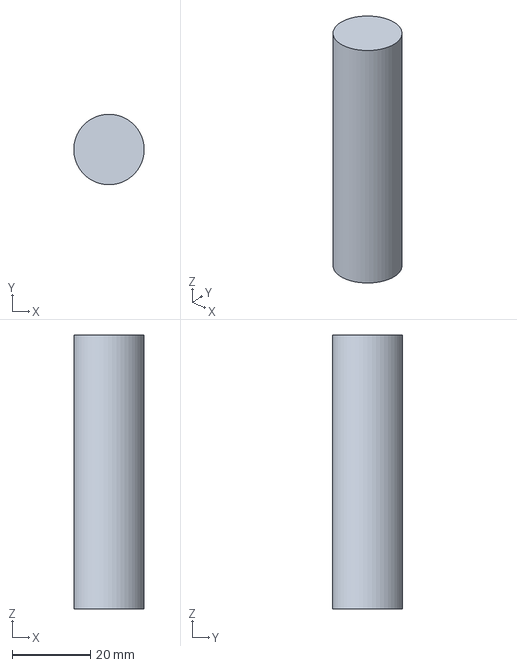
[picture p201: CAD file, 2026-10-11]
cad/out/parts/SHOCK-CORD.step
18.0 x 18.0 x 70.0 mm
