chaseyarnall173/Self-Landing-Rocket/cad/out/parts/LIPO-2S.step

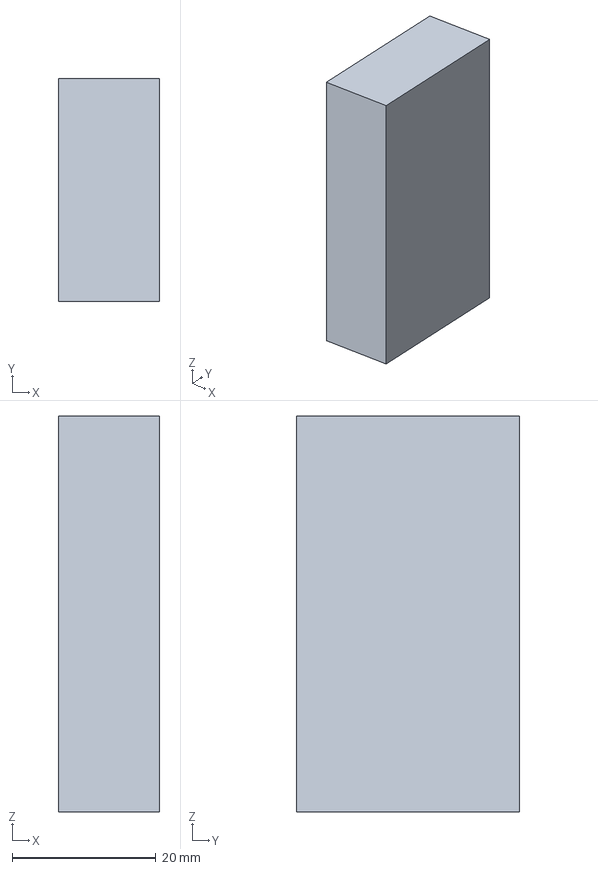
[picture p202: CAD file, 2026-10-11]
cad/out/parts/LIPO-2S.step
14.0 x 31.0 x 55.0 mm
