chaseyarnall173/Self-Landing-Rocket/cad/out/parts/FIN-01.step

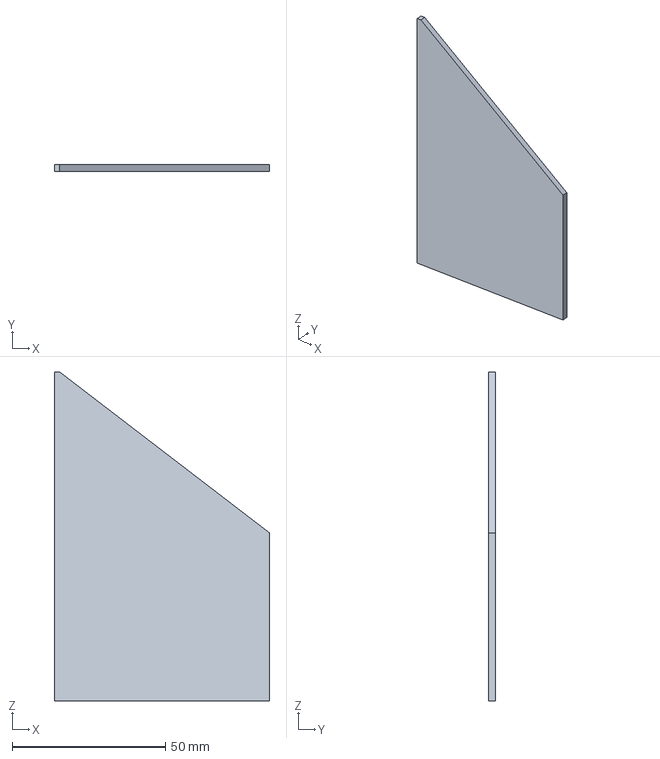
[picture p203: CAD file, 2026-10-11]
cad/out/parts/FIN-01.step
70.3 x 2.38 x 107.4 mm
