chaseyarnall173/Self-Landing-Rocket/cad/out/parts/PERFBOARD.step

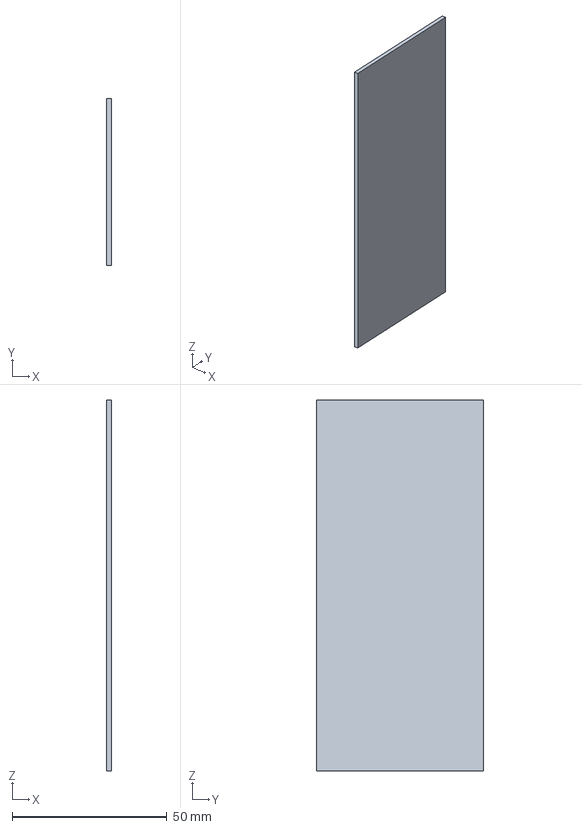
[picture p204: CAD file, 2026-10-11]
cad/out/parts/PERFBOARD.step
1.60 x 54.0 x 120.0 mm
