chaseyarnall173/Self-Landing-Rocket/cad/out/parts/GROMMET.step

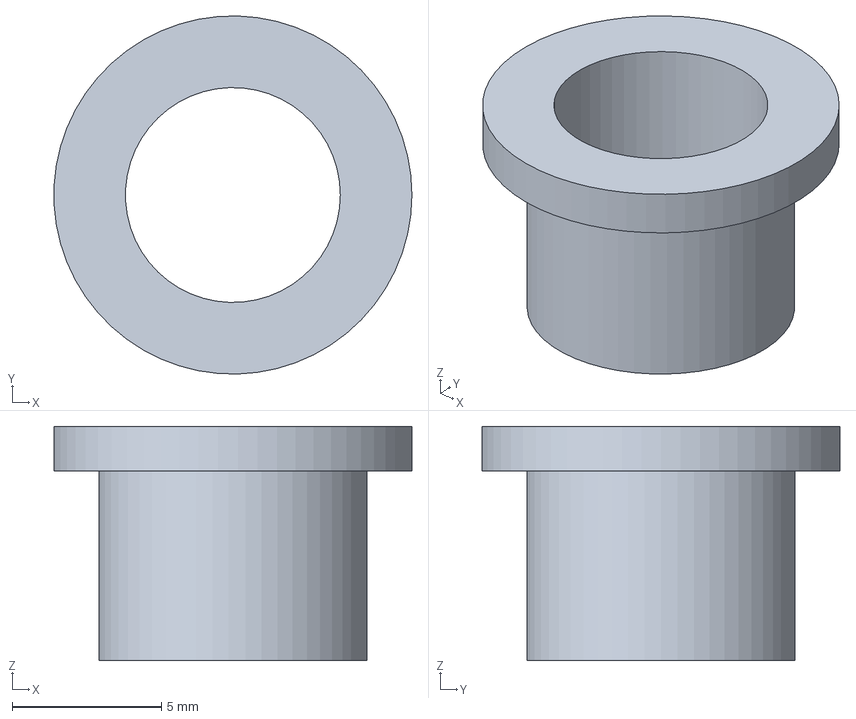
[picture p205: CAD file, 2026-10-11]
cad/out/parts/GROMMET.step
12.0 x 12.0 x 7.85 mm
