chaseyarnall173/Self-Landing-Rocket/cad/out/parts/EJECT-PLATE.step

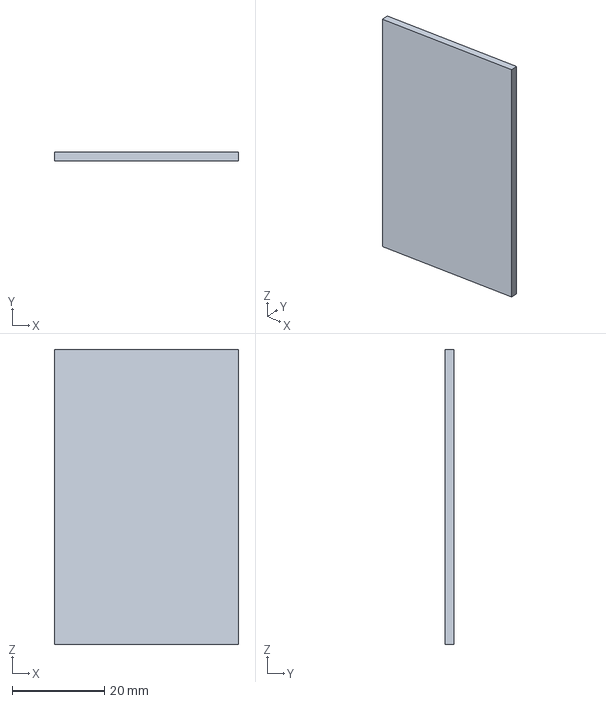
[picture p206: CAD file, 2026-10-11]
cad/out/parts/EJECT-PLATE.step
40.0 x 2.00 x 64.0 mm
