chaseyarnall173/Self-Landing-Rocket/cad/out/parts/LEG-DAMPER.step

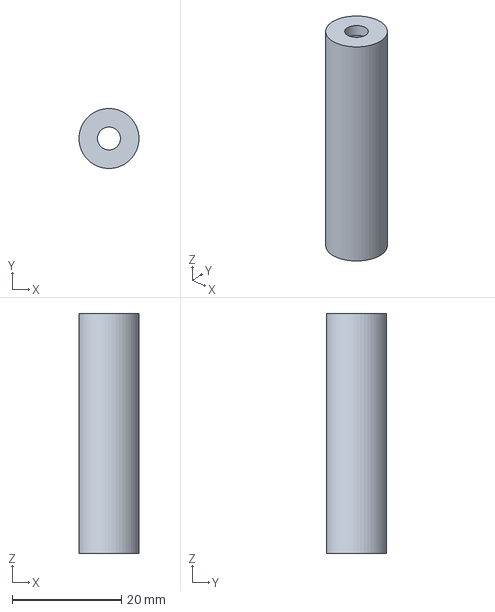
[picture p207: CAD file, 2026-10-11]
cad/out/parts/LEG-DAMPER.step
11.0 x 11.0 x 44.0 mm
