chaseyarnall173/Self-Landing-Rocket/cad/out/parts/MOTOR-F25W.step

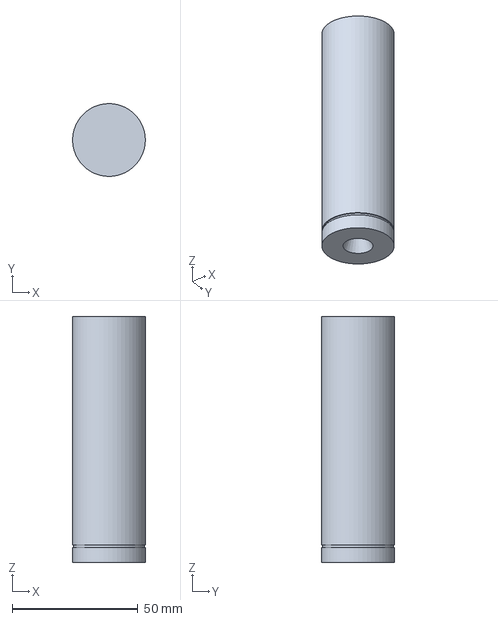
[picture p208: CAD file, 2026-10-11]
cad/out/parts/MOTOR-F25W.step
29.0 x 29.0 x 98.0 mm
