chaseyarnall173/Self-Landing-Rocket/cad/out/parts/TEENSY-41.step

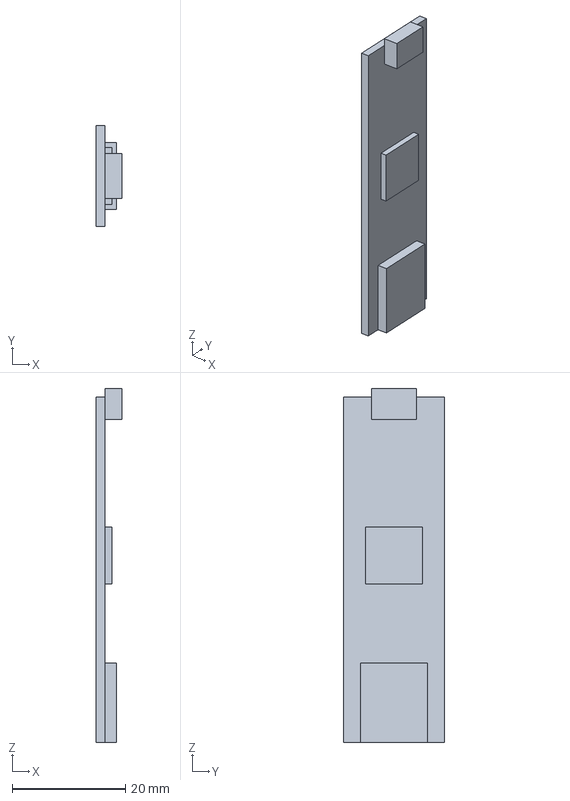
[picture p209: CAD file, 2026-10-11]
cad/out/parts/TEENSY-41.step
4.60 x 17.8 x 62.5 mm
