chaseyarnall173/Self-Landing-Rocket/cad/out/parts/HORN-PADDLE.step

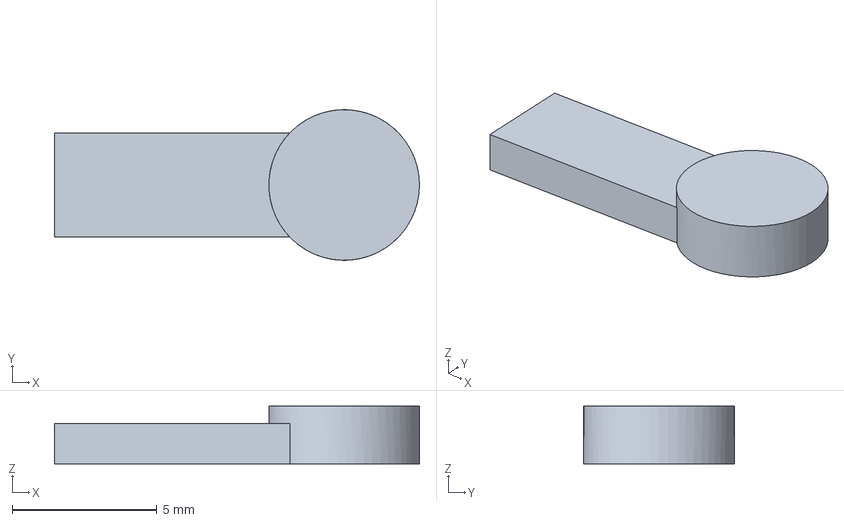
[picture p210: CAD file, 2026-10-11]
cad/out/parts/HORN-PADDLE.step
12.6 x 5.20 x 2.00 mm
