chaseyarnall173/Self-Landing-Rocket/cad/out/parts/LEG-PIN.step

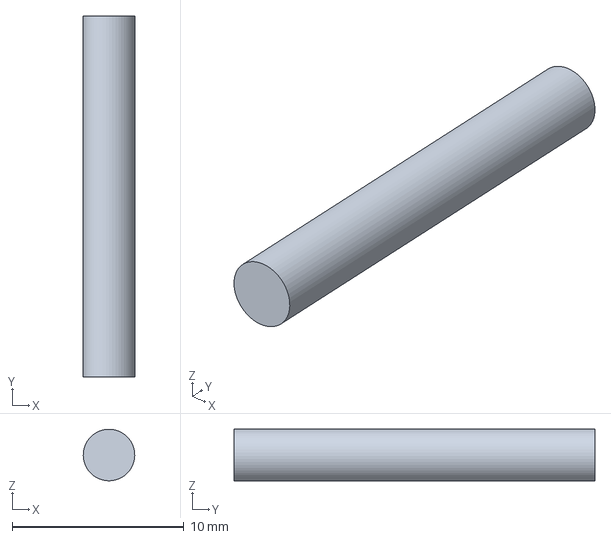
[picture p211: CAD file, 2026-10-11]
cad/out/parts/LEG-PIN.step
3.00 x 21.0 x 3.00 mm
