chaseyarnall173/Self-Landing-Rocket/cad/out/parts/CHUTE-LINK.step

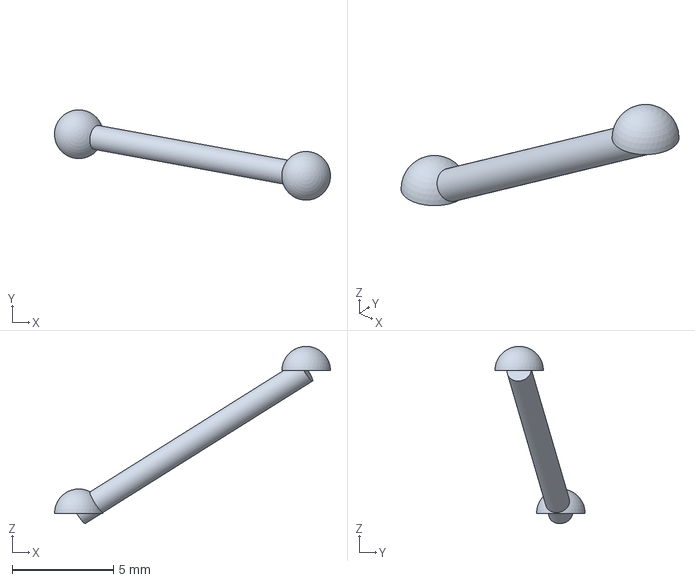
[picture p212: CAD file, 2026-10-11]
cad/out/parts/CHUTE-LINK.step
13.6 x 4.45 x 8.74 mm
