chaseyarnall173/Self-Landing-Rocket/cad/out/parts/NOSE-01.step

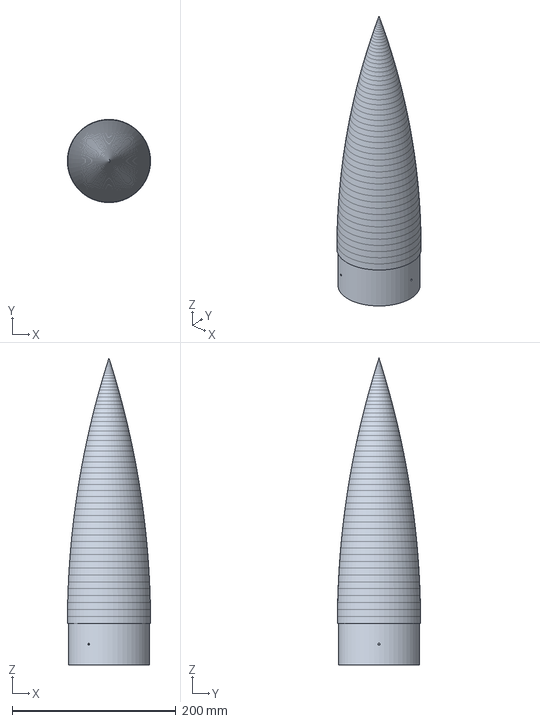
[picture p213: CAD file, 2026-10-11]
cad/out/parts/NOSE-01.step
101.5 x 101.6 x 374.7 mm
