chaseyarnall173/Self-Landing-Rocket/cad/out/parts/TUBE-04.step

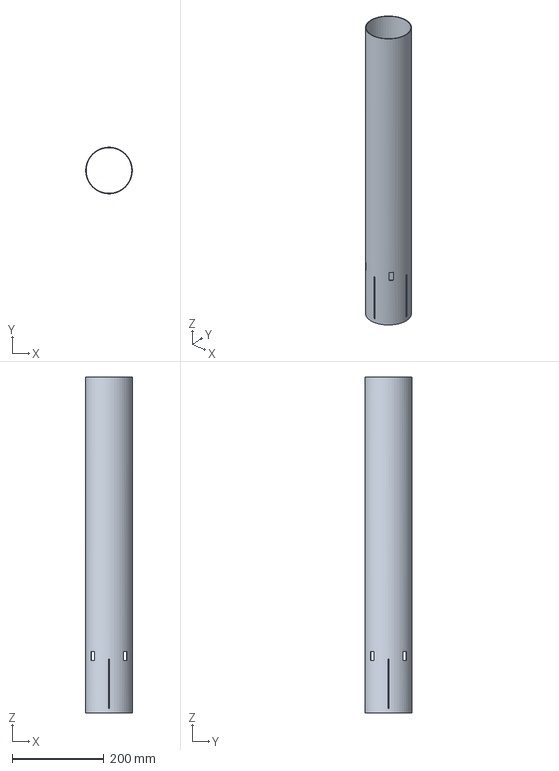
[picture p214: CAD file, 2026-10-11]
cad/out/parts/TUBE-04.step
101.6 x 101.6 x 731.0 mm
