chaseyarnall173/Self-Landing-Rocket/cad/out/parts/LORA-ANT.step

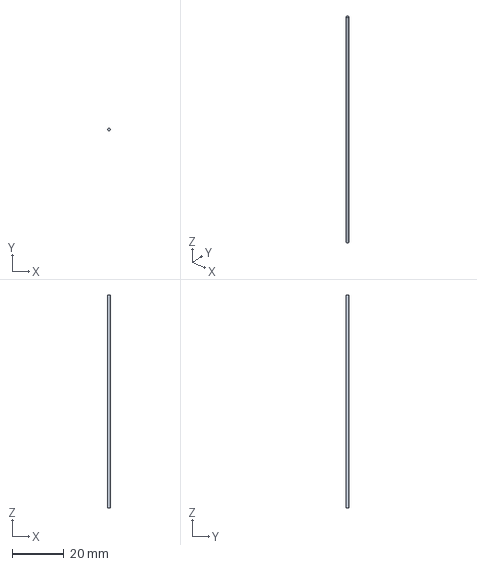
[picture p215: CAD file, 2026-10-11]
cad/out/parts/LORA-ANT.step
0.999 x 1 x 82.0 mm
