chaseyarnall173/Self-Landing-Rocket/cad/out/parts/LIDAR-BRKT.step

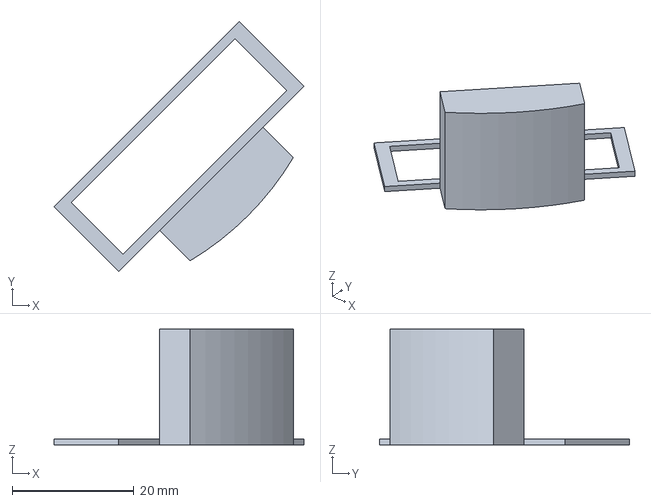
[picture p216: CAD file, 2026-10-11]
cad/out/parts/LIDAR-BRKT.step
41.0 x 41.0 x 19.0 mm
