chaseyarnall173/Self-Landing-Rocket/cad/out/parts/LEGPIN-BRKT.step

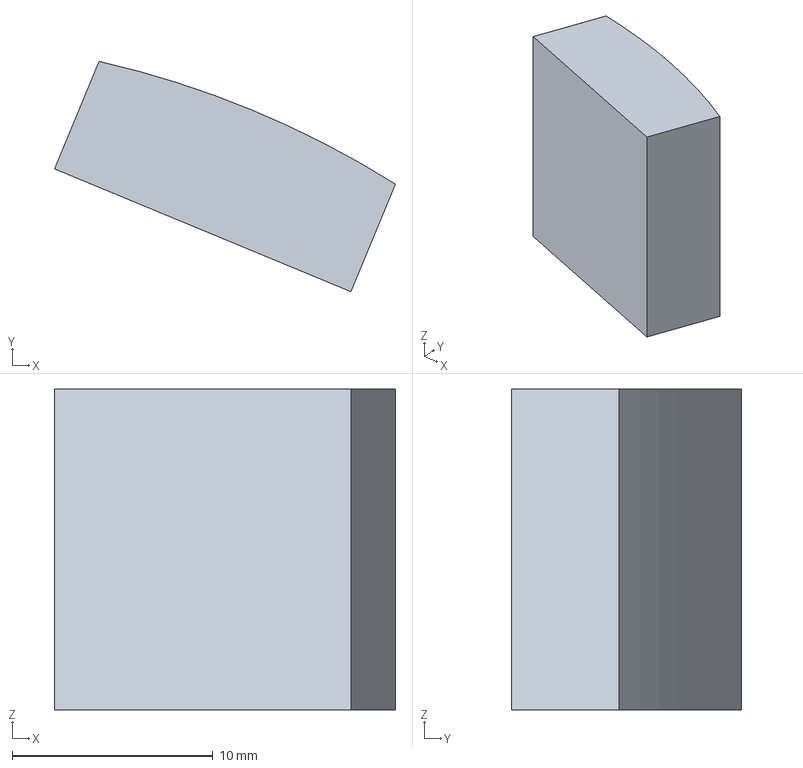
[picture p217: CAD file, 2026-10-11]
cad/out/parts/LEGPIN-BRKT.step
17.0 x 11.5 x 16.0 mm
