chaseyarnall173/Self-Landing-Rocket/cad/out/parts/SERVO-GIMBAL-A.step

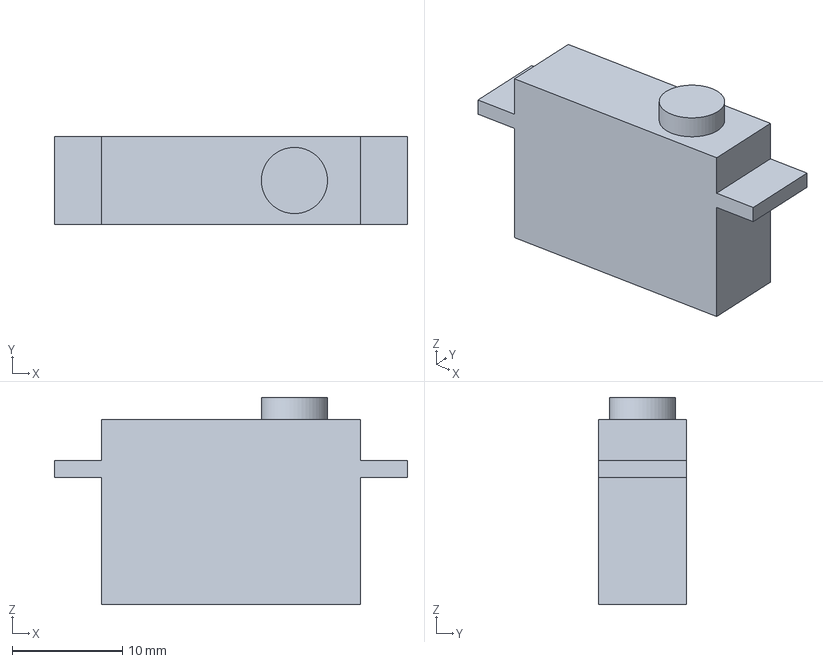
[picture p218: CAD file, 2026-10-11]
cad/out/parts/SERVO-GIMBAL-A.step
32.0 x 8.00 x 18.8 mm
