chaseyarnall173/Self-Landing-Rocket/cad/out/parts/LATCH-RING.step

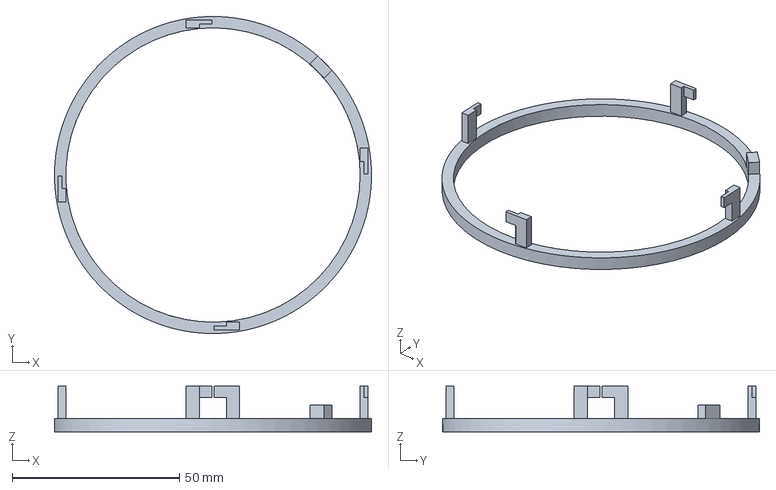
[picture p219: CAD file, 2026-10-11]
cad/out/parts/LATCH-RING.step
94.8 x 94.8 x 13.7 mm
