chaseyarnall173/Self-Landing-Rocket/cad/out/parts/IMU-BMI088.step

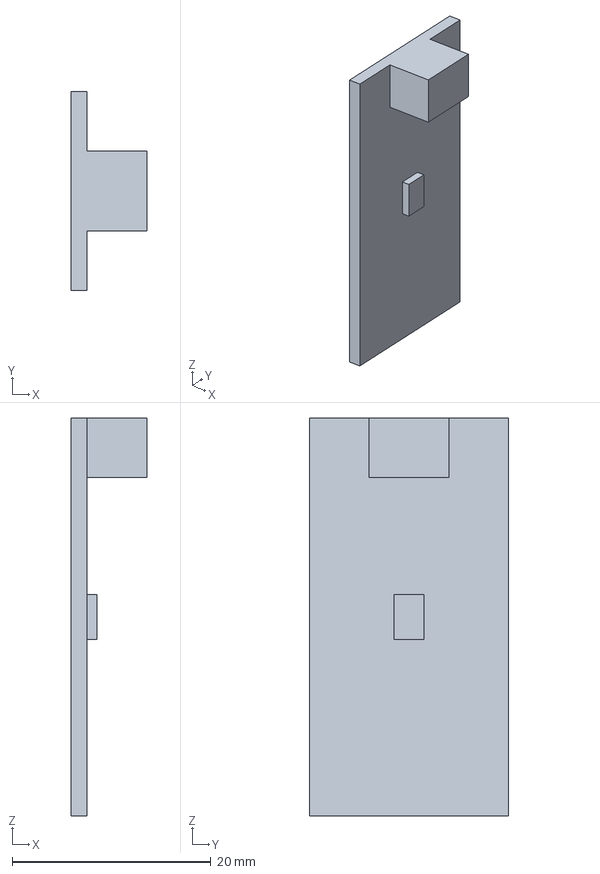
[picture p220: CAD file, 2026-10-11]
cad/out/parts/IMU-BMI088.step
7.60 x 20.0 x 40.0 mm
