chaseyarnall173/Self-Landing-Rocket/cad/out/parts/THRUST-PLATE.step

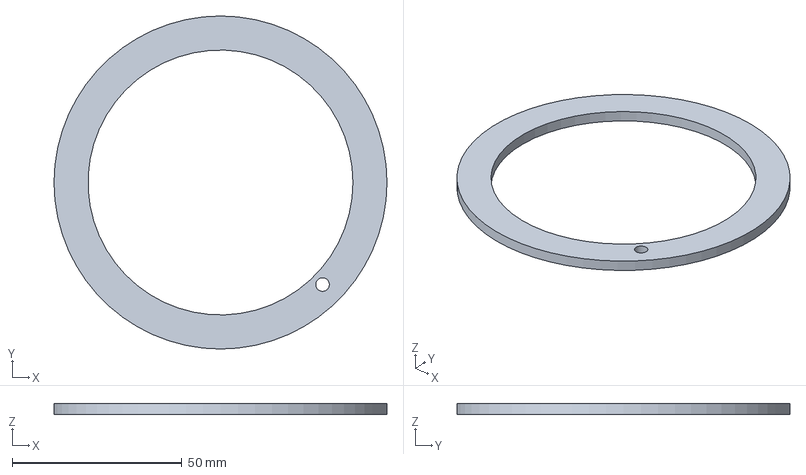
[picture p221: CAD file, 2026-10-11]
cad/out/parts/THRUST-PLATE.step
98.1 x 98.1 x 3.17 mm
