chaseyarnall173/Self-Landing-Rocket/cad/out/parts/CLIP-RET.step

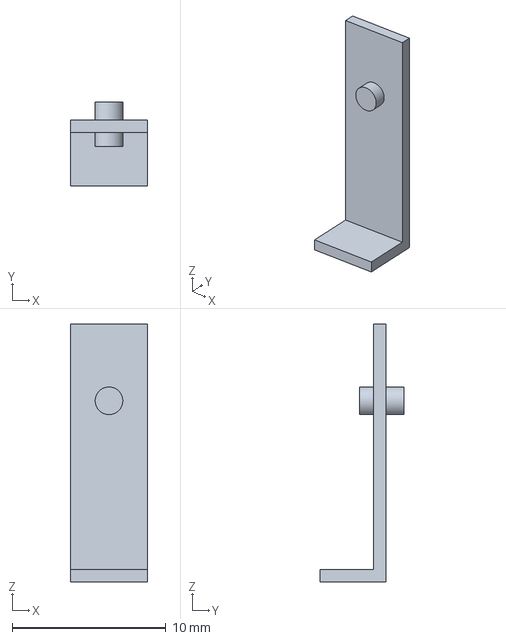
[picture p222: CAD file, 2026-10-11]
cad/out/parts/CLIP-RET.step
5.00 x 5.50 x 16.8 mm
