chaseyarnall173/Self-Landing-Rocket/cad/out/parts/LIDAR-TFMINI.step

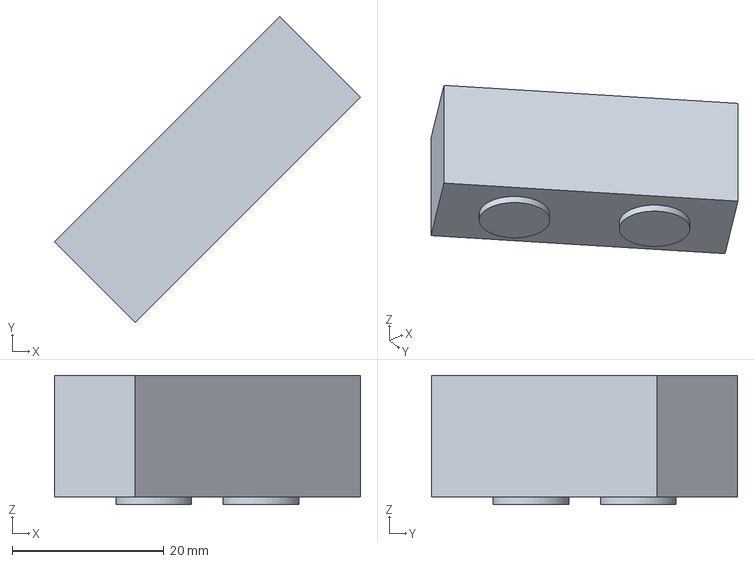
[picture p223: CAD file, 2026-10-11]
cad/out/parts/LIDAR-TFMINI.step
40.3 x 40.3 x 17.0 mm
