chaseyarnall173/Self-Landing-Rocket/cad/out/parts/FIN-FILLET.step

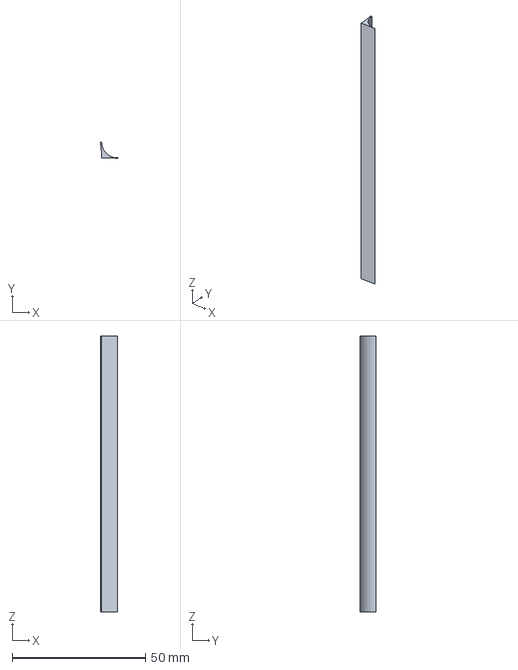
[picture p224: CAD file, 2026-10-11]
cad/out/parts/FIN-FILLET.step
6.51 x 6.00 x 103.4 mm
