chaseyarnall173/Self-Landing-Rocket/cad/out/parts/GIMBAL-INNER.step

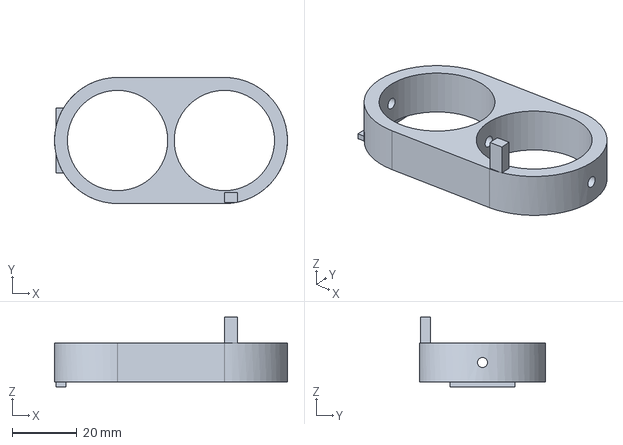
[picture p225: CAD file, 2026-10-11]
cad/out/parts/GIMBAL-INNER.step
72.0 x 39.0 x 21.5 mm
