chaseyarnall173/Self-Landing-Rocket/cad/out/parts/AV-SLED-TUBE.step

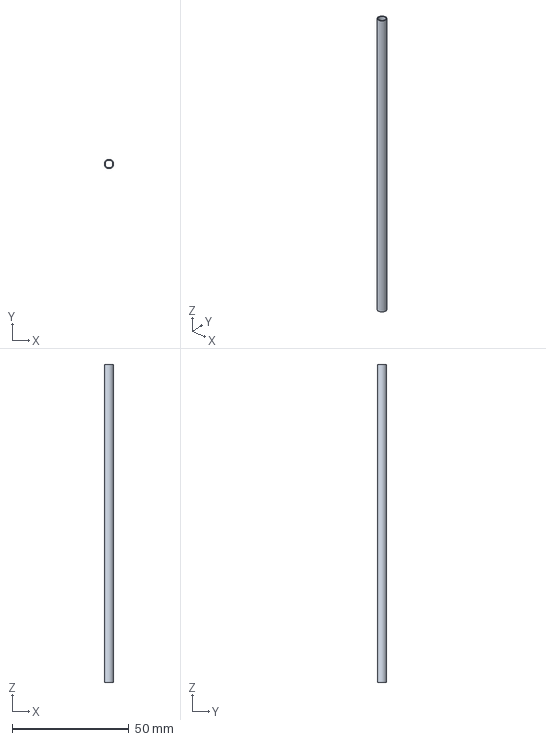
[picture p226: CAD file, 2026-10-11]
cad/out/parts/AV-SLED-TUBE.step
4.00 x 4.00 x 136.0 mm
