chaseyarnall173/Self-Landing-Rocket/cad/out/parts/ARM-KEY-SW.step

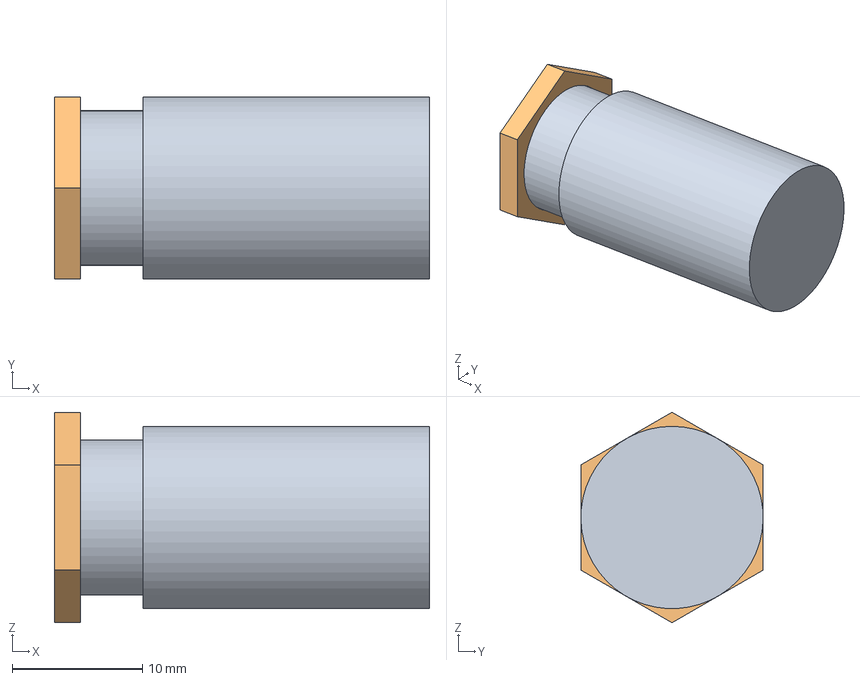
[picture p227: CAD file, 2026-10-11]
cad/out/parts/ARM-KEY-SW.step
28.8 x 14.0 x 16.2 mm
