chaseyarnall173/Self-Landing-Rocket/cad/out/parts/BUCK-5V.step

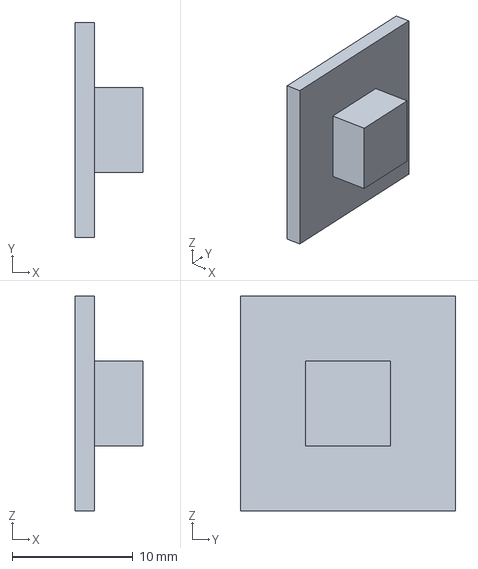
[picture p228: CAD file, 2026-10-11]
cad/out/parts/BUCK-5V.step
5.60 x 17.8 x 17.8 mm
