chaseyarnall173/Self-Landing-Rocket/cad/out/parts/PUSHROD-A.step

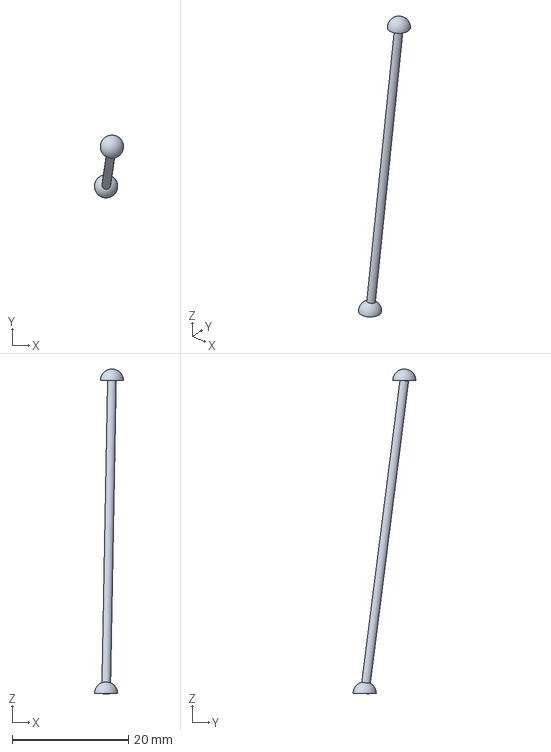
[picture p229: CAD file, 2026-10-11]
cad/out/parts/PUSHROD-A.step
5.00 x 10.8 x 55.8 mm
