chaseyarnall173/Self-Landing-Rocket/cad/out/parts/SERVO-CHUTE.step

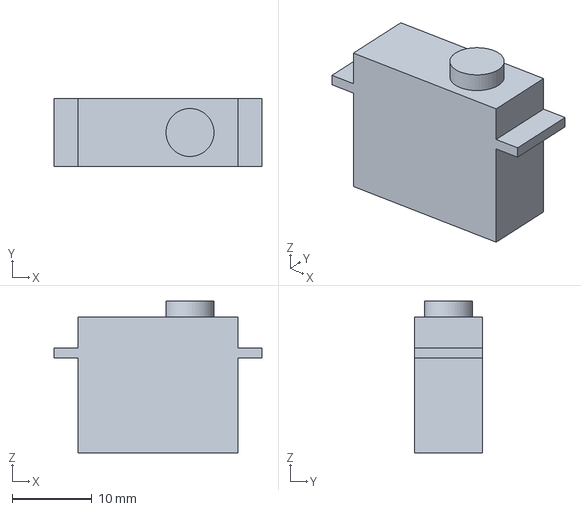
[picture p230: CAD file, 2026-10-11]
cad/out/parts/SERVO-CHUTE.step
26.0 x 8.50 x 19.0 mm
