chaseyarnall173/Self-Landing-Rocket/cad/out/parts/IGN-CONN.step

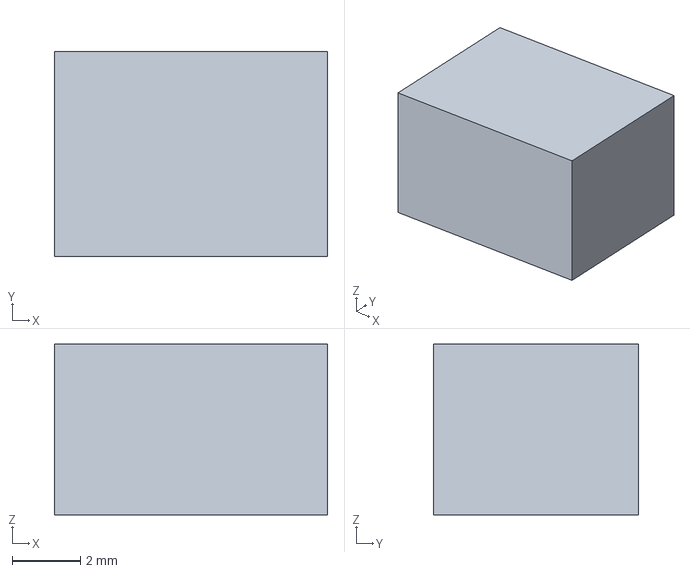
[picture p231: CAD file, 2026-10-11]
cad/out/parts/IGN-CONN.step
8.00 x 6.00 x 5.00 mm
