chaseyarnall173/Self-Landing-Rocket/cad/out/parts/SHOCK-CORD-RUN.step

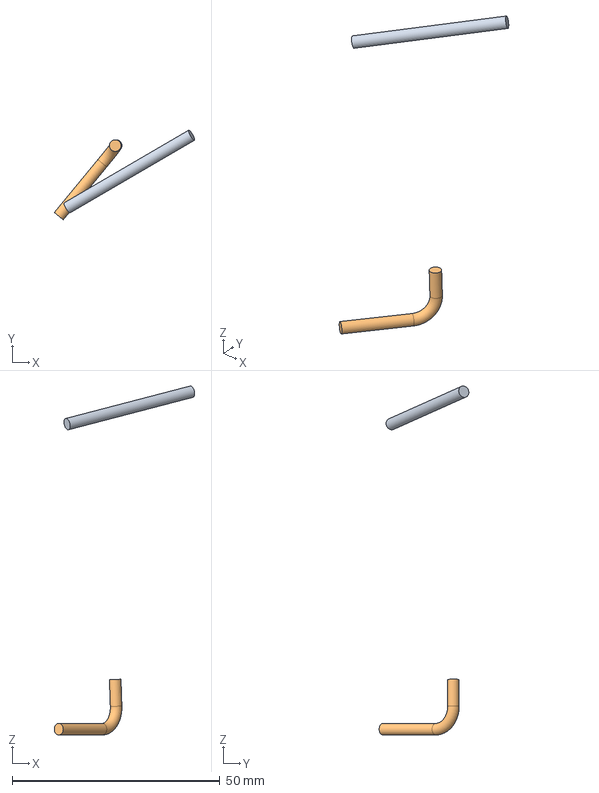
[picture p232: CAD file, 2026-10-11]
cad/out/parts/SHOCK-CORD-RUN.step
33.8 x 21.6 x 84.1 mm
