chaseyarnall173/Self-Landing-Rocket/cad/out/parts/PADDLE-BRKT.step

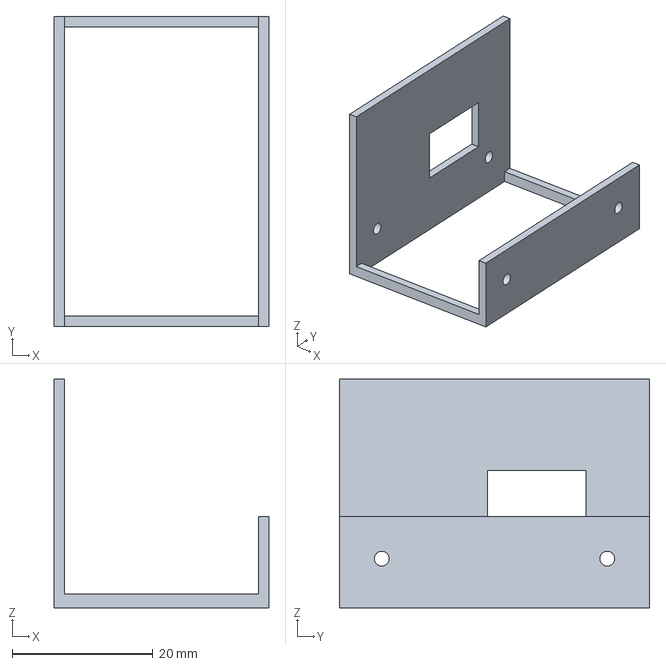
[picture p233: CAD file, 2026-10-11]
cad/out/parts/PADDLE-BRKT.step
30.5 x 44.0 x 32.5 mm
