chaseyarnall173/Self-Landing-Rocket/cad/out/parts/CHUTE-30.step

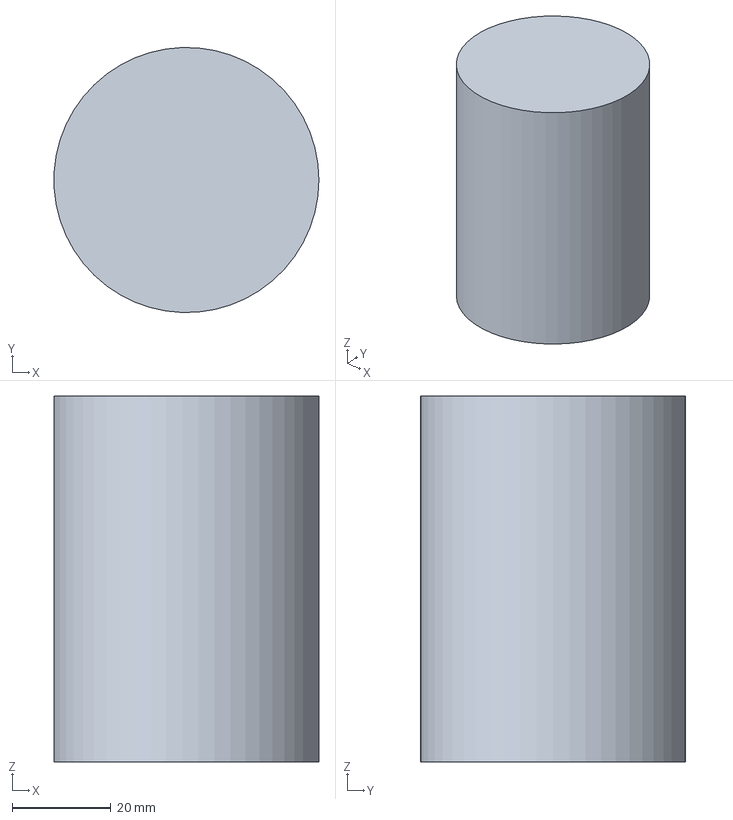
[picture p234: CAD file, 2026-10-11]
cad/out/parts/CHUTE-30.step
53.5 x 53.6 x 74.0 mm
