chaseyarnall173/Self-Landing-Rocket/cad/out/parts/LIDAR-WINDOW.step

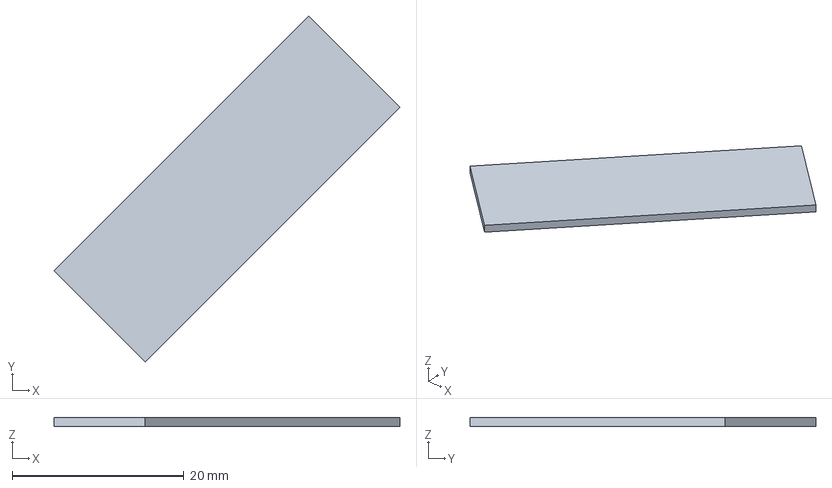
[picture p235: CAD file, 2026-10-11]
cad/out/parts/LIDAR-WINDOW.step
40.3 x 40.3 x 1.00 mm
