chaseyarnall173/Self-Landing-Rocket/cad/out/parts/LORA-RFM95W.step

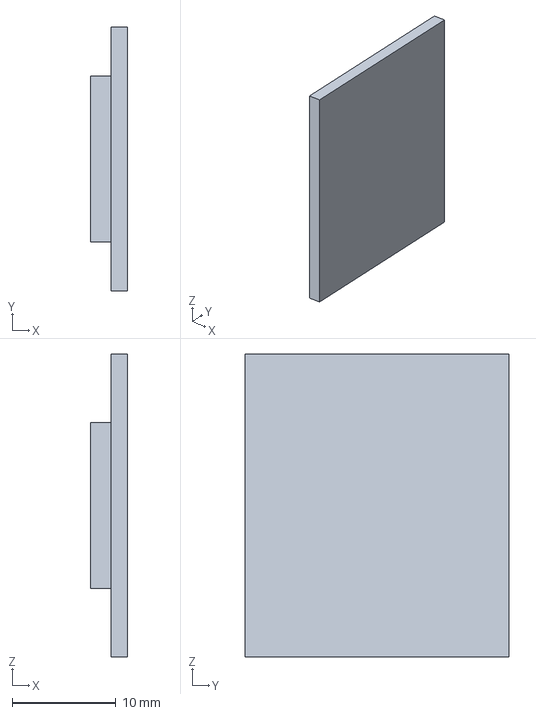
[picture p236: CAD file, 2026-10-11]
cad/out/parts/LORA-RFM95W.step
3.60 x 25.4 x 29.2 mm
