chaseyarnall173/Self-Landing-Rocket/cad/out/parts/THRUST-PLATE-AL.step

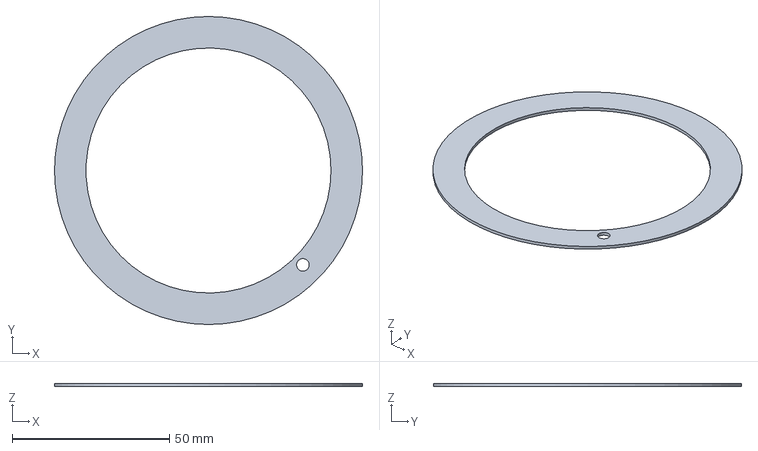
[picture p237: CAD file, 2026-10-11]
cad/out/parts/THRUST-PLATE-AL.step
98.1 x 98.1 x 1.00 mm
