chaseyarnall173/Self-Landing-Rocket/cad/out/parts/EJECT-CUP.step

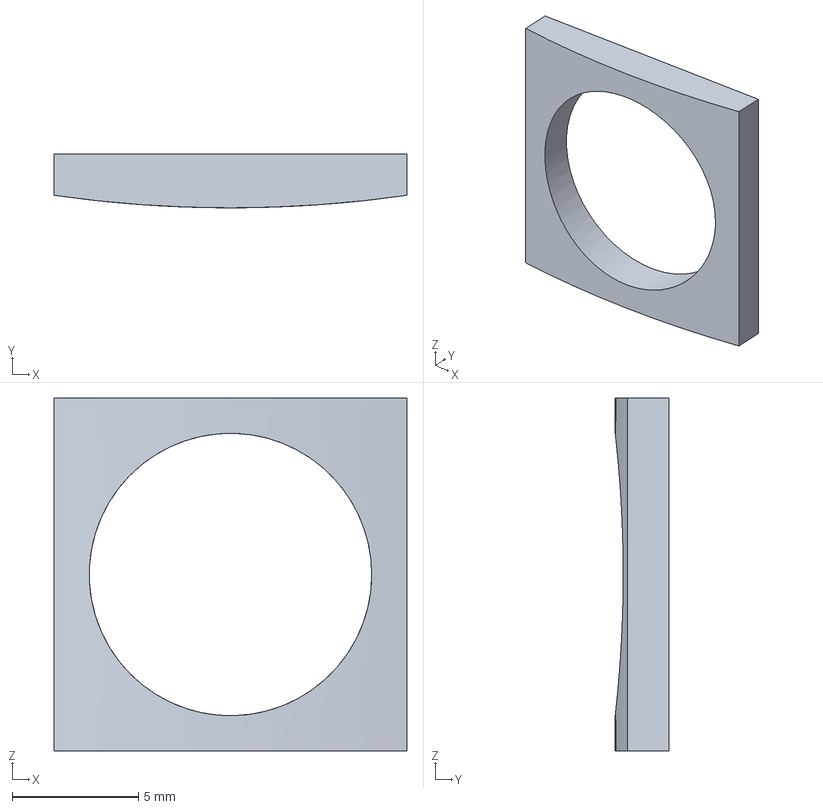
[picture p238: CAD file, 2026-10-11]
cad/out/parts/EJECT-CUP.step
14.0 x 2.13 x 14.0 mm
