chaseyarnall173/Self-Landing-Rocket/cad/out/parts/PETAL-SPRING.step

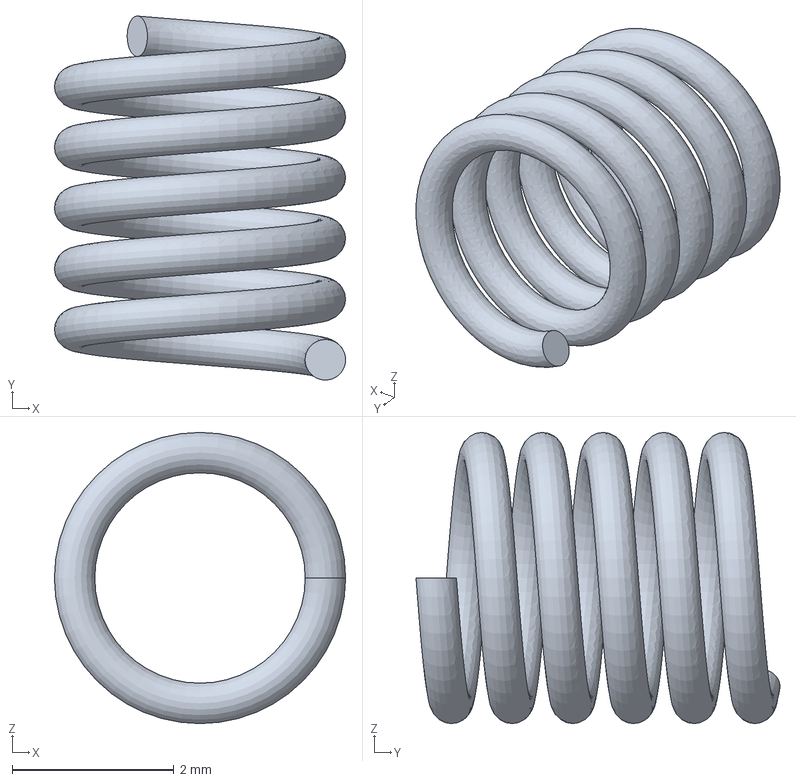
[picture p239: CAD file, 2026-10-11]
cad/out/parts/PETAL-SPRING.step
3.60 x 4.50 x 3.60 mm
