chaseyarnall173/Self-Landing-Rocket/cad/out/parts/GPS-PATCH.step

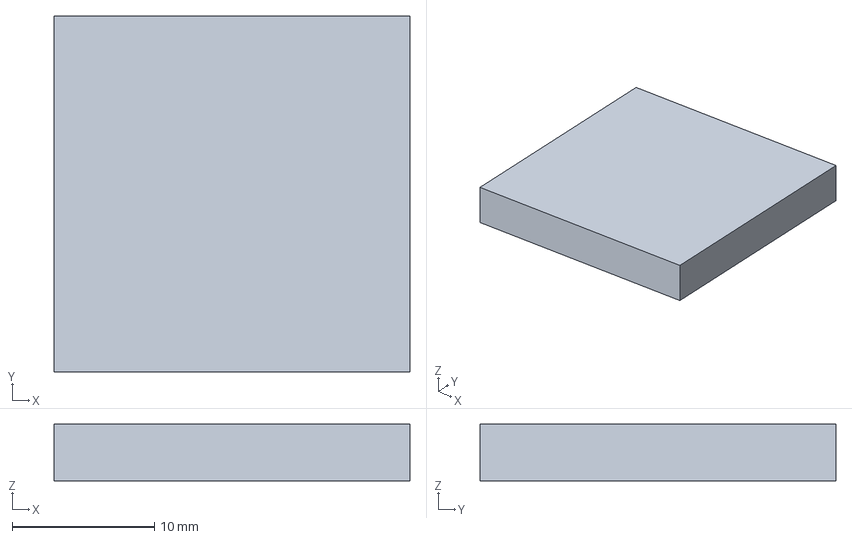
[picture p240: CAD file, 2026-10-11]
cad/out/parts/GPS-PATCH.step
25.0 x 25.0 x 4.00 mm
