chaseyarnall173/Self-Landing-Rocket/cad/out/parts/PIN-X.step

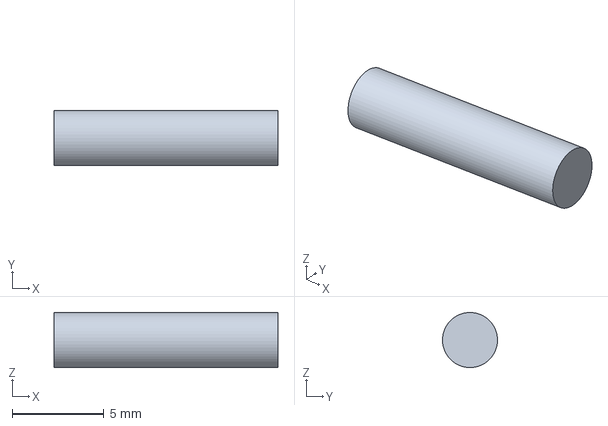
[picture p241: CAD file, 2026-10-11]
cad/out/parts/PIN-X.step
12.2 x 3.00 x 3.00 mm
