chaseyarnall173/Self-Landing-Rocket/cad/out/parts/PETAL-PIN.step

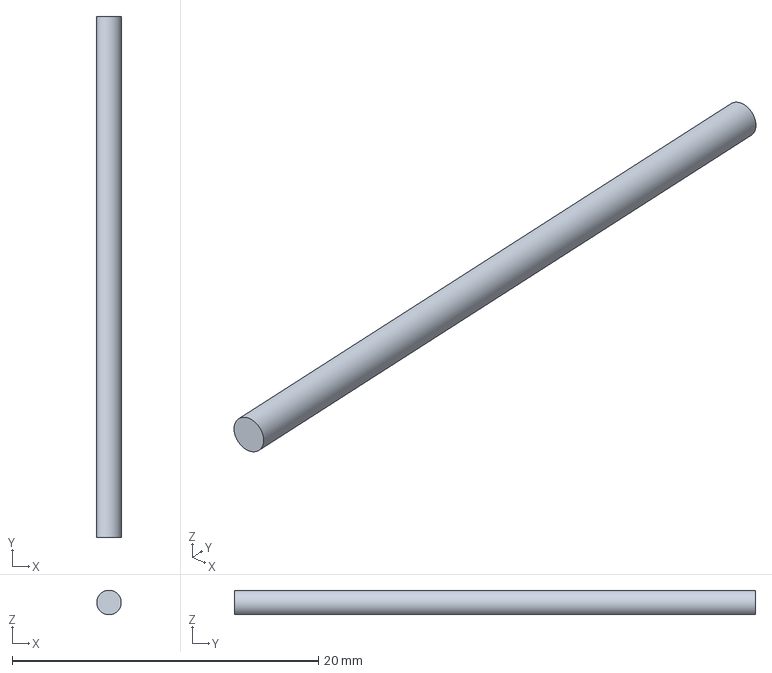
[picture p242: CAD file, 2026-10-11]
cad/out/parts/PETAL-PIN.step
1.60 x 34.0 x 1.60 mm
