chaseyarnall173/Self-Landing-Rocket/cad/out/parts/PADDLE-R.step

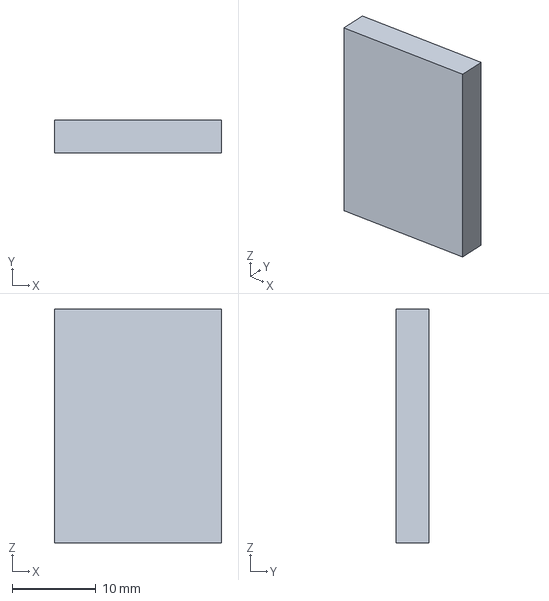
[picture p243: CAD file, 2026-10-11]
cad/out/parts/PADDLE-R.step
20.0 x 4.00 x 28.0 mm
