chaseyarnall173/Self-Landing-Rocket/cad/out/parts/PETAL-HINGE-F.step

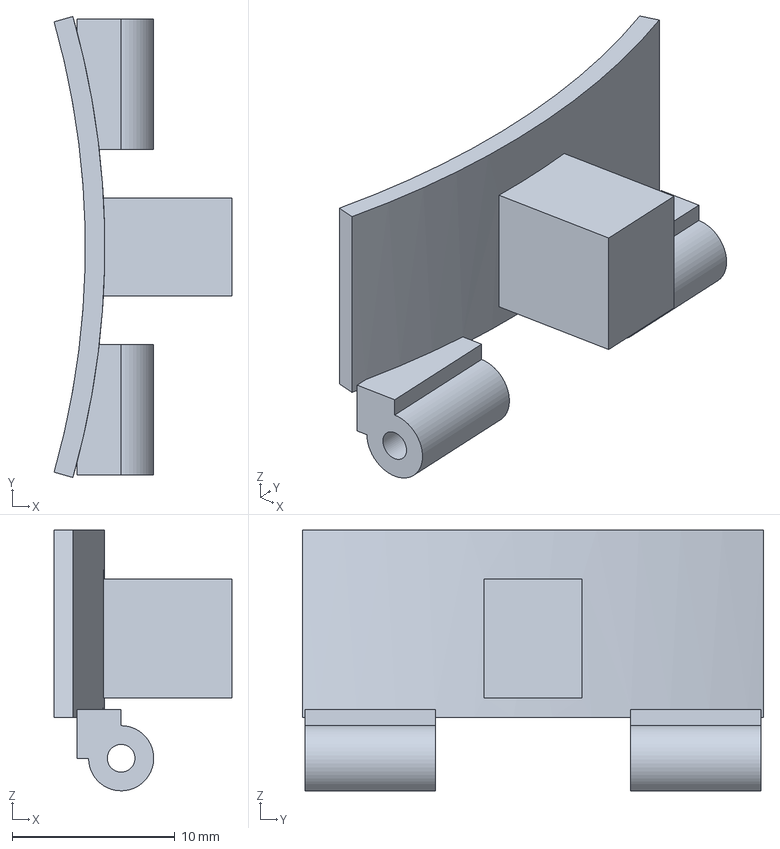
[picture p244: CAD file, 2026-10-11]
cad/out/parts/PETAL-HINGE-F.step
10.9 x 28.3 x 16.0 mm
