chaseyarnall173/Self-Landing-Rocket/cad/out/parts/HEAT-SHIELD.step

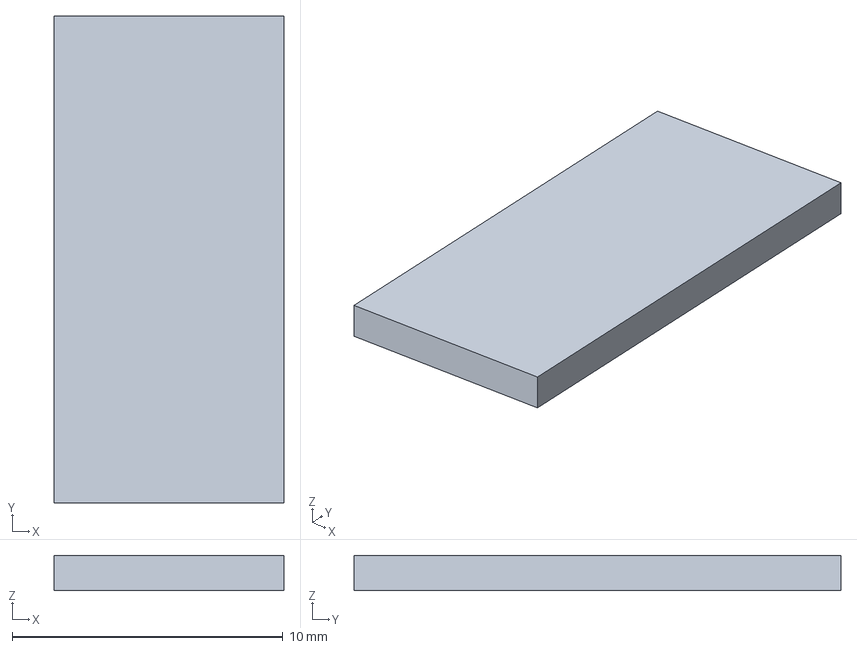
[picture p245: CAD file, 2026-10-11]
cad/out/parts/HEAT-SHIELD.step
8.50 x 18.0 x 1.30 mm
