chaseyarnall173/Self-Landing-Rocket/cad/out/parts/LATCH-LINK.step

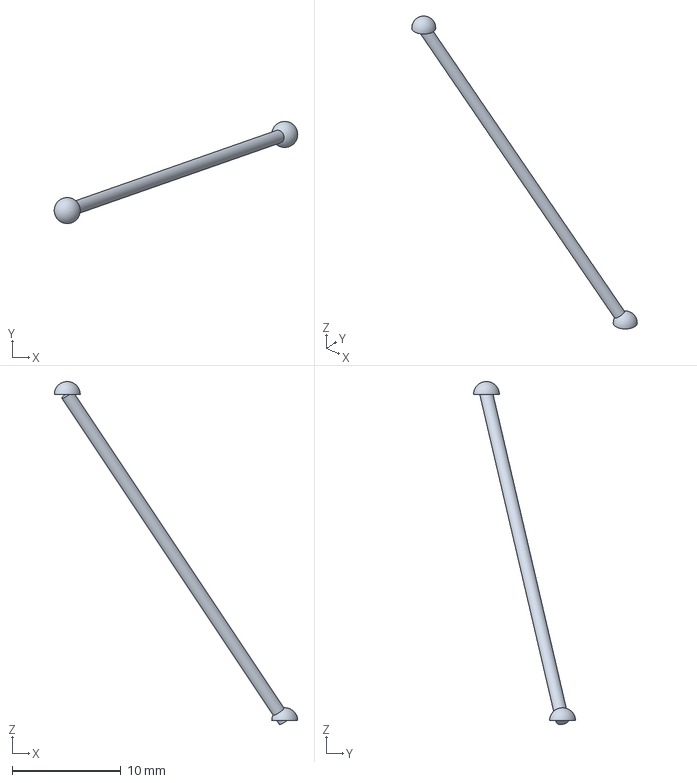
[picture p246: CAD file, 2026-10-11]
cad/out/parts/LATCH-LINK.step
22.4 x 9.40 x 31.5 mm
