chaseyarnall173/Self-Landing-Rocket/cad/out/parts/F25W-SPACER.step

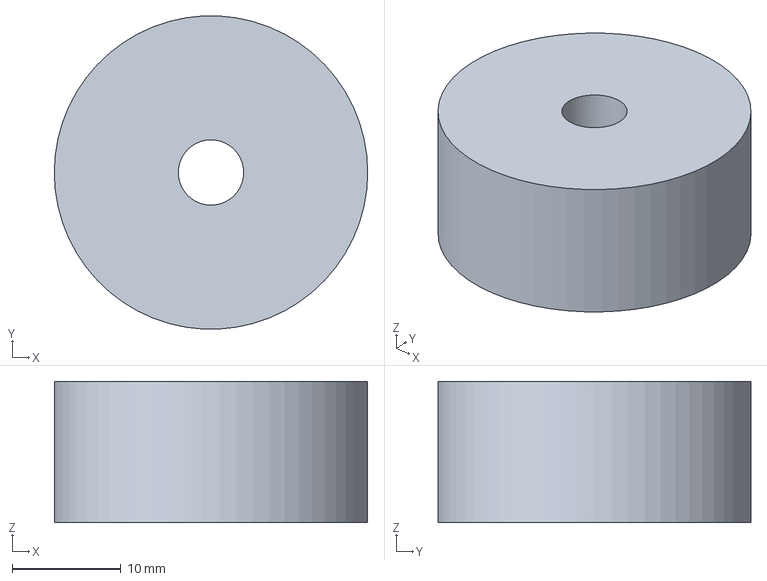
[picture p247: CAD file, 2026-10-11]
cad/out/parts/F25W-SPACER.step
28.8 x 28.8 x 13.0 mm
