chaseyarnall173/Self-Landing-Rocket/cad/out/parts/AV-SLED.step

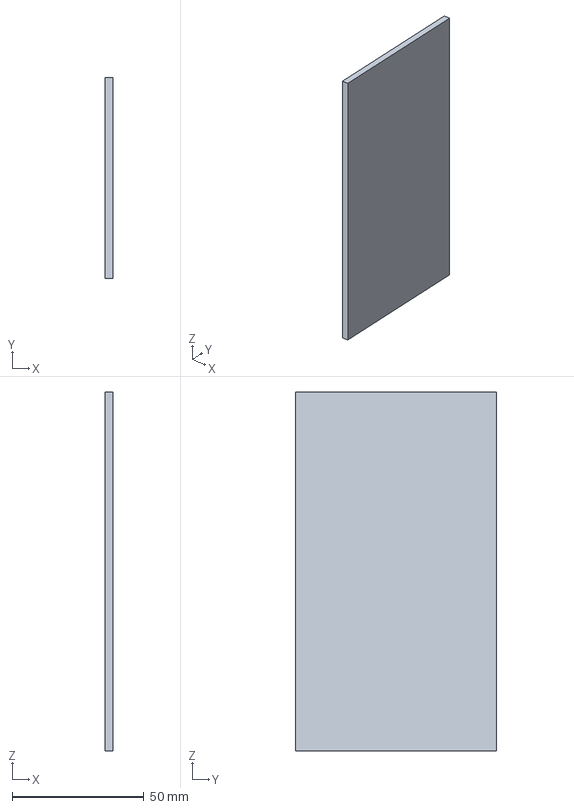
[picture p248: CAD file, 2026-10-11]
cad/out/parts/AV-SLED.step
3.17 x 76.0 x 136.0 mm
