chaseyarnall173/Self-Landing-Rocket/cad/out/parts/MOTOR-F52C.step

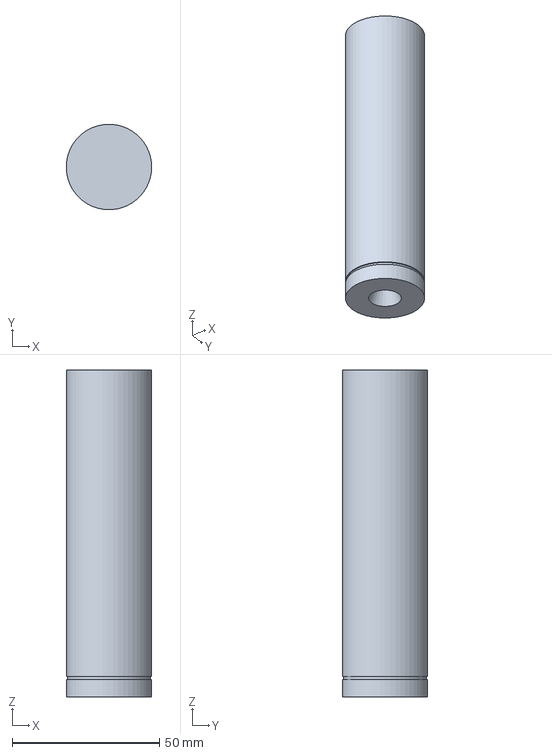
[picture p249: CAD file, 2026-10-11]
cad/out/parts/MOTOR-F52C.step
29.0 x 29.0 x 111.0 mm
