chaseyarnall173/Self-Landing-Rocket/cad/out/parts/PADDLE-XHEAD.step

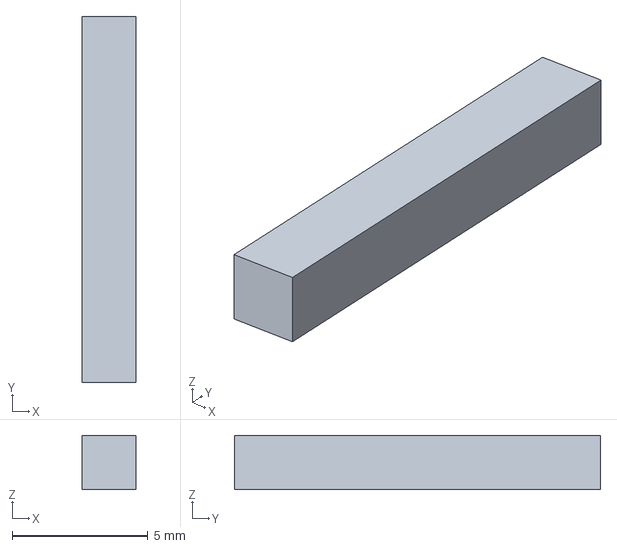
[picture p250: CAD file, 2026-10-11]
cad/out/parts/PADDLE-XHEAD.step
2.00 x 13.5 x 2.00 mm
