chaseyarnall173/Self-Landing-Rocket/cad/out/parts/LEG-PLUNGER.step

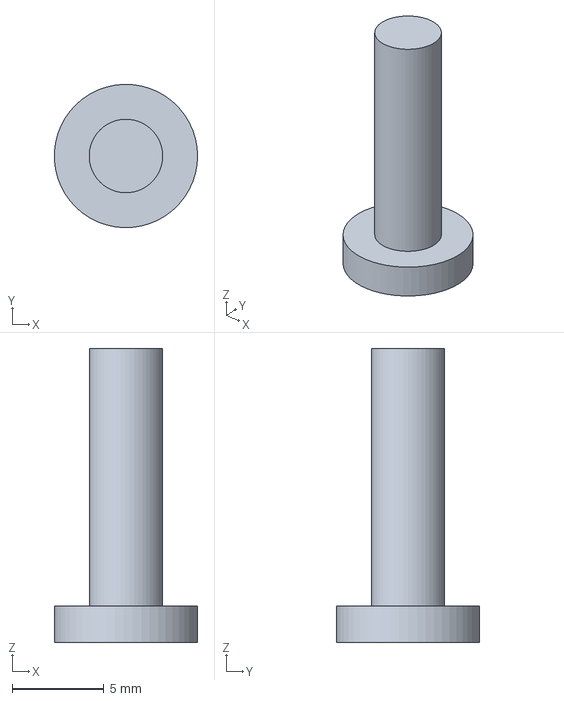
[picture p251: CAD file, 2026-10-11]
cad/out/parts/LEG-PLUNGER.step
7.79 x 7.80 x 16.0 mm
