chaseyarnall173/Self-Landing-Rocket/cad/out/parts/CHUTE-SERVO-BRKT.step

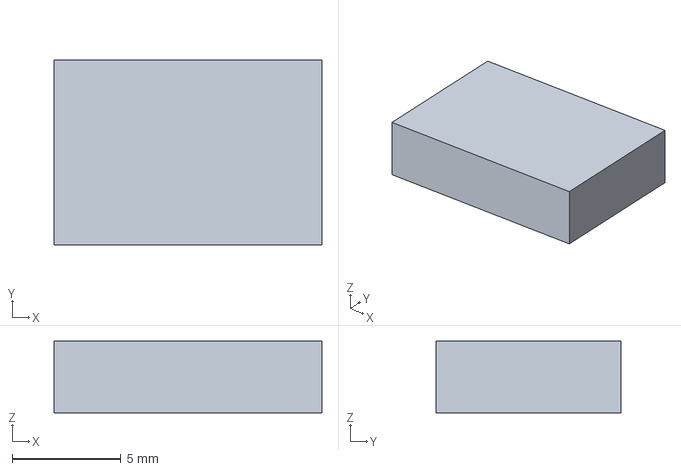
[picture p252: CAD file, 2026-10-11]
cad/out/parts/CHUTE-SERVO-BRKT.step
12.3 x 8.50 x 3.30 mm
