chaseyarnall173/Self-Landing-Rocket/cad/out/parts/LEG-CLEVIS.step

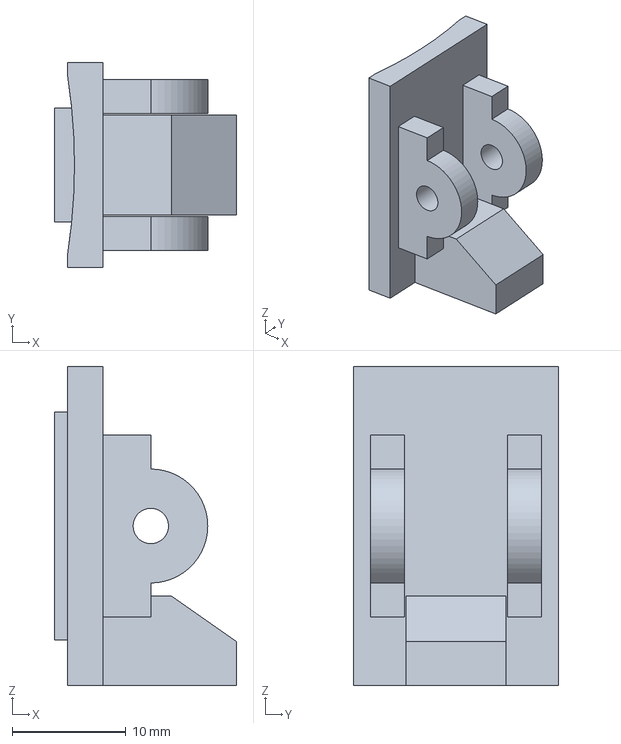
[picture p253: CAD file, 2026-10-11]
cad/out/parts/LEG-CLEVIS.step
16.0 x 18.0 x 28.0 mm
