chaseyarnall173/Self-Landing-Rocket/cad/out/parts/CPL-01.step

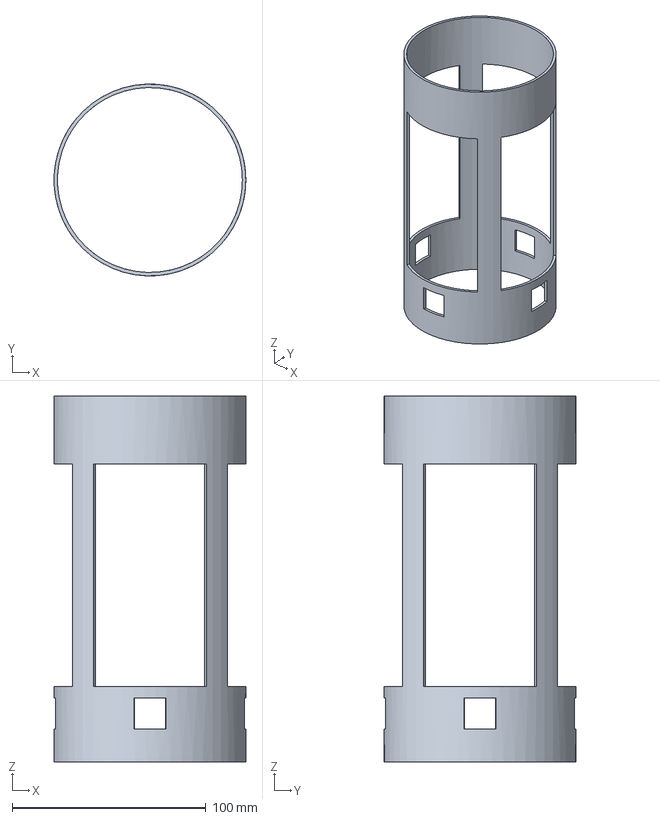
[picture p254: CAD file, 2026-10-11]
cad/out/parts/CPL-01.step
99.0 x 99.0 x 189.0 mm
