chaseyarnall173/Self-Landing-Rocket/cad/out/parts/PADDLE-LINK-L.step

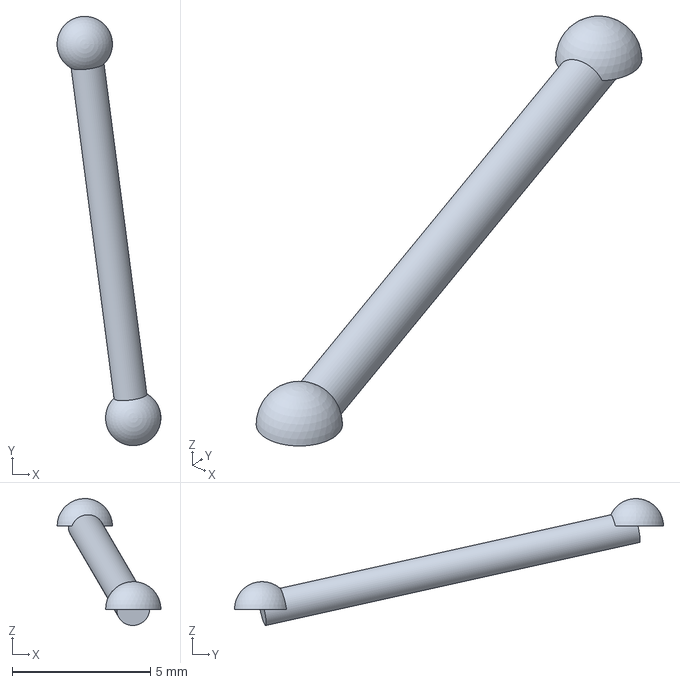
[picture p255: CAD file, 2026-10-11]
cad/out/parts/PADDLE-LINK-L.step
3.75 x 15.5 x 4.59 mm
