chaseyarnall173/Self-Landing-Rocket/cad/out/parts/LEG-LOOP.step

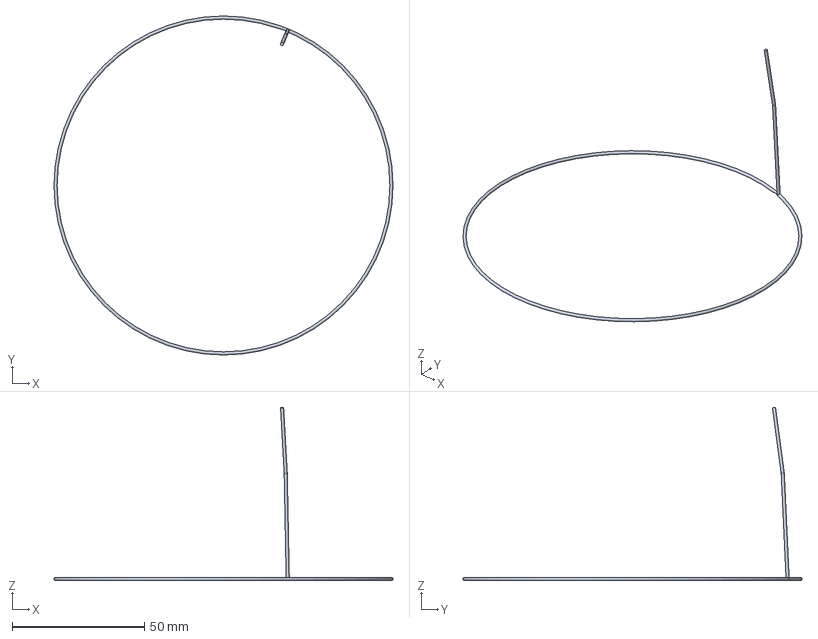
[picture p256: CAD file, 2026-10-11]
cad/out/parts/LEG-LOOP.step
128.4 x 128.4 x 65.6 mm
