chaseyarnall173/Self-Landing-Rocket/cad/out/parts/LEG-DOUBLER.step

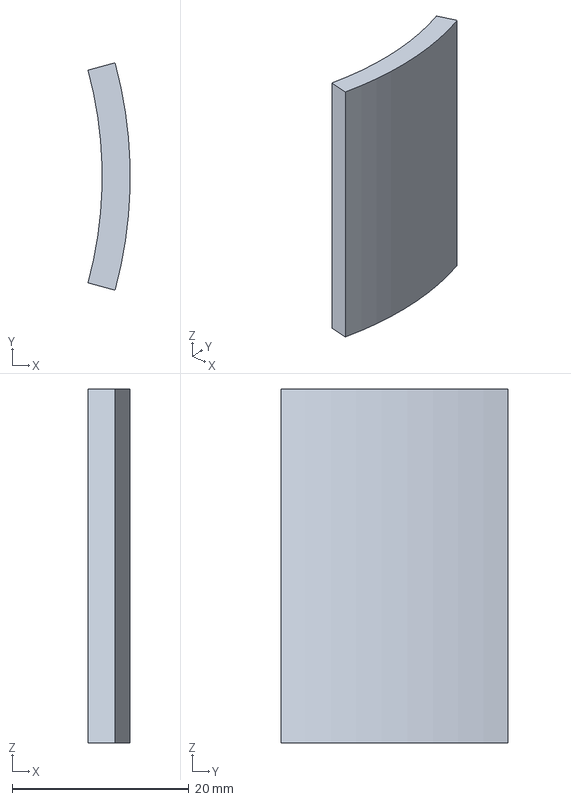
[picture p257: CAD file, 2026-10-11]
cad/out/parts/LEG-DOUBLER.step
4.76 x 25.7 x 40.0 mm
