chaseyarnall173/Self-Landing-Rocket/cad/out/parts/LEG-STRUT.step

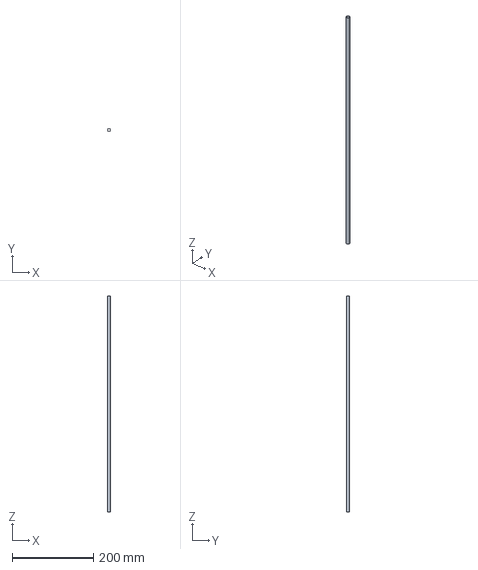
[picture p258: CAD file, 2026-10-11]
cad/out/parts/LEG-STRUT.step
7.99 x 8.00 x 532.1 mm
