chaseyarnall173/Self-Landing-Rocket/cad/out/parts/CAP-1000U.step

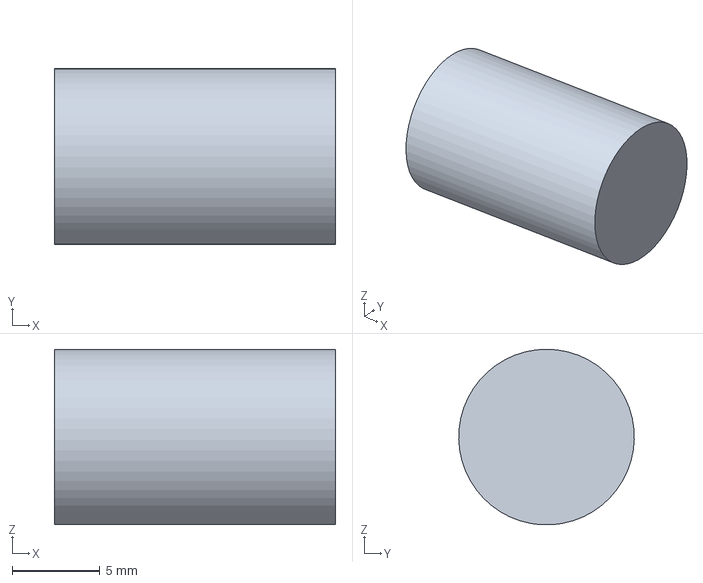
[picture p259: CAD file, 2026-10-11]
cad/out/parts/CAP-1000U.step
16.0 x 10.00 x 9.99 mm
