chaseyarnall173/Self-Landing-Rocket/cad/out/parts/CPL-02.step

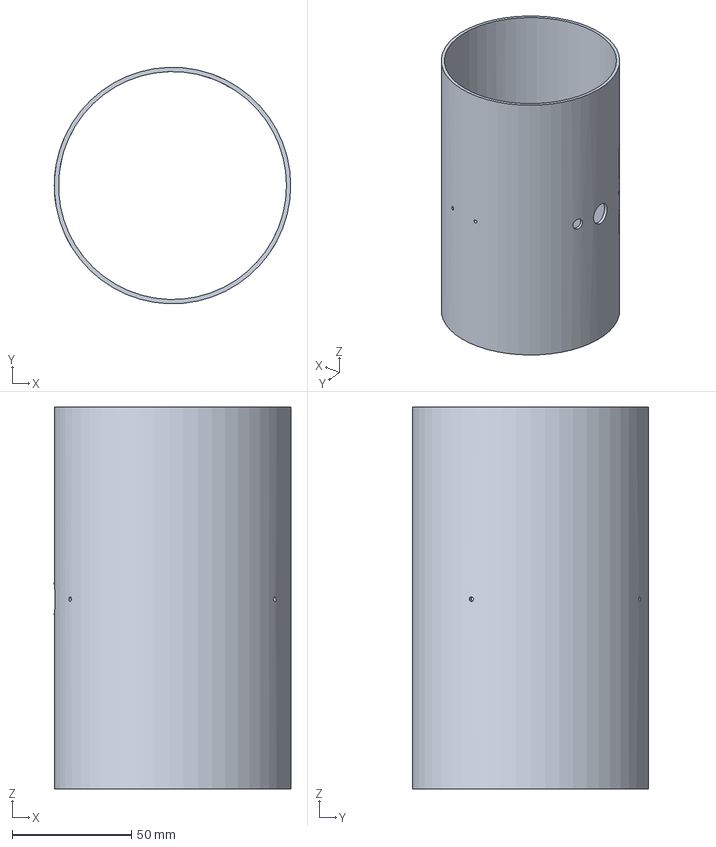
[picture p260: CAD file, 2026-10-11]
cad/out/parts/CPL-02.step
99.1 x 99.0 x 160.0 mm
