chaseyarnall173/Self-Landing-Rocket/cad/out/parts/LINER-AFT.step

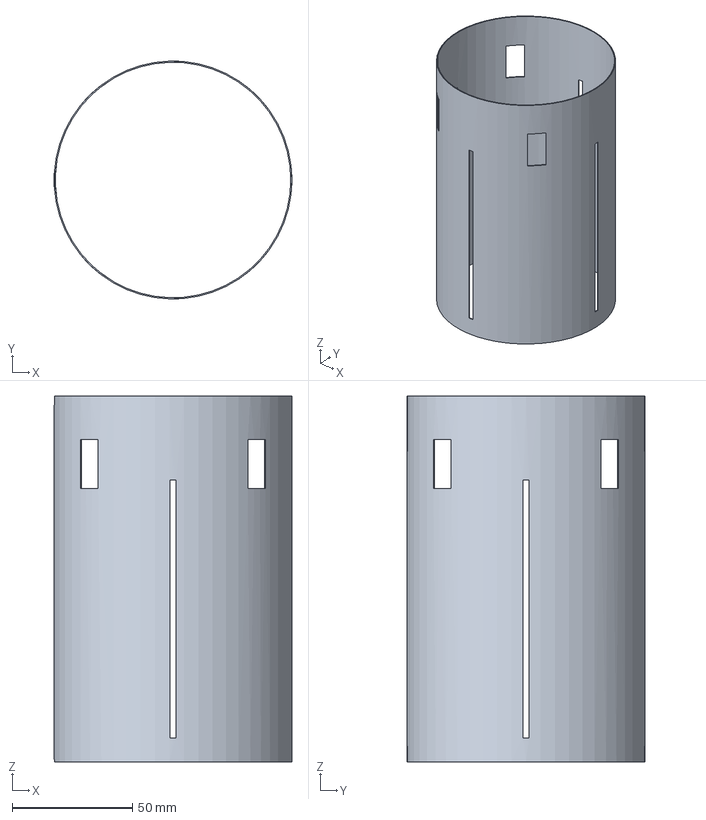
[picture p261: CAD file, 2026-10-11]
cad/out/parts/LINER-AFT.step
99.1 x 99.1 x 152.4 mm
