chaseyarnall173/Self-Landing-Rocket/cad/out/parts/PETAL-01.step

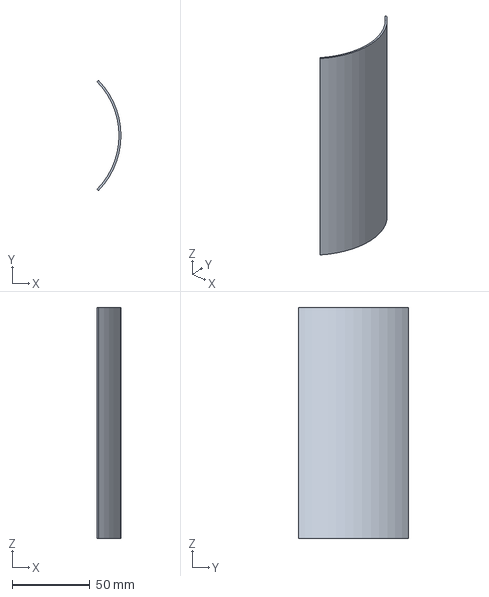
[picture p262: CAD file, 2026-10-11]
cad/out/parts/PETAL-01.step
15.4 x 71.1 x 149.0 mm
