chaseyarnall173/Self-Landing-Rocket/cad/out/parts/FET-AO3400.step

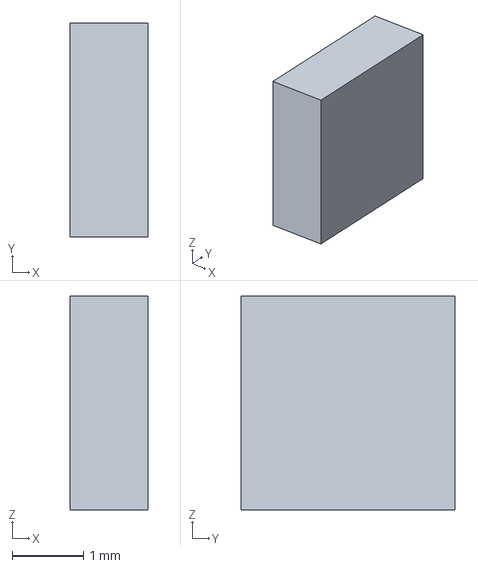
[picture p263: CAD file, 2026-10-11]
cad/out/parts/FET-AO3400.step
1.10 x 3.00 x 3.00 mm
