chaseyarnall173/Self-Landing-Rocket/cad/out/parts/CABLE-LIDAR.step

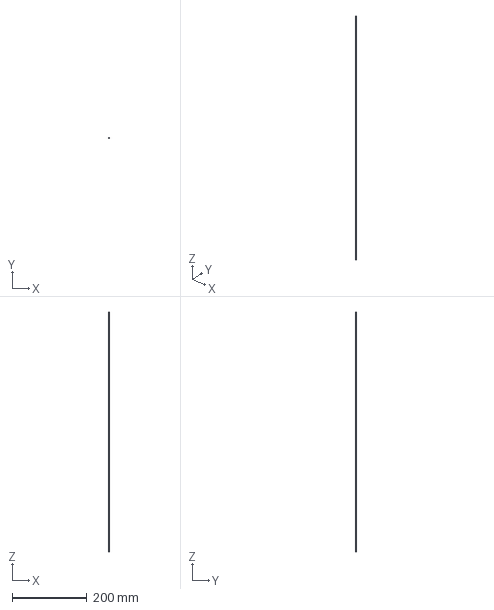
[picture p264: CAD file, 2026-10-11]
cad/out/parts/CABLE-LIDAR.step
3.00 x 3.00 x 640.0 mm
