chaseyarnall173/Self-Landing-Rocket/cad/out/parts/DOOR-HINGE-M.step

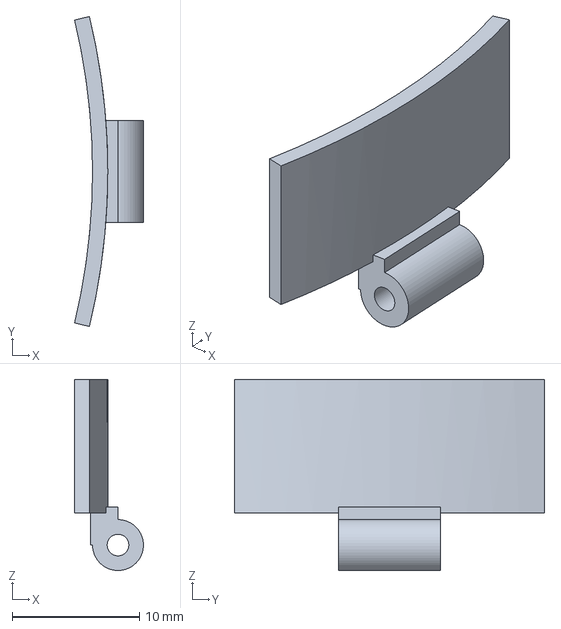
[picture p265: CAD file, 2026-10-11]
cad/out/parts/DOOR-HINGE-M.step
5.41 x 24.3 x 15.0 mm
