chaseyarnall173/Self-Landing-Rocket/cad/out/parts/GIMBAL-MIDDLE.step

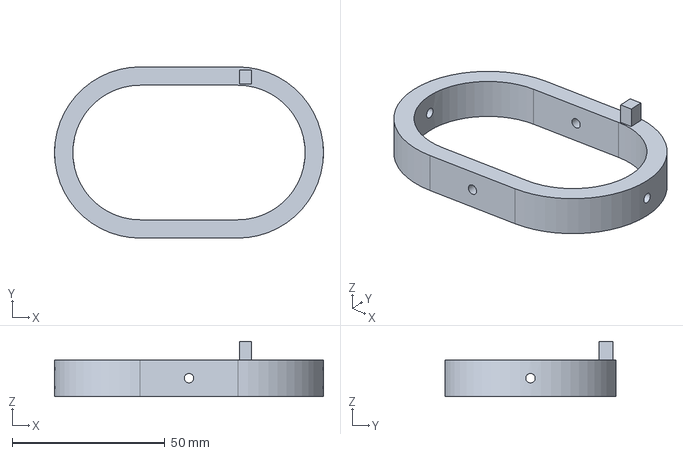
[picture p266: CAD file, 2026-10-11]
cad/out/parts/GIMBAL-MIDDLE.step
88.0 x 56.0 x 18.0 mm
