chaseyarnall173/Self-Landing-Rocket/cad/out/parts/PADDLE-SERVO-LINK.step

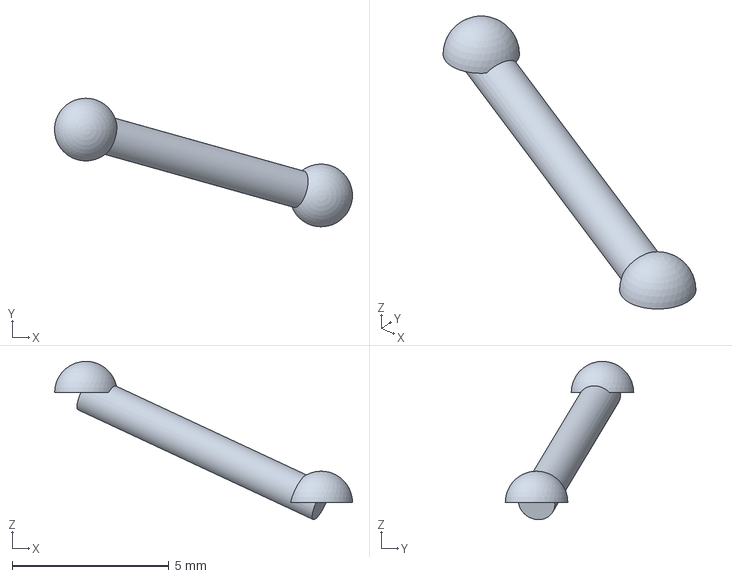
[picture p267: CAD file, 2026-10-11]
cad/out/parts/PADDLE-SERVO-LINK.step
9.50 x 4.10 x 5.05 mm
