chaseyarnall173/Self-Landing-Rocket/cad/out/parts/PIN-Y.step

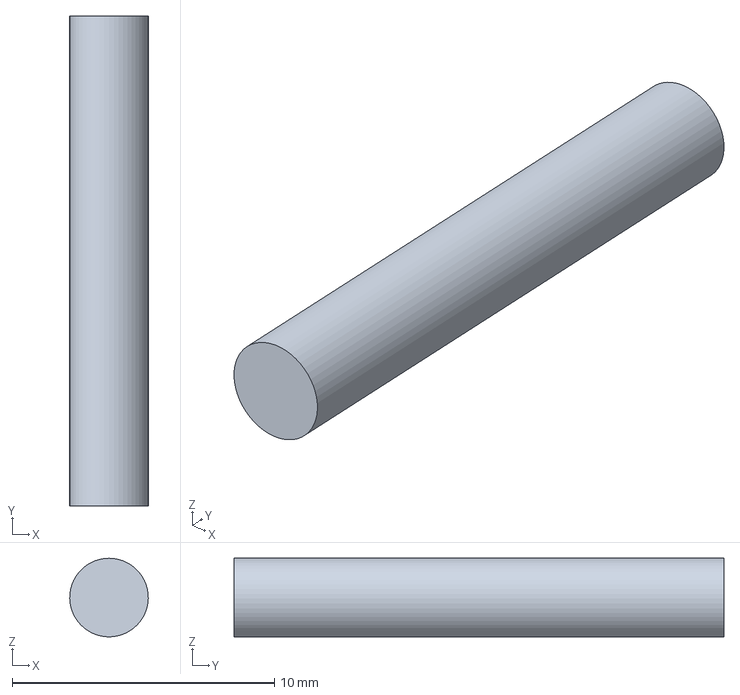
[picture p268: CAD file, 2026-10-11]
cad/out/parts/PIN-Y.step
3.00 x 18.7 x 3.00 mm
