chaseyarnall173/Self-Landing-Rocket/cad/out/parts/PETAL-TAB.step

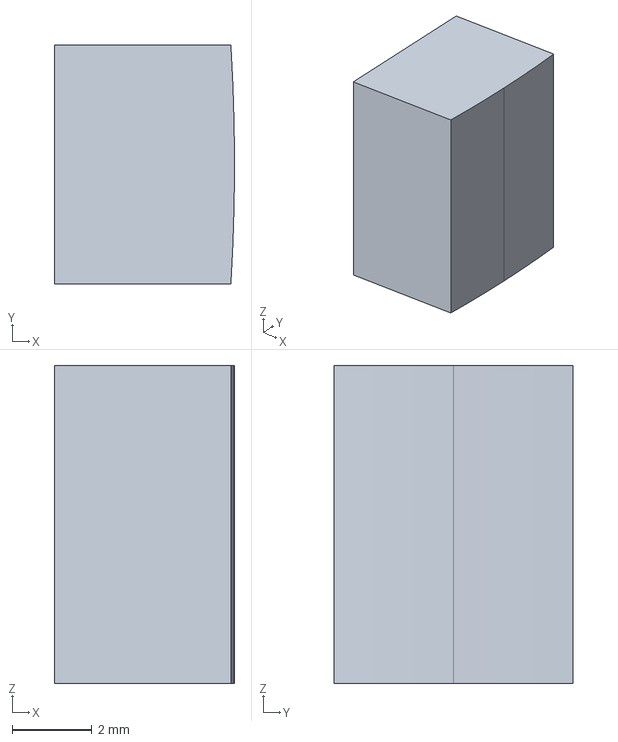
[picture p269: CAD file, 2026-10-11]
cad/out/parts/PETAL-TAB.step
4.53 x 6.00 x 8.00 mm
