chaseyarnall173/Self-Landing-Rocket/cad/out/parts/DOOR-01.step

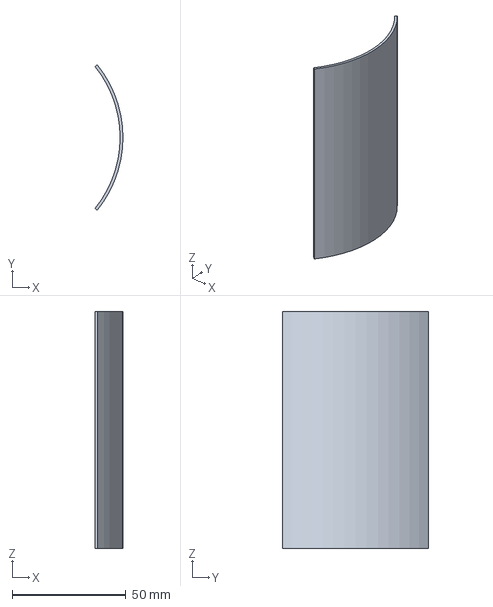
[picture p270: CAD file, 2026-10-11]
cad/out/parts/DOOR-01.step
12.3 x 63.9 x 104.0 mm
