chaseyarnall173/Self-Landing-Rocket/cad/out/parts/CHUTE-PIN.step

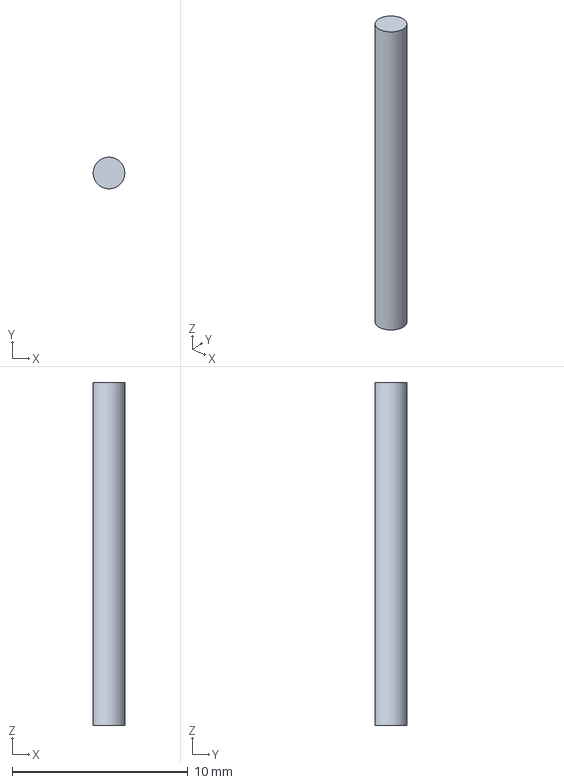
[picture p271: CAD file, 2026-10-11]
cad/out/parts/CHUTE-PIN.step
1.80 x 1.80 x 19.5 mm
