chaseyarnall173/Self-Landing-Rocket/cad/out/parts/SLEEVE-29.step

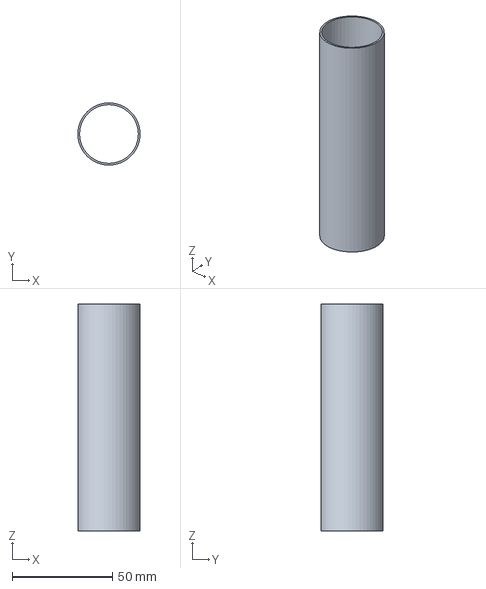
[picture p272: CAD file, 2026-10-11]
cad/out/parts/SLEEVE-29.step
31.0 x 31.0 x 113.0 mm
