chaseyarnall173/Self-Landing-Rocket/cad/out/parts/AV-ROD.step

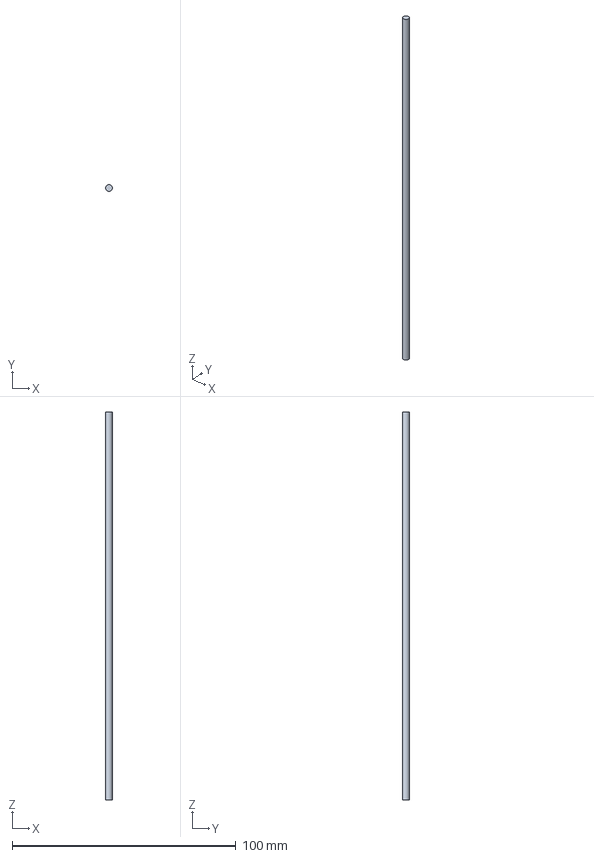
[picture p273: CAD file, 2026-10-11]
cad/out/parts/AV-ROD.step
3.00 x 3.00 x 173.3 mm
