chaseyarnall173/Self-Landing-Rocket/cad/out/parts/HEADERS.step

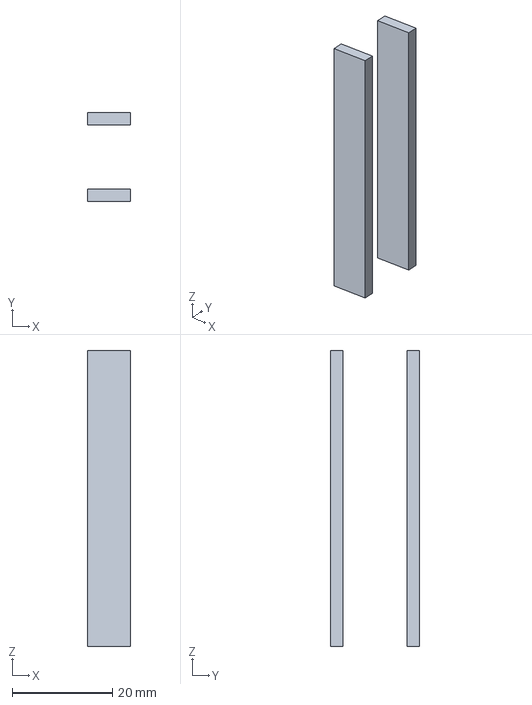
[picture p274: CAD file, 2026-10-11]
cad/out/parts/HEADERS.step
8.50 x 17.8 x 59.0 mm
