chaseyarnall173/Self-Landing-Rocket/cad/out/parts/BARO-BMP390.step

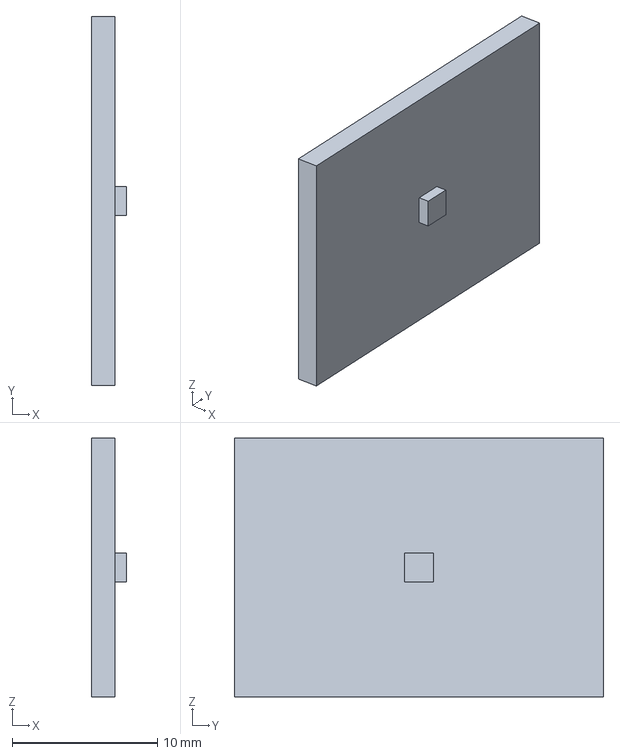
[picture p275: CAD file, 2026-10-11]
cad/out/parts/BARO-BMP390.step
2.40 x 25.4 x 17.8 mm
