chaseyarnall173/Self-Landing-Rocket/cad/out/parts/LEG-RELEASE-PIN.step

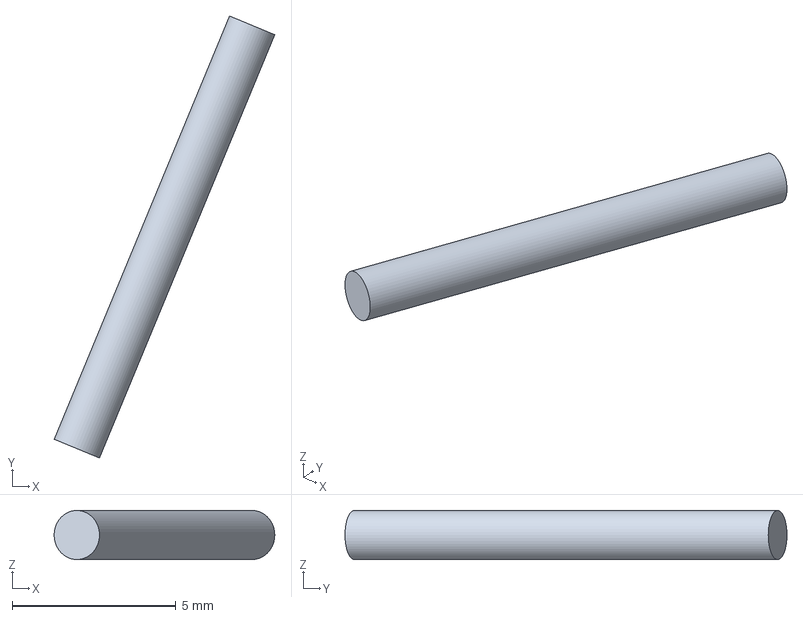
[picture p276: CAD file, 2026-10-11]
cad/out/parts/LEG-RELEASE-PIN.step
6.74 x 13.5 x 1.50 mm
