chaseyarnall173/Self-Landing-Rocket/cad/out/parts/TUBE-02.step

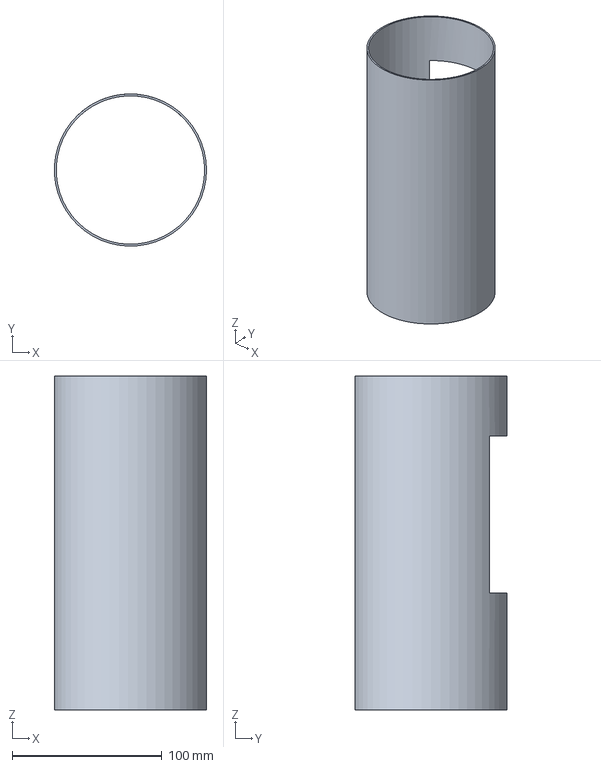
[picture p277: CAD file, 2026-10-11]
cad/out/parts/TUBE-02.step
101.5 x 101.6 x 223.0 mm
