chaseyarnall173/Self-Landing-Rocket/(list of files, cad)

Other CAD files:
cad/out/parts/AV-LID-RING-F.step
cad/out/parts/PADDLE-PIN-L.step
cad/out/parts/GIMBAL-POST-B.step
cad/out/parts/AV-LID-A.step
cad/out/parts/SERVO-BRKT-B.step
cad/out/parts/RECOV-BH.step
cad/out/parts/SERVO-GIMBAL-B.step
cad/out/parts/HORN-GIMBAL-A.step
cad/out/parts/SERVO-LATCH.step
cad/out/parts/HORN-GIMBAL-B.step
cad/out/parts/SERVO-LEGPIN.step
cad/out/parts/PADDLE-L.step
cad/out/parts/CLIP-RET-L.step
cad/out/parts/PADDLE-LINK-R.step
cad/out/parts/HORN-CHUTE.step
cad/out/parts/HORN-LATCH.step
cad/out/parts/PADDLE-ARM-OL.step
cad/out/parts/PADDLE-ARM-IL.step
cad/out/dxf/AV-LID-A.dxf
cad/out/dxf/AV-LID-F.dxf
cad/out/dxf/AV-SLED.dxf
cad/out/dxf/FIN-01.dxf
cad/out/dxf/RECOV-BH.dxf
cad/out/dxf/THRUST-PLATE-AL.dxf
cad/out/dxf/THRUST-PLATE.dxf
cad/out/parts/NOSE-SCREW.step
cad/out/parts/NUT-M3.step
cad/out/parts/NUT-M4.step
cad/out/parts/UBOLT.step
cad/out/stl/AV-LID-RING-A.stl
cad/out/stl/AV-LID-RING-F.stl
cad/out/stl/AV-SLED-TUBE.stl
cad/out/stl/CHUTE-SERVO-BRKT.stl
cad/out/stl/DOOR-HINGE-F.stl
cad/out/stl/DOOR-HINGE-M.stl
cad/out/stl/DOOR-LUG.stl
cad/out/stl/EJECT-CUP.stl
cad/out/stl/F25W-SPACER.stl
cad/out/stl/GIMBAL-INNER.stl
cad/out/stl/GIMBAL-MIDDLE.stl
cad/out/stl/GIMBAL-POST-B.stl
cad/out/stl/GIMBAL-POST.stl
cad/out/stl/GROMMET.stl
cad/out/stl/LATCH-RING.stl
cad/out/stl/LATCH-SERVO-BRKT.stl
cad/out/stl/LEG-CLEVIS.stl
cad/out/stl/LEG-FOOT.stl
cad/out/stl/LEG-INSERT.stl
cad/out/stl/LEGPIN-BRKT.stl
cad/out/stl/LIDAR-BRKT.stl
cad/out/stl/NOSE-01.stl
cad/out/stl/PETAL-HINGE-F.stl
cad/out/stl/PETAL-HINGE-M.stl
cad/out/stl/PETAL-TAB.stl
cad/out/stl/SERVO-BRKT-A.stl
cad/out/stl/SERVO-BRKT-B.stl
