chaseyarnall173/Self-Landing-Rocket/cad/slr1/sections.py

"""Section-by-section guide: what every part is for.

Used by build.py (writes out/viewer/sections.json) for the section images,
the viewer's part cards, docs/14-sections.md and the website.
Each part: (short callout label, what it does).
"""

PARTS = {
    # ------------------------------------------------------------------ nose
    "NOSE-01": ("Nose cone", "Printed PETG tangent ogive, 0.8 mm wall. Its 2 in shoulder slides into the nose ring. Three printed bosses inside take the retention screws."),
    "NOSE-SCREW": ("M3 retention screws", "Hold the nose on through the nose ring. Take them out to lift the nose off and reach the airbrake latch."),

    # ------------------------------------------------------------------ top airbrakes
    "TUBE-01": ("Nose ring (tube)", "The 71 mm piece of body tube between the nose and the petals. The fixed hinge halves are bonded to it, and it is glued 19 mm onto the airbrake sleeve."),
    "PETAL-01": ("Airbrake petal (x4)", "A 90° quadrant cut from the body tube, 150 mm long. Flush with the skin on the way up; springs out to 90° at apogee so the rocket falls tail-first and stable at ~18 m/s."),
    "PETAL-HINGE-F": ("Fixed hinge half + 90° stop", "Printed CF-nylon leaf bonded to the nose ring with two knuckles. Its stop block catches the open petal at 90° against ~3 N of air load."),
    "PETAL-HINGE-M": ("Moving hinge half", "Printed CF-nylon leaf bonded to the petal's forward edge; its middle knuckle turns on the hinge pin."),
    "PETAL-PIN": ("Hinge pin", "1.6 mm stainless pin through the three knuckles; it also carries the torsion spring."),
    "PETAL-SPRING": ("Torsion spring", "About 0.1 N·m of preload that flips the petal open in under 0.2 s when the latch lets go."),
    "PETAL-TAB": ("Latch tab", "Printed tab bonded inside the petal's aft edge. It pokes through the sleeve slot, and its notch is where the latch-ring finger sits."),
    "CPL-01": ("Airbrake sleeve (coupler)", "189 mm LOC coupler that holds the nose ring and the recovery section together across the petal band. Windows under each petal save 33 g; slots let the petal tabs through."),
    "LATCH-RING": ("Latch ring", "Printed ring inside the sleeve with one finger per petal. Turning it a few degrees slides all four fingers out of the tab notches at once."),
    "SERVO-LATCH": ("Latch servo", "4.3 g micro servo (pin 7) that turns the latch ring at apogee."),
    "HORN-LATCH": ("Servo horn", "Arm on the latch servo's output shaft."),
    "LATCH-LINK": ("Latch link", "Wire link with ball ends from the horn to the latch ring's lug."),
    "LATCH-SERVO-BRKT": ("Servo mount", "Printed block that bonds the latch servo to the solid strip of sleeve between two windows."),

    # ------------------------------------------------------------------ backup chute bay
    "TUBE-02": ("Recovery section (tube)", "223 mm of body tube between the petals and the avionics bay. It holds the chute bay and has the door cut out of it."),
    "DOOR-01": ("Chute door", "105 x 70 mm panel cut from the tube. It is latched shut in a normal flight; in an abort it swings open and the chute is pushed out."),
    "DOOR-HINGE-F": ("Door hinge, fixed half", "Printed hinge leaf on the tube at the door's aft edge."),
    "DOOR-HINGE-M": ("Door hinge, moving half", "Printed hinge leaf on the door."),
    "DOOR-PIN": ("Door hinge pin", "1.6 mm stainless pin through the door hinge."),
    "DOOR-LUG": ("Door latch lug", "Printed lug inside the door's forward edge; the chute-latch pin passes through it to hold the door shut."),
    "RECOV-BH": ("Recovery bulkhead", "1/8 in ply disc glued in the tube at the top of the chute bay. It carries the U-bolt and separates the bay from the airbrake sleeve."),
    "UBOLT": ("U-bolt", "M4 U-bolt: the strong point the shock cord and chute hang from."),
    "NUT-M4": ("M4 nuts", "Clamp the U-bolt to the bulkhead."),
    "CHUTE-NOMEX": ("Nomex wrap", "Fire-resistant blanket wrapped around the folded chute, in case the motors' heat reaches it."),
    "CHUTE-30": ("Backup parachute, 30 in", "Nylon chute, Z-folded to about 54 x 74 mm. Used only in an abort; it brings 1.4 kg down at about 5-6 m/s."),
    "SHOCK-CORD": ("Shock cord", "4.5 m of Kevlar, flaked and bundled. It absorbs the snatch when the chute opens."),
    "SHOCK-CORD-RUN": ("Cord to U-bolt", "The ends of the shock cord: one tied to the U-bolt, one to the chute's riser."),
    "EJECT-PLATE": ("Ejector plate", "Thin ply plate on two springs that pushes the chute pack toward the door."),
    "EJECT-SPRING": ("Ejector springs (x2)", "Compression springs, ~20 N each, that throw the chute out when the door opens."),
    "EJECT-CUP": ("Spring seats (x2)", "Printed cups bonded to the far wall that locate the ejector springs."),
    "SERVO-CHUTE": ("Chute-latch servo", "4.3 g micro servo (pin 29) under the bulkhead. It pulls the latch pin to open the door."),
    "HORN-CHUTE": ("Servo horn", "Arm on the chute-latch servo."),
    "CHUTE-PIN": ("Latch pin", "1.8 mm steel pin through the door lug. Pulling it releases the door."),
    "CHUTE-LINK": ("Pin link", "Wire link from the servo horn to the latch pin."),
    "CHUTE-SERVO-BRKT": ("Servo mount", "Printed block that bonds the servo to the bulkhead."),
    "CABLE-FWD": ("Servo cable", "Runs the airbrake-latch and chute-latch servo leads up from the avionics bay through the bulkhead."),

    # ------------------------------------------------------------------ avionics bay
    "TUBE-03": ("Switch band", "25 mm ring of body tube glued around the middle of the avionics coupler. It carries the arm key, main switch, leg-release pin and three static ports."),
    "CPL-02": ("Avionics coupler", "160 mm LOC coupler that is the avionics bay. It joins the recovery section to the aft tube."),
    "AV-LID-F": ("Forward lid", "1/8 in ply disc that closes the top of the bay; the GPS patch hangs under it."),
    "AV-LID-A": ("Aft lid", "1/8 in ply disc that closes the bottom of the bay, with the harness grommet and lidar-cable hole."),
    "AV-LID-RING-F": ("Lid ring (forward)", "Printed ring that keys the forward lid into the coupler."),
    "AV-LID-RING-A": ("Lid ring (aft)", "Printed ring that keys the aft lid into the coupler."),
    "AV-ROD": ("Threaded rods (x2)", "M3 nylon rods that clamp the two lids to the coupler and guide the sled."),
    "NUT-M3": ("Wing nuts (x4)", "Nylon wing nuts on the rod ends; finger-tight so the bay opens on the field."),
    "AV-SLED": ("Sled", "1/8 in lite-ply board everything electronic mounts to. It slides out on the rods."),
    "AV-SLED-TUBE": ("Rod guides (x2)", "Printed tubes along the sled edges that ride on the threaded rods."),
    "STANDOFF-3": ("Standoffs", "3 mm nylon spacers under the boards."),
    "PERFBOARD": ("Flight-computer board", "54 x 120 mm perfboard carrying the Teensy, sensors, regulator and pyro channels. Becomes a PCB once the design is frozen."),
    "HEADERS": ("Header strips", "Sockets the Teensy plugs into, so it can be swapped."),
    "TEENSY-41": ("Teensy 4.1", "The flight computer: a 600 MHz microcontroller that runs the 1 kHz state estimator and re-plans the landing burn 50 times a second, logging everything to its microSD card."),
    "IMU-BMI088": ("BMI088 IMU", "Accelerometer (±24 g) and gyro. Mounted near the rocket's axis so it reads attitude and acceleration cleanly."),
    "STANDOFF-5": ("IMU standoffs", "Four 5 mm standoffs that mount the IMU rigidly."),
    "BARO-BMP390": ("BMP390 barometer", "Measures air pressure for altitude through the whole flight, through the static ports."),
    "BARO-FOAM": ("Barometer foam", "Open-cell foam that shields the barometer from gusts and light."),
    "BUCK-5V": ("5 V regulator", "Steps the 2S battery down to 5 V for the Teensy, lidar and micro servos."),
    "FET-AO3400": ("Pyro MOSFETs (x2)", "Switch the two landing-motor igniters, fired together."),
    "CAP-1000U": ("Servo-rail capacitor", "1000 µF reservoir that keeps servo current spikes from browning out the computer."),
    "BUZZER": ("Buzzer", "Beeps the arm state and status on the pad and helps you find the rocket."),
    "JST-GH": ("Locking connectors", "JST-GH headers for servos, sensors and the pyro leads; they can't shake loose."),
    "SERVO-LEGPIN": ("Leg-release servo", "4.3 g micro servo (pin 28) that pulls the leg-release pin at 12 m."),
    "HORN-LEGPIN": ("Servo horn", "Arm on the leg-release servo."),
    "LEG-RELEASE-PIN": ("Leg-release pin", "1.5 mm steel pin poking out of the switch band. The Kevlar loop that holds the folded legs hooks over it."),
    "LEGPIN-LINK": ("Pin link", "Wire link from the servo horn to the release pin."),
    "LEGPIN-BRKT": ("Servo mount", "Printed block that bonds the leg-release servo to the coupler wall."),
    "LIPO-2S": ("2S LiPo battery", "450 mAh, 7.4 V pack that powers everything for about 15 minutes of pad time."),
    "GPS-M9N": ("GPS receiver", "u-blox NEO-M9N; gives the sideways velocity the landing burn cancels."),
    "GPS-PATCH": ("GPS antenna", "25 mm ceramic patch under the forward lid, facing the sky."),
    "LORA-RFM95W": ("LoRa radio", "915 MHz telemetry link to the ground station."),
    "LORA-ANT": ("Radio antenna", "82 mm quarter-wave wire antenna."),
    "ARM-KEY-SW": ("Arm key switch", "Physical switch in the igniter power line. Key out means the landing motor cannot fire, whatever the software does."),
    "ARM-KEY": ("Arm key", "Removable key; it goes in only at the pad."),
    "MAIN-SW": ("Main power switch", "Turns the flight computer on."),
    "GROMMET": ("Harness grommet", "Printed TPU grommet where the servo and pyro wiring leaves the bay."),

    # ------------------------------------------------------------------ aft airframe
    "TUBE-04": ("Aft tube", "731 mm of body tube from the avionics bay to the tail. Slotted for the fins and leg clevises."),
    "LINER-AFT": ("Carbon liner", "Two wraps of carbon cloth inside the last 6 in. They stiffen the tube where the fins, legs and thrust plate load it."),
    "FIN-01": ("Fin (x4)", "3/32 in birch ply, through the wall. Keeps the rocket pointed while it coasts up with the motor out."),
    "FIN-FILLET": ("Epoxy fillets (x8)", "6 mm epoxy fillets on both sides of each fin root; they make the joint strong."),
    "HARNESS-AFT": ("Wiring harness", "Servo and pyro wiring from the avionics bay down the tube wall to the motor bay."),
    "CABLE-LIDAR": ("Lidar cable", "Runs from the avionics bay to the lidar along the 315° leg line."),

    # ------------------------------------------------------------------ landing legs
    "LEG-CLEVIS": ("Hinge clevis + 55° stop", "Printed CF-nylon bracket bonded through a slot in the tube. Its cheeks hold the hinge pin, and its stop block catches the leg at 55°."),
    "LEG-DOUBLER": ("Doubler", "1/8 in ply pad inside the tube that the clevis tongue bonds to, spreading the landing load."),
    "LEG-PIN": ("Hinge pin", "3 mm steel pin the leg pivots on."),
    "LEG-SPRING": ("Torsion spring", "About 0.15 N·m that swings the leg out in under 0.3 s once released."),
    "LEG-INSERT": ("Knuckle insert", "Printed knuckle around the pin, with a plug bonded into the strut."),
    "LEG-STRUT": ("Strut", "532 mm of 8 x 7 mm pultruded carbon tube."),
    "LEG-DAMPER": ("Damper barrel", "Syringe-style air damper bonded to the strut tip. It soaks up the touchdown so the rocket doesn't bounce."),
    "LEG-PLUNGER": ("Damper plunger", "Piston and rod that slide in the damper and carry the foot."),
    "LEG-FOOT": ("Foot", "30 mm TPU lattice pad, angled to sit flat at 55°; it also crushes to absorb energy."),
    "LEG-LOOP": ("Release loop", "Kevlar loop around all four folded legs, hooked over the release pin. Pulling the pin lets all four legs swing out together."),

    # ------------------------------------------------------------------ motor bay
    "MOTOR-F52C": ("F52C ascent motor", "AeroTech F52C, 66 N·s. Lit by the launch controller; flies the rocket to ~226 ft."),
    "MOTOR-F25W": ("F25W landing motor", "AeroTech F25W, 71 N·s. Lit by the flight computer at ~15 m on the way down; its thrust fades naturally ('strong, then simmer')."),
    "F25W-SPACER": ("F25W spacer", "13 mm printed spacer so both nozzles end at the same height (the F25W is shorter)."),
    "SLEEVE-29": ("Motor sleeve (x2)", "113 mm kraft motor tube bonded into the inner gimbal ring; the motors slide in from the bottom."),
    "SLEEVE-CAP": ("Thrust cap (x2)", "Aluminium cap on the top of each sleeve. The motor pushes on it, and the igniter leads pass through its hole."),
    "CLIP-RET": ("Clip retainer (ascent)", "Spring-steel clip that hooks under the motor's aft end so it can't slide out."),
    "CLIP-RET-L": ("Clip retainer (landing)", "Same clip on the landing-motor sleeve."),
    "IGN-CONN": ("Igniter connector", "Locking 2-pin connector for the landing igniters; it stays unplugged until the pad."),
    "GIMBAL-INNER": ("Inner gimbal ring", "Holds both sleeves. Tilts about the X axis on the X pins; servo B drives it."),
    "GIMBAL-MIDDLE": ("Middle gimbal ring", "Carries the inner ring. Tilts about the Y axis on the Y pins; servo A drives it."),
    "GIMBAL-POST": ("Yoke post (+Y)", "Fixed post from the thrust plate that holds one Y pin."),
    "GIMBAL-POST-B": ("Yoke post (−Y)", "The matching post on the other side."),
    "PIN-X": ("X pins (x2)", "3 mm steel pivots between the inner and middle rings."),
    "PIN-Y": ("Y pins (x2)", "3 mm steel pivots between the middle ring and the yoke posts."),
    "THRUST-PLATE": ("Thrust plate (ply)", "1/8 in ply ring bonded in the tube. All motor thrust ends up here and goes into the airframe."),
    "THRUST-PLATE-AL": ("Thrust plate (aluminium)", "1 mm aluminium ring on the ply that spreads the post and servo loads."),
    "SERVO-GIMBAL-A": ("Gimbal servo A", "KST X08H (pin 2) that tilts the middle ring: pitch."),
    "HORN-GIMBAL-A": ("Servo horn A", "10 mm horn, about a 2:1 servo-to-gimbal ratio."),
    "PUSHROD-A": ("Pushrod A", "1.5 mm steel rod with ball links from servo A to the middle-ring lug."),
    "SERVO-BRKT-A": ("Servo bracket A", "Printed bracket on the thrust plate."),
    "SERVO-GIMBAL-B": ("Gimbal servo B", "KST X08H (pin 3) that tilts the inner ring: yaw."),
    "HORN-GIMBAL-B": ("Servo horn B", "10 mm horn."),
    "PUSHROD-B": ("Pushrod B", "Ball-link rod from servo B to the inner-ring lug."),
    "SERVO-BRKT-B": ("Servo bracket B", "Printed bracket on the thrust plate."),
    "LIDAR-TFMINI": ("Lidar", "Benewake TFmini-S looking straight down; measures the last ~7 m to the ground and detects touchdown."),
    "LIDAR-WINDOW": ("Lidar window", "Replaceable 1 mm polycarbonate shield that keeps exhaust soot off the lidar's lenses. Wipe it after every flight."),
    "LIDAR-BRKT": ("Lidar bracket", "Printed bracket on the liner at 315°, clear of both plumes and the paddles; its lip holds the window."),

    # ------------------------------------------------------------------ throttle
    "PADDLE-R": ("Paddle (+Y)", "Machinable ceramic, 20 x 28 x 4 mm. Swings into the landing motor's exhaust to deflect up to 75 % of its thrust sideways: the throttle."),
    "PADDLE-L": ("Paddle (−Y)", "Its twin on the other side, so the two side forces cancel."),
    "PADDLE-ARM-OR": ("Outboard arm + lever (+Y)", "1.5 mm stainless arm that holds the paddle; its lever is what the scissor link pushes."),
    "PADDLE-ARM-OL": ("Outboard arm + lever (−Y)", "Same, other paddle."),
    "PADDLE-ARM-IR": ("Inboard arm (+Y)", "Second stainless arm on the paddle's other end."),
    "PADDLE-ARM-IL": ("Inboard arm (−Y)", "Same, other paddle."),
    "PADDLE-PIN-R": ("Pivot pin (+Y)", "2 mm steel pin the paddle swings on, 8 mm below the nozzle."),
    "PADDLE-PIN-L": ("Pivot pin (−Y)", "Same, other paddle."),
    "PADDLE-BRKT": ("Paddle bracket", "1.5 mm aluminium U-bracket under the inner gimbal ring, so the paddles move with the motor."),
    "PADDLE-XHEAD": ("Scissor crosshead", "Slides up and down. Through the two links it opens or closes both paddles together."),
    "PADDLE-LINK-R": ("Scissor link (+Y)", "Link from the crosshead to the +Y paddle lever."),
    "PADDLE-LINK-L": ("Scissor link (−Y)", "Link to the −Y paddle lever."),
    "SERVO-PADDLE": ("Throttle servo", "KST X08H (pin 4) strapped to the bracket. It moves the crosshead 50 times a second to follow the burn plan."),
    "HORN-PADDLE": ("Servo horn", "10 mm horn on the throttle servo."),
    "PADDLE-SERVO-LINK": ("Servo link", "Link from the horn to the crosshead, through a slot in the bracket."),
    "HEAT-SHIELD": ("Heat shield", "Aluminium plus ceramic paper under the servo, between it and the plume."),
}

# Sections in rocket order (nose to tail). Each view is rendered on its own;
# every part gets its numbered callout in the view where it shows best,
# unless a view lists its parts explicitly.
SECTIONS = [
    dict(key="nose", title="Nose cone", cfg="flight",
         intro="The printed nose is the top 323 mm of the rocket. It comes off (three screws) so you can reach the airbrake latch.",
         pids=["NOSE-01", "NOSE-SCREW"], ghost=[],
         views=[dict(d=[0.45, -1, 0.35], cut=True)]),
    dict(key="airbrakes", title="Top airbrakes", cfg="flight",
         intro="Four petals cut from the body tube, just below the nose. At apogee one servo turns a latch ring and springs flip all four out to 90°. Drag at the top keeps the falling rocket tail-down, the way a shuttlecock's feathers keep it cork-first.",
         pids=["TUBE-01", "PETAL-01", "PETAL-HINGE-F", "PETAL-HINGE-M", "PETAL-PIN", "PETAL-SPRING", "PETAL-TAB",
               "CPL-01", "LATCH-RING", "SERVO-LATCH", "HORN-LATCH", "LATCH-LINK", "LATCH-SERVO-BRKT"],
         ghost=["TUBE-01", "PETAL-01", "CPL-01"],
         views=[dict(d=[0.55, -1, 0.3]), dict(d=[1, 0.8, 0.25]),
                dict(d=[1, -1.1, 0.45], cfg="landing", ghost=[], w=0.56, title="Open at apogee",
                     also=["PETAL-01", "PETAL-HINGE-F", "PETAL-HINGE-M", "CPL-01"])]),
    dict(key="chute", title="Backup chute bay", cfg="flight",
         intro="Abort-only recovery. A servo pulls a pin, the door swings open and two springs push the 30 in chute out. In a normal flight this bay never opens.",
         pids=["TUBE-02", "DOOR-01", "DOOR-HINGE-F", "DOOR-HINGE-M", "DOOR-PIN", "DOOR-LUG", "RECOV-BH", "UBOLT",
               "NUT-M4", "CHUTE-NOMEX", "CHUTE-30", "SHOCK-CORD", "SHOCK-CORD-RUN", "EJECT-PLATE", "EJECT-SPRING",
               "EJECT-CUP", "SERVO-CHUTE", "HORN-CHUTE", "CHUTE-PIN", "CHUTE-LINK", "CHUTE-SERVO-BRKT", "CABLE-FWD"],
         ghost=["TUBE-02", "DOOR-01", "CHUTE-NOMEX"],
         views=[dict(d=[0.35, -1, 0.2]), dict(d=[-0.3, 1, 0.25])]),
    dict(key="avionics", title="Avionics bay", cfg="flight",
         intro="The flight computer, sensors, radio and battery on a sled that slides out. The switch band around the middle carries the arm key, the power switch, the static ports and the leg-release pin.",
         pids=["TUBE-03", "CPL-02", "AV-LID-F", "AV-LID-A", "AV-LID-RING-F", "AV-LID-RING-A", "AV-ROD", "NUT-M3",
               "AV-SLED", "AV-SLED-TUBE", "STANDOFF-3", "PERFBOARD", "HEADERS", "TEENSY-41", "IMU-BMI088",
               "STANDOFF-5", "BARO-BMP390", "BARO-FOAM", "BUCK-5V", "FET-AO3400", "CAP-1000U", "BUZZER", "JST-GH",
               "LIPO-2S", "GPS-M9N", "GPS-PATCH", "LORA-RFM95W", "LORA-ANT", "ARM-KEY-SW", "ARM-KEY", "MAIN-SW",
               "SERVO-LEGPIN", "HORN-LEGPIN", "LEG-RELEASE-PIN", "LEGPIN-LINK", "LEGPIN-BRKT", "GROMMET"],
         ghost=["TUBE-03", "CPL-02"],
         views=[dict(d=[1, -0.35, 0.2]), dict(d=[-1, -0.3, 0.2])]),
    dict(key="aft", title="Aft airframe and fins", cfg="flight", horizontal=True,
         intro="The long aft tube carries the fins and the legs, and the wiring from the avionics bay runs down its wall to the motor bay. A carbon liner stiffens the last 6 in.",
         pids=["TUBE-04", "LINER-AFT", "FIN-01", "FIN-FILLET", "HARNESS-AFT", "CABLE-LIDAR"],
         ghost=["TUBE-04", "LINER-AFT"],
         views=[dict(d=[0.2, -1, 0.08], w=0.7)]),
    dict(key="legs", title="Landing legs", cfg="landing", only_instance=1,
         intro="Four carbon legs fold flat along the body for flight. At 12 m a servo pulls one pin, the Kevlar loop lets go, and springs swing all four out to 55°, where a stop and a detent lock them.",
         pids=["LEG-CLEVIS", "LEG-DOUBLER", "LEG-PIN", "LEG-SPRING", "LEG-INSERT", "LEG-STRUT", "LEG-DAMPER",
               "LEG-PLUNGER", "LEG-FOOT", "LEG-LOOP"],
         ghost=[], context=["TUBE-04", "LINER-AFT"],
         views=[dict(d=[0.3, -1, 0.15], pids=["LEG-STRUT"], also=["LEG-CLEVIS", "LEG-DAMPER", "LEG-FOOT"],
                     fit=["LEG-CLEVIS", "LEG-STRUT", "LEG-DAMPER", "LEG-FOOT"], title="Deployed (1 of 4)"),
                dict(d=[0.14, 0.99, 0.35], ghost=["LEG-STRUT"], fit=["LEG-CLEVIS", "LEG-PIN", "LEG-SPRING", "LEG-INSERT"],
                     pids=["LEG-CLEVIS", "LEG-DOUBLER", "LEG-PIN", "LEG-SPRING", "LEG-INSERT"], title="Hinge"),
                dict(d=[0.3, -1, 0.3], ghost=["LEG-DAMPER"], pids=["LEG-DAMPER", "LEG-PLUNGER", "LEG-FOOT"], title="Damper and foot"),
                dict(d=[0.55, -1, 0.25], cfg="flight", pids=["LEG-LOOP"], title="Folded for flight")]),
    dict(key="motorbay", title="Motor bay and TVC gimbal", cfg="flight",
         intro="Both motors sit side by side in one 2-axis gimbal centred on its pivot. Two servos tilt it up to 7° each way to steer the thrust. All thrust flows from the sleeve caps through the rings and pins into the thrust plate.",
         pids=["MOTOR-F52C", "MOTOR-F25W", "F25W-SPACER", "SLEEVE-29", "SLEEVE-CAP", "CLIP-RET", "CLIP-RET-L",
               "IGN-CONN", "GIMBAL-INNER", "GIMBAL-MIDDLE", "GIMBAL-POST", "GIMBAL-POST-B", "PIN-X", "PIN-Y",
               "THRUST-PLATE", "THRUST-PLATE-AL", "SERVO-GIMBAL-A", "HORN-GIMBAL-A", "PUSHROD-A", "SERVO-BRKT-A",
               "SERVO-GIMBAL-B", "HORN-GIMBAL-B", "PUSHROD-B", "SERVO-BRKT-B", "LIDAR-TFMINI", "LIDAR-WINDOW",
               "LIDAR-BRKT"],
         ghost=["SLEEVE-29", "THRUST-PLATE", "THRUST-PLATE-AL"],
         views=[dict(d=[0.4, -1, 0.3]), dict(d=[-0.4, 1, 0.3]), dict(d=[0.5, -0.6, -0.9], title="From below")]),
    dict(key="throttle", title="Exhaust-paddle throttle", cfg="flight",
         intro="A solid motor can't be throttled, so two ceramic paddles under the landing motor swing into its exhaust and deflect part of the thrust sideways. One servo drives both through a scissor linkage, so the side forces cancel.",
         pids=["PADDLE-R", "PADDLE-L", "PADDLE-ARM-OR", "PADDLE-ARM-OL", "PADDLE-ARM-IR", "PADDLE-ARM-IL",
               "PADDLE-PIN-R", "PADDLE-PIN-L", "PADDLE-BRKT", "PADDLE-XHEAD", "PADDLE-LINK-R", "PADDLE-LINK-L",
               "SERVO-PADDLE", "HORN-PADDLE", "PADDLE-SERVO-LINK", "HEAT-SHIELD"],
         ghost=[], context=["MOTOR-F25W", "SLEEVE-29"],
         views=[dict(d=[-0.75, -1, 0.15]), dict(d=[-0.6, 0.9, -0.35])]),
]


def check(all_pids):
    """Every part must be in exactly one section and have a description."""
    seen = {}
    for s in SECTIONS:
        for p in s["pids"]:
            assert p not in seen, f"{p} in {seen[p]} and {s['key']}"
            seen[p] = s["key"]
    missing = sorted(set(all_pids) - set(seen))
    undescribed = sorted(set(all_pids) - set(PARTS))
    return missing, undescribed
