chaseyarnall173/Self-Landing-Rocket/firmware/src/core/landing_guidance.h

// Landing-burn guidance: ignition decision + exhaust-paddle throttle plan.
// C++ port of sim/rocketsim/guidance.py (FlightComputer.landing_window,
// plan, best_plan, fire_now and the terminal braking law). See
// docs/06-gnc.md for the derivation.
#pragma once
#include "motor_curve.h"

struct LandingVehicle {
    const MotorCurve* landing;   // landing motor curve
    float dry_mass_kg;           // dry vehicle (no motors)
    float spent_ascent_kg;       // casing of the burnt-out ascent motor
    float cda_pre_m2;            // CdA with the top airbrakes out
    float cda_burn_m2;           // CdA with the airbrakes stowed
    float throttle_min;          // paddle authority (fraction of thrust left when closed)
    float v_td;                  // target touchdown speed (positive number, m/s)
    float window_hop_margin;
    float window_end_thrust_ratio;
};

struct ThrottlePlan {
    bool valid = false;
    float t_land = 0;  // burn clock at touchdown
    float k0 = 0;      // throttle now
    float k1 = 0;      // throttle slope (1/s) - ramp plans only
    float violation = 0;
    float a_end = 0;   // net upward acceleration at touchdown - exp plans only
};

// "Strong then simmer" profile: net upward acceleration a(s) = A*exp(-s/tau) + C.
struct ExpProfile {
    float A = 0, C = 0, tau = 0, a_end = 0;
    float k_min = 0, k_max = 0, k_first = 0, k_mid = 0, k_last = 0;
};

class LandingGuidance {
public:
    explicit LandingGuidance(const LandingVehicle& v) : v_(v) {}

    float mass(float tb) const;            // vehicle mass at burn clock tb (<0 = unlit)
    void window(float& t1, float& t2);     // allowed touchdown burn-clock window

    // Throttle ramp k(s)=k0+k1*s reaching h=0, v=-v_td at burn clock t_land.
    bool plan(float h, float v, float rho, float tb_now, float t_land, float cos_tilt,
              float cda, float thrust_scale, float& k0, float& k1) const;

    // Search the window for the most feasible plan (hysteresis on t_land).
    ThrottlePlan best_plan(float h, float v, float rho, float tb_now, float cos_tilt,
                           float cda, float thrust_scale);

    // "Strong then simmer": solve A, C so that h = 0 and v = -v_td at t_land,
    // then evaluate the throttle k(s) = m(a + g - drag) / thrust along it.
    bool plan_exp(float h, float v, float rho, float tb_now, float t_land, float tau_frac,
                  float cos_tilt, float cda, float thrust_scale, ExpProfile& out) const;

    // Search touchdown time and decay rate for the most feasible exp profile
    // that also ends near hover (thrust + drag ~ weight at touchdown).
    ThrottlePlan best_plan_exp(float h, float v, float rho, float tb_now, float cos_tilt,
                               float cda, float thrust_scale, float end_weight);

    // True when the ignition command should be sent now (motor unlit).
    // window_frac: where in the touchdown window the fire plan aims (0..1).
    bool fire_now(float h, float v, float rho, float delay_s, float fire_k1, bool keep_drag,
                  float window_frac = 0.5f);

    // Terminal braking law (below TERMINAL_ALT): throttle for constant decel
    // to v_td at h=0.
    float terminal_throttle(float h, float v, float rho, float tb, float cos_tilt, float cda,
                            float thrust_scale, float kv) const;

    void reset() { have_t_land_ = false; }

private:
    LandingVehicle v_;
    bool have_window_ = false;
    float t1_ = 0, t2_ = 0;
    bool have_t_land_ = false;
    float t_land_pref_ = 0;
};
