chaseyarnall173/Self-Landing-Rocket/(commit log)

2026-10-10 Add SLR-1 mission simulator with Monte Carlo analysis
    Planar 3-DOF simulation of the full self-landing mission: TVC boost on an
    AeroTech G40W, fin-stabilised coast, drogue-stabilised tail-first descent,
    and a landing burn on a second G40W throttled by exhaust paddles. Includes
    official ThrustCurve.org motor curves, an itemised mass budget, component
    aerodynamics for nose-first and tail-first flow, the flight-computer
    guidance in the loop, and a parallel Monte Carlo dispersion runner.
    Claude-Session: https://claude.ai/code/session_019QoTZhPgHotxcE6gm8q9F1
2026-10-10 Add Teensy 4.1 flight software with native tests
    Hardware-independent C++ core (estimation, TVC control, throttle-ramp
    landing guidance, state machine with safety interlocks), a Teensy HAL
    (BMI088, BMP390, TFmini-S, servos, key-gated pyro channels, SD logging),
    and native unit plus software-in-the-loop tests that check the C++ against
    values generated by the Python simulator.
    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
2026-10-10 Add design documentation, build guide, test plan and checklists
    Mission and architecture trade study, regulations and safety (FAA Part
    101, NAR, Massachusetts), vehicle design and mass budget, propulsion and
    exhaust-paddle throttle, avionics and pyro circuits, GNC derivations with
    simulation results, landing legs, step-by-step build guide, test ladder,
    flight checklists, bill of materials and references.
    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
2026-10-10 Redesign for engine-only recovery: 200 ft flight, top airbrakes, decaying landing burn
    Rev B of SLR-1, following the request for no drogue, a ~200 ft flight and a
    landing burn that starts strong and simmers down to near hover.
    - Motors: AeroTech F42T ascent + F25W landing (official ThrustCurve RASP
    files added). Both are CPSC-exempt F motors; 127 N*s total, 1000 ft field.
    - Drogue removed. Four spring-out petals at the top of the tube open at
    apogee and keep the rocket stable tail-first (+0.51 cal) at ~18.5 m/s; the
    engine does all braking. The backup chute stays as abort-only.
    - Guidance: exponential-decay plan a(s) = A*exp(-s/tau) + C, solved for
    h = 0 and v = -0.5 m/s, preferring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
    [actuators.cpp, actuators.h, board.h, flight_fsm.cpp, flight_fsm.h]
2026-10-10 Add full 3D CAD model and CAD-checked rev C design
    CAD (cad/): a parametric CadQuery model of every part of SLR-1, 129 parts and
    215 pieces:
    - nose, tube pieces, couplers, fins and fillets;
    - airbrake petals with hinges, springs, stops and the latch ring;
    - chute bay with door, ejector and U-bolt;
    - avionics bay and every board, battery, switch and antenna;
    - harness;
    - 2-axis gimbal, both motors, sleeves, clips, thrust plate, servos and
    pushrods;
    - exhaust-paddle throttle and lidar;
    - legs with clevis, damper and foot.
    cad/build.py writes:
    - STEP assemblies for the flight and landing configurations (SolidWorks
    opens them as assemblies, one sub-assembly per bay) and per-part STEP files;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
    [ARM-KEY-SW.step, ARM-KEY.step, AV-LID-A.dxf, AV-LID-A.step, AV-LID-F.dxf, AV-LID-F.step, AV-LID-RING-A.step, AV-LID-RING-A.stl]
2026-10-11 Add section-by-section X-ray guide; add airbrake latch servo
    Section guide (docs/14-sections.md):
    - cad/slr1/sections.py: a short label and a one-line description for all
    133 parts, and 8 sections (nose, airbrakes, chute bay, avionics, aft
    airframe, legs, motor bay, throttle) with camera views.
    - Viewer: Sections mode with ghosted skins and numbered callouts placed
    by an ID-buffer pass, so each leader lands on a visible bit of its part;
    dashed leaders for parts hidden behind others.
    - cad/tools/render_sections.mjs renders 18 X-ray views
    (docs/img/sections/) and 133 part thumbnails (docs/img/parts/).
    - cad/tools/section_guide.py writes docs/14 (and the website page) with
    what each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
    [ARM-KEY-SW.step, ARM-KEY.step, AV-LID-A.dxf, AV-LID-A.step, AV-LID-F.dxf, AV-LID-F.step, AV-LID-RING-A.step, AV-LID-RING-F.step]
